sadr0b0t/metalrobot/README.md

metalrobot
==========

Металлический конструктор
