sadr0b0t/metalrobot/Robot Car/коробка/svg4export/README

Перед экспортом для производства (например, лазерной резики) разбить 
пунктирные линии на отдельные сегменты, иначе программа генерации 
задания для станка с ЧПУ будет рассматривать их как сплошные линии:
1. Разруппировать разворот
2. Выделить все пунктирные линии (или весь разворот)
3. Расширения > Изменение контура > Преобразовать в пунктир
