sadr0b0t/metalrobot/doc/robotcar-model2-инструкция-провода/инструкция-провода-Робот_Машинка-модель2-A5.pdf

Инструкция по сборке Робота Машинки подключение проводов

модель 2

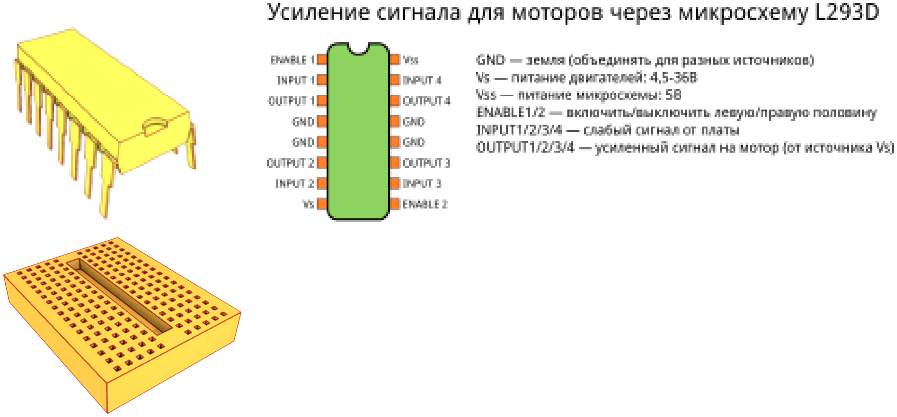
[picture p58: figure]

1

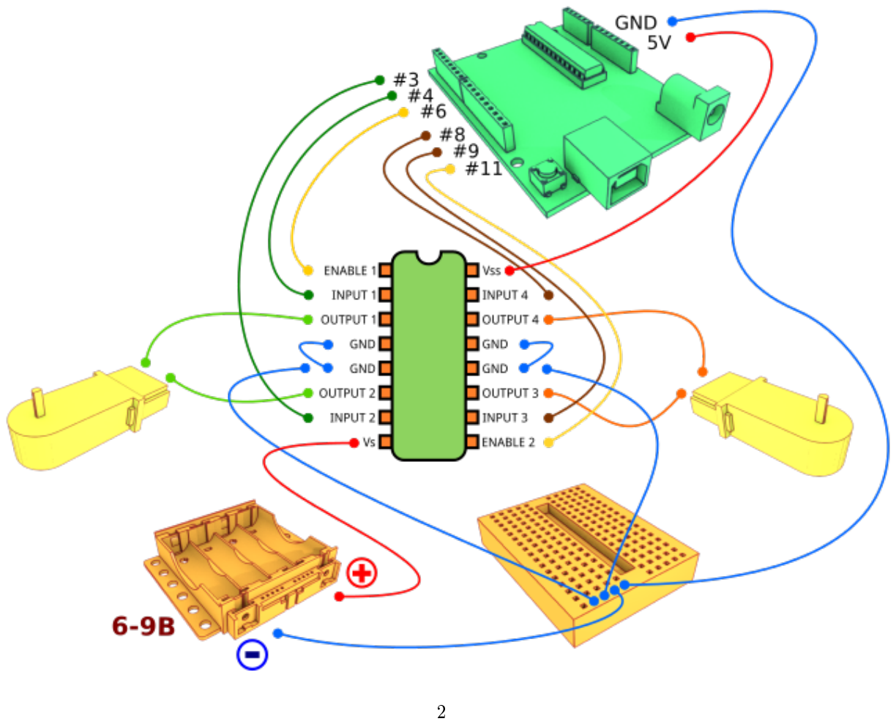
[picture p59: page 2]

2
