sadr0b0t/metalrobot/doc/robotcar-model2-инструкция-брошюра/компоненты - Робот Машинка модель2-A5.pdf

Детали набора Робот Машинка

модель 2

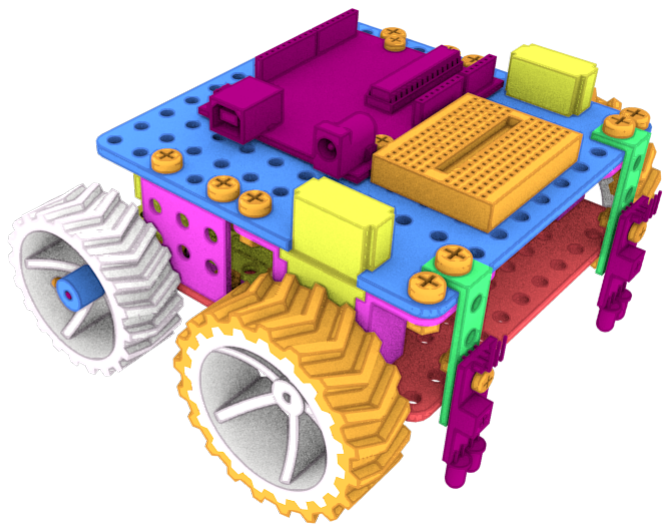
[picture p60: figure]
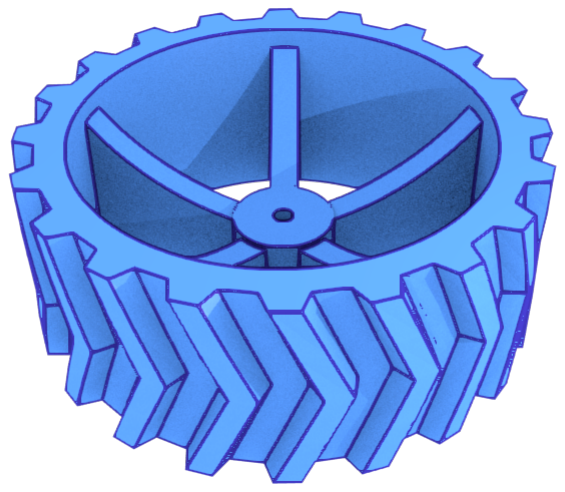
[picture p61: figure]

Колёса | 4 шт

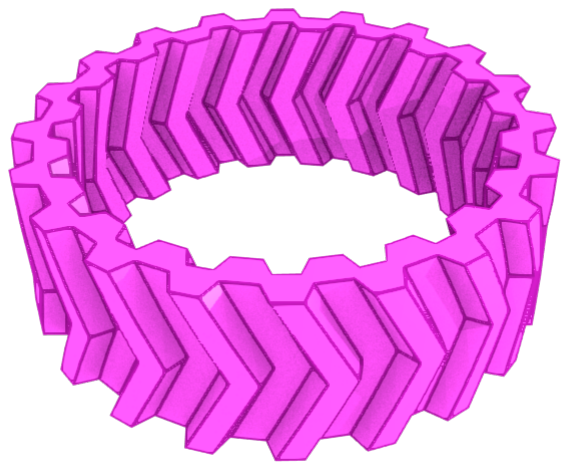
[picture p62: figure]

Покрышки | 2 шт

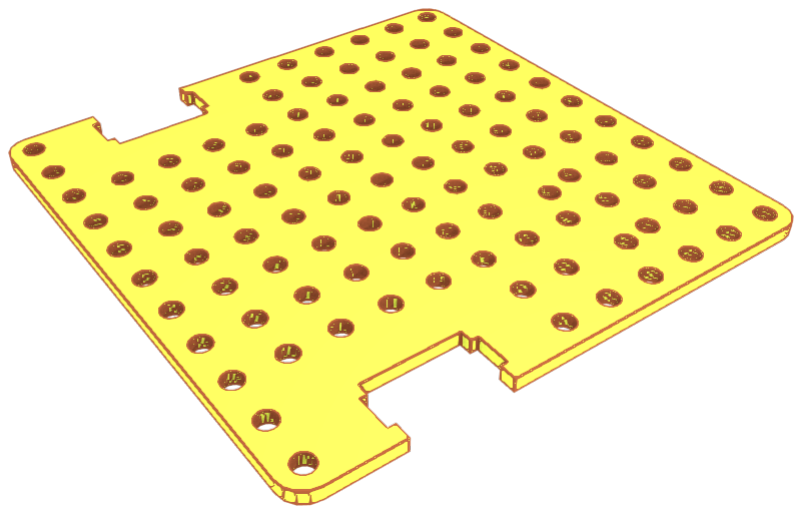
[picture p63: figure]

Верхняя часть корпуса | 1 шт

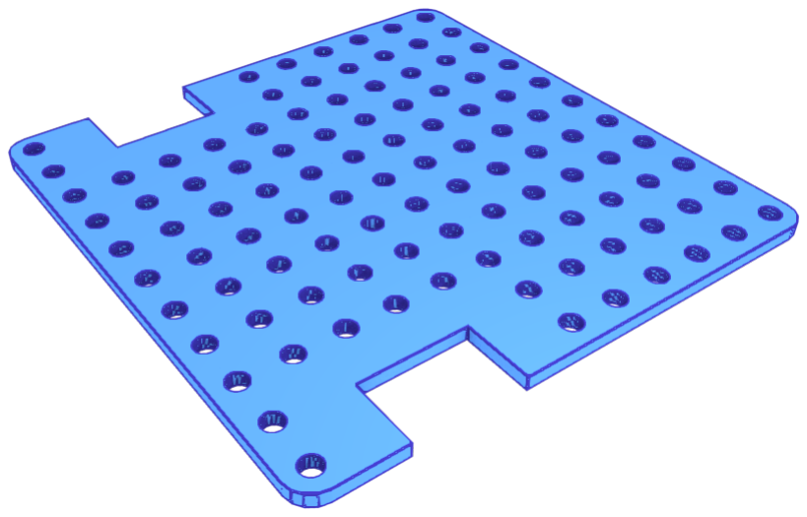
[picture p64: figure]

Нижняя часть корпуса | 1 шт

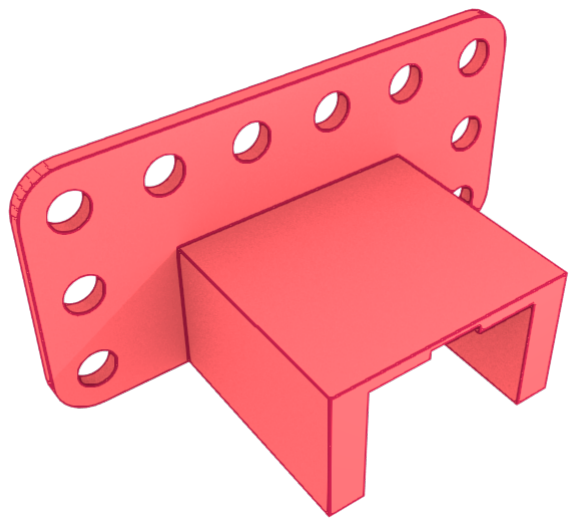
[picture p65: figure]

Крепления моторов | 2 шт

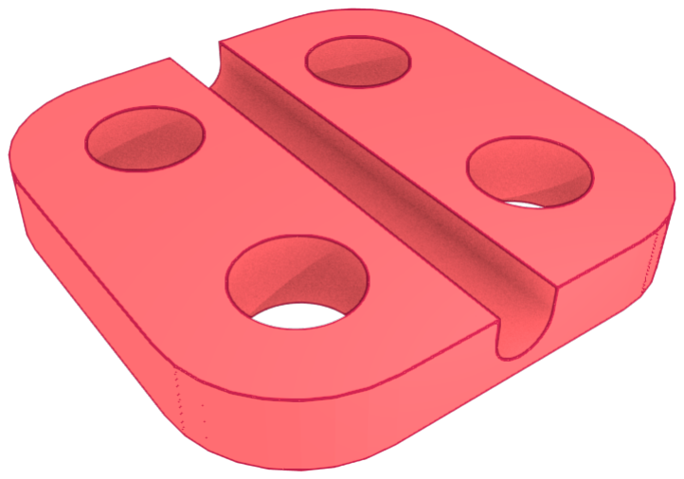
[picture p66: figure]

Направляющие для оси | 2 шт

Боковые стенки | 2 шт
Уголки | 4 шт
Ось для задних колес | 1 шт
Стопорные втулки на ось | 2 шт
Батарейный отсек 4 АА | 1 шт
Мотор-редуктор Pololu | 2 шт
Плата Arduino Uno | 1 шт

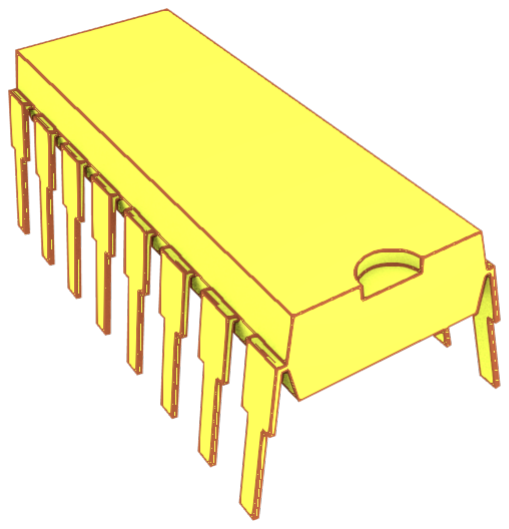
[picture p67: figure]

Микросхема L293D (или аналог) | 1 шт

Макетная плата 17х10 гнезд | 1 шт
Кабель USB A-B | 1 шт
Провод питания платы | 1 шт
Набор соединительных проводов | 1 шт
Шлейф 3 жилы розетка-штепсель | 2 шт
ИК датчик препятствий | 2 шт
Ультразвуковой дальномер | 1 шт

Винт M4x10 | 28 шт
Винт M4x12 | 8 шт
Винт M3x10 | 10 шт
Гайка M4 | 36 шт
Гайка M3 | 10 шт
Шайба пружинная M4 | 36 шт
Шайба пружинная M3 | 10 шт
