sadr0b0t/metalrobot/Robot Car/коробка/export/коробка-ровер-2мм.pdf

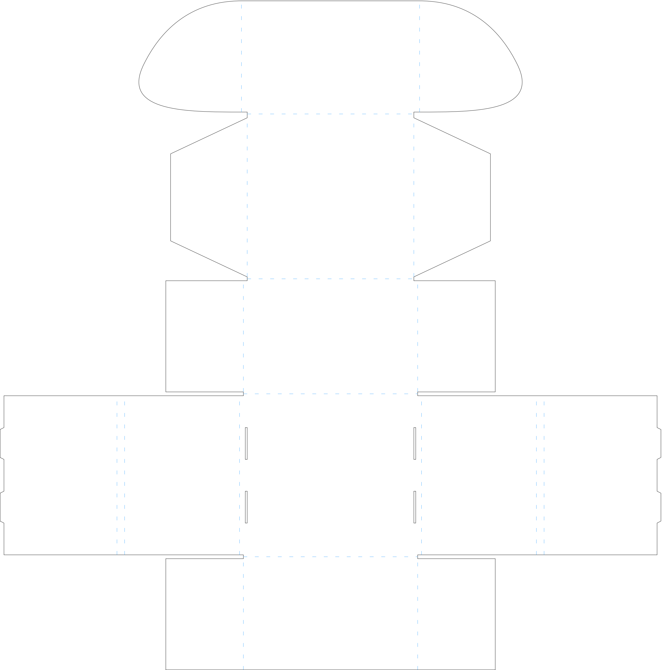
[picture p68: figure]
