sadr0b0t/metalrobot/inkscape/extensions/robotbox-devel/box-a4-w2mm.pdf

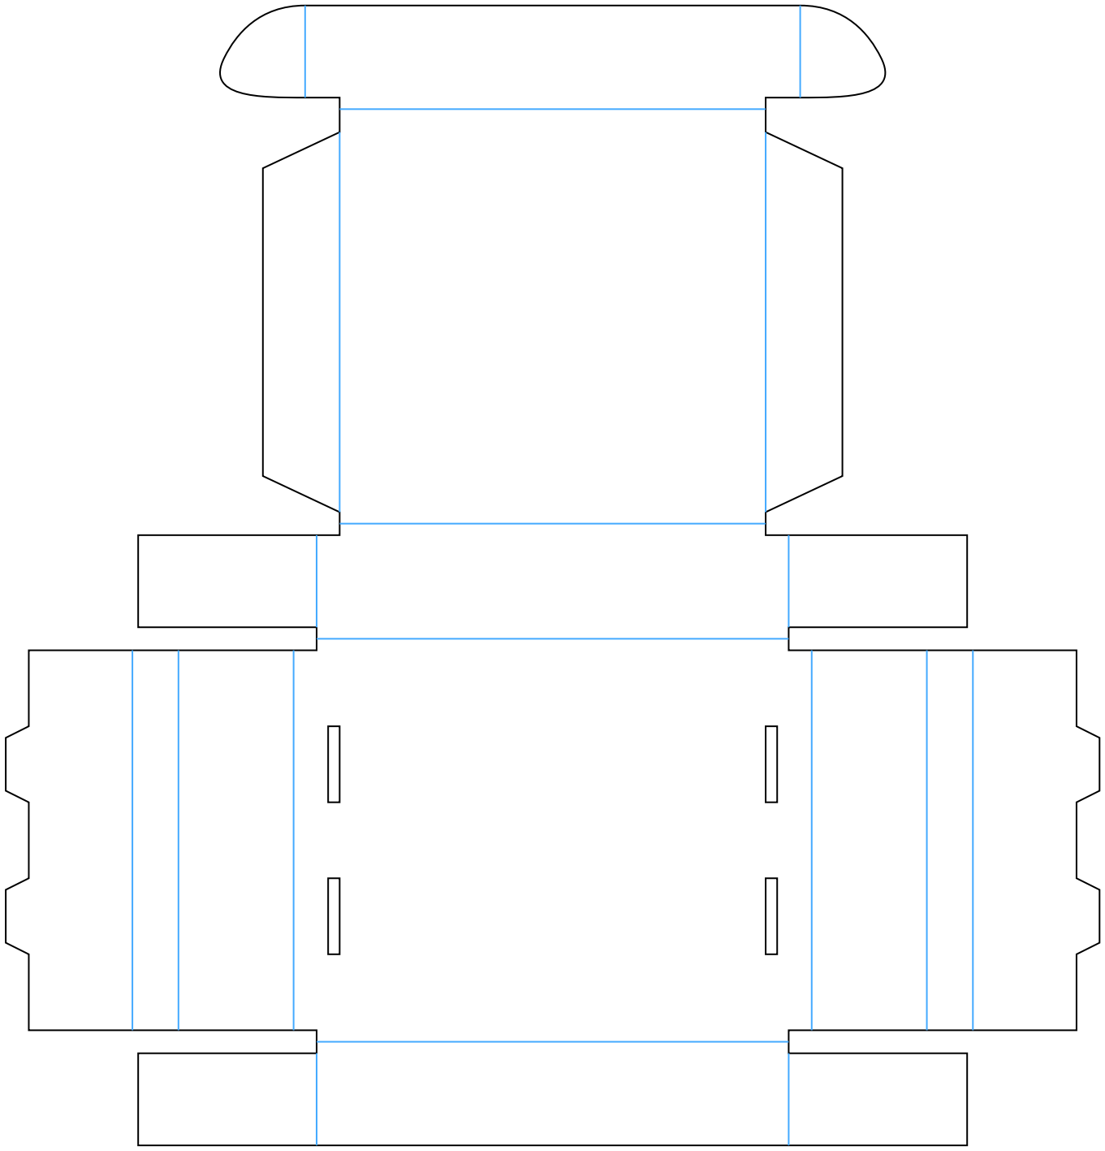
[picture p69: figure]
