sadr0b0t/metalrobot/inkscape/extensions/robotbox-devel/box-a4-w0.5mm.pdf

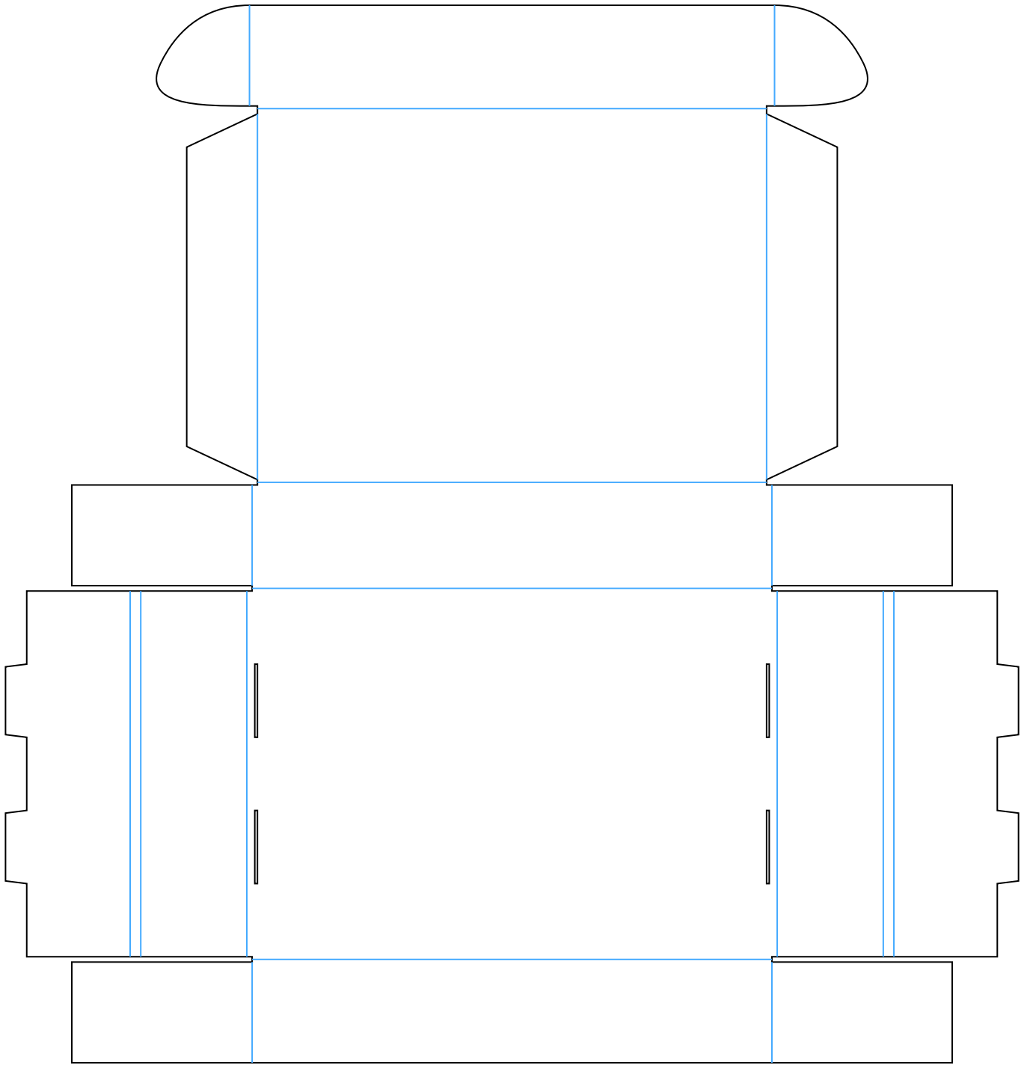
[picture p70: figure]
