sadr0b0t/metalrobot/doc/robotcar-model2-инструкция-компоненты/blender-render/render/arduino-uno-china-cherry.png

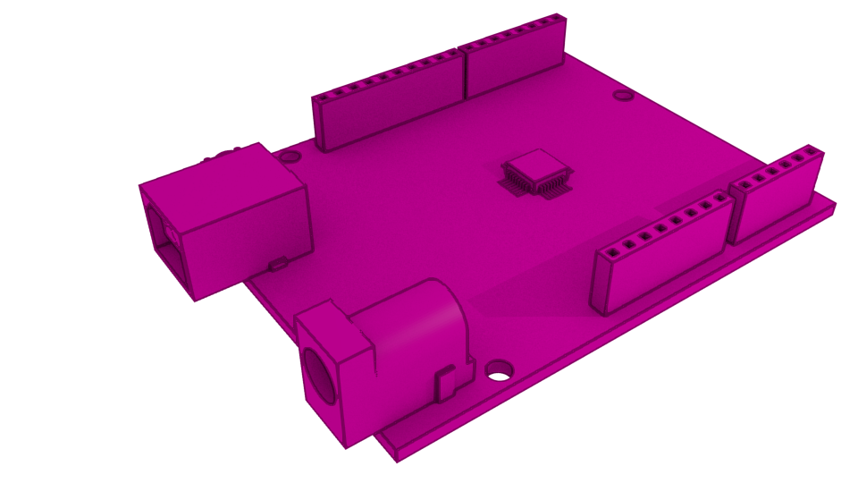
doc/robotcar-model2-инструкция-компоненты/blender-render/render/arduino-uno-china-cherry.png
