sadr0b0t/metalrobot/doc/robotcar-model2-инструкция-компоненты/blender-render/render/axis-d2mm-l150mm-view2-cherry.png

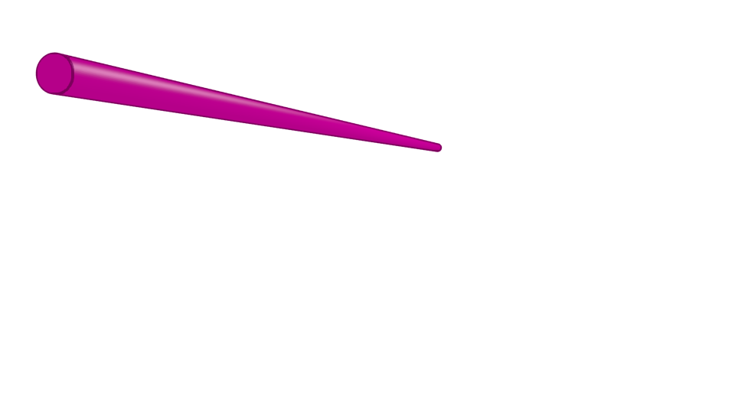
doc/robotcar-model2-инструкция-компоненты/blender-render/render/axis-d2mm-l150mm-view2-cherry.png
