sadr0b0t/metalrobot/doc/robotcar-model2-инструкция-компоненты/blender-render/render/axis-jam-with-screw-view2-blue.png

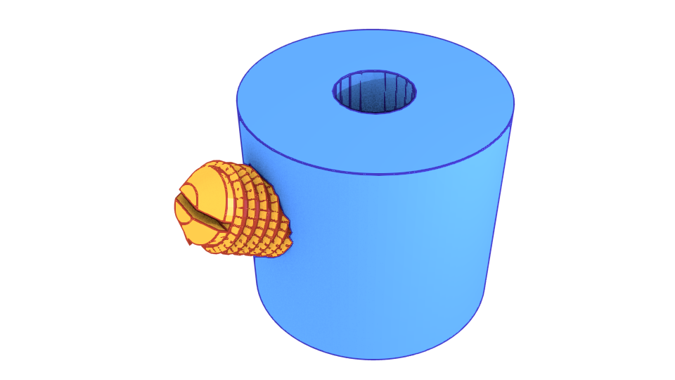
doc/robotcar-model2-инструкция-компоненты/blender-render/render/axis-jam-with-screw-view2-blue.png
