sadr0b0t/metalrobot/doc/robotcar-model2-инструкция-компоненты/blender-render/render/bus-3pin-female-male-blue.png

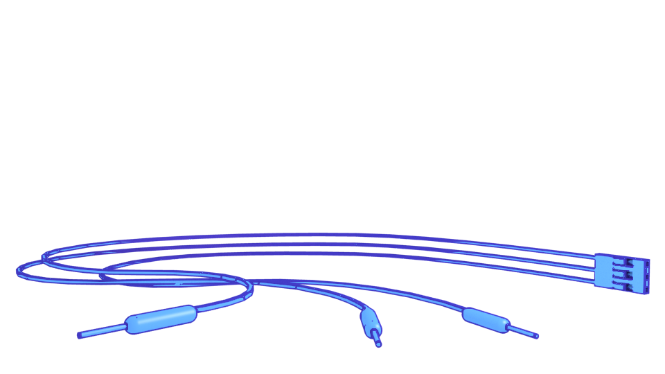
doc/robotcar-model2-инструкция-компоненты/blender-render/render/bus-3pin-female-male-blue.png
