sadr0b0t/metalrobot/doc/robotcar-model2-инструкция-компоненты/blender-render/render/chip-dip-2x8-dark.png

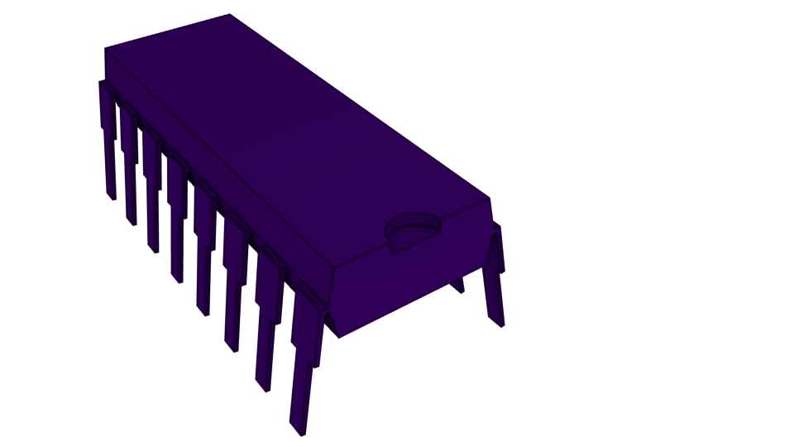
doc/robotcar-model2-инструкция-компоненты/blender-render/render/chip-dip-2x8-dark.png
