sadr0b0t/metalrobot/doc/robotcar-model2-инструкция-компоненты/blender-render/render/chipkit-uno32-view2-cherry.png

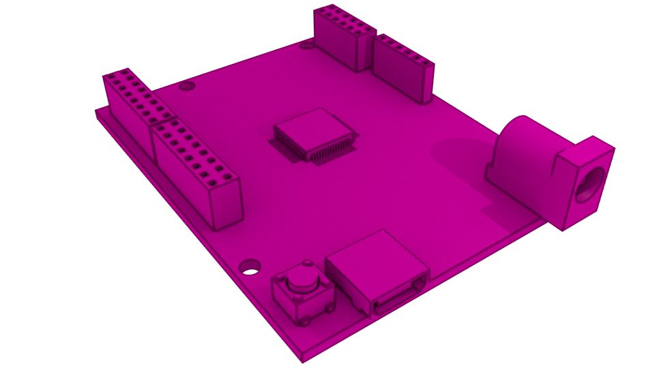
doc/robotcar-model2-инструкция-компоненты/blender-render/render/chipkit-uno32-view2-cherry.png
