sadr0b0t/metalrobot/doc/robotcar-model2-инструкция-компоненты/blender-render/render/frame-bottom-yellow.png

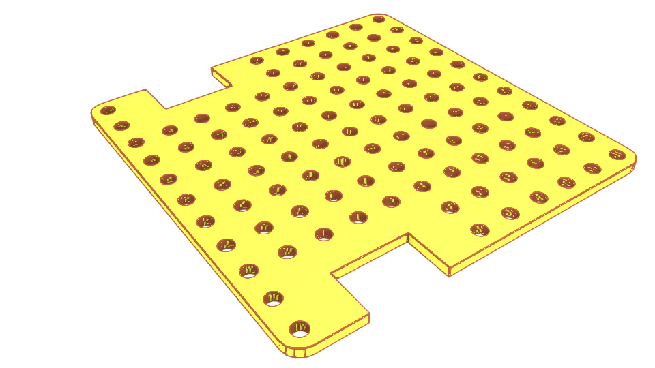
doc/robotcar-model2-инструкция-компоненты/blender-render/render/frame-bottom-yellow.png
