sadr0b0t/metalrobot/doc/robotcar-model2-инструкция-компоненты/blender-render/render/screws/crosshead-screw-m3x26-orange.png

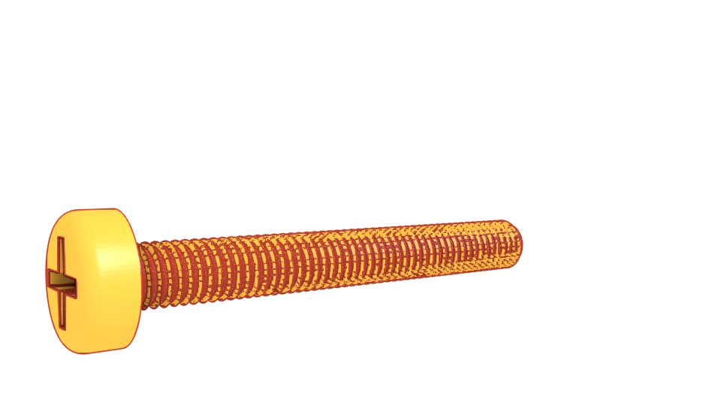
doc/robotcar-model2-инструкция-компоненты/blender-render/render/screws/crosshead-screw-m3x26-orange.png
