sadr0b0t/metalrobot/doc/robotcar-model2-инструкция-компоненты/blender-render/render/screws/ISOThread-default/crosshead-screw-m4x40-orange.png

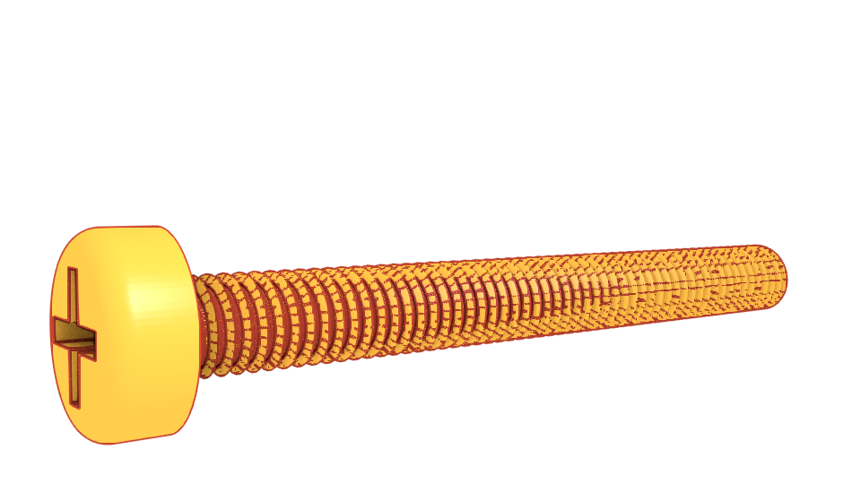
doc/robotcar-model2-инструкция-компоненты/blender-render/render/screws/ISOThread-default/crosshead-screw-m4x40-orange.png
