sadr0b0t/metalrobot/doc/robotcar-model2-инструкция-компоненты/blender-render/render/wheel1.png

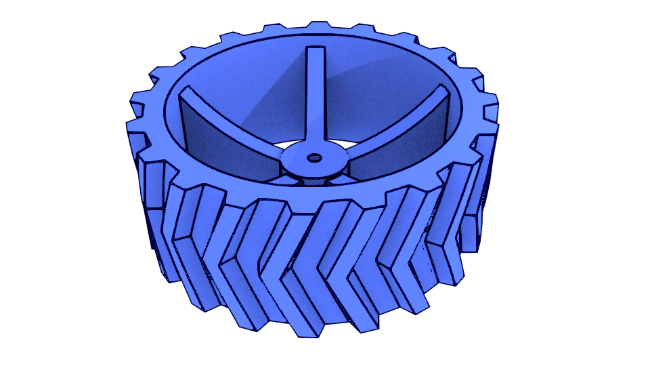
doc/robotcar-model2-инструкция-компоненты/blender-render/render/wheel1.png
