sadr0b0t/metalrobot/doc/robotcar-model2-инструкция-компоненты/export-png/компоненты-03.png

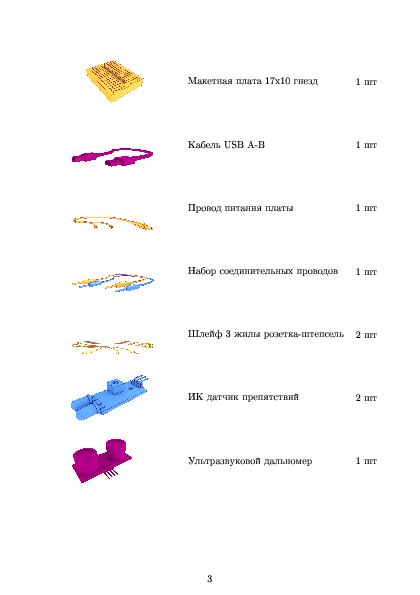
doc/robotcar-model2-инструкция-компоненты/export-png/компоненты-03.png
