sadr0b0t/metalrobot/doc/robotcar-model2-инструкция-компоненты/export-png/компоненты-04.png

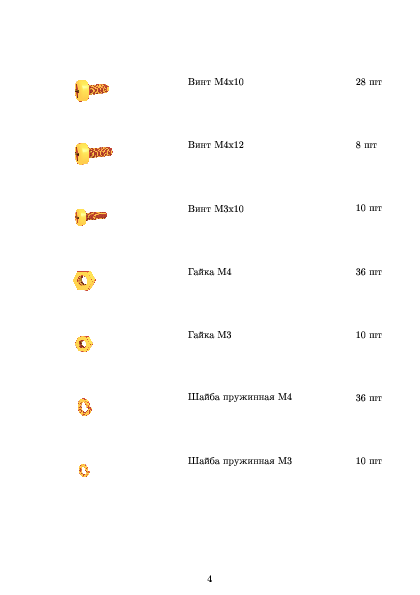
doc/robotcar-model2-инструкция-компоненты/export-png/компоненты-04.png
