sadr0b0t/metalrobot/doc/robotcar-model2-инструкция-компоненты/fig/model2-render3.png

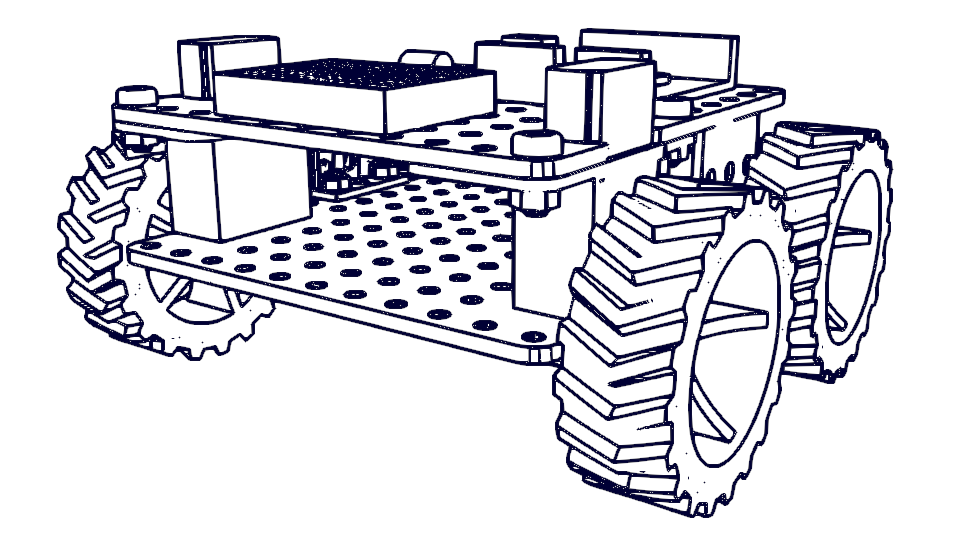
doc/robotcar-model2-инструкция-компоненты/fig/model2-render3.png
