sadr0b0t/metalrobot/doc/robotcar-model2-инструкция-компоненты/fig/robotcar-sideview.jpg

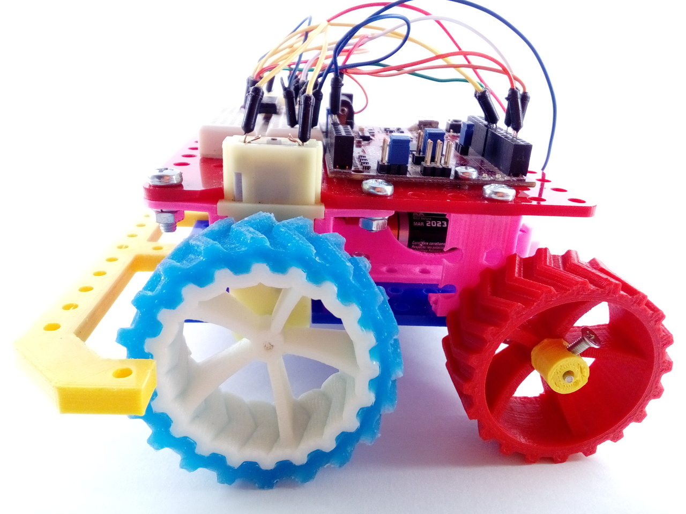
doc/robotcar-model2-инструкция-компоненты/fig/robotcar-sideview.jpg
