sadr0b0t/metalrobot/doc/robotcar-model2-инструкция-корпус/blender-render/render-instr/03-top-block1-dev-view3.png

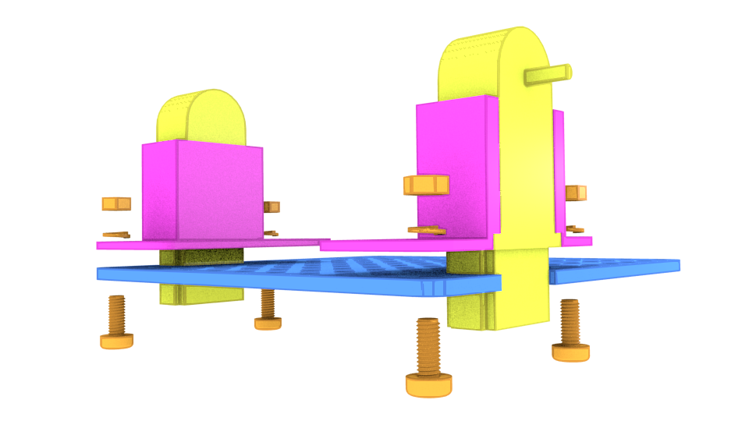
doc/robotcar-model2-инструкция-корпус/blender-render/render-instr/03-top-block1-dev-view3.png
