sadr0b0t/metalrobot/doc/robotcar-model2-инструкция-корпус/blender-render/render-instr/04-top-block1-view1.png

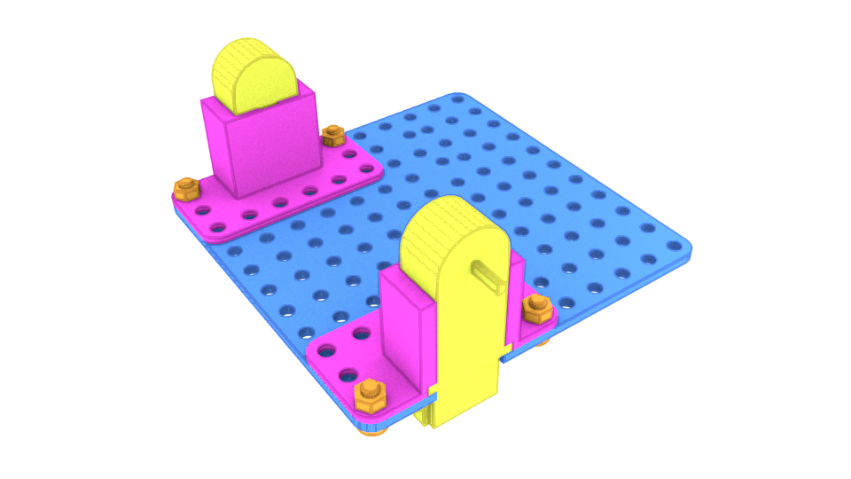
doc/robotcar-model2-инструкция-корпус/blender-render/render-instr/04-top-block1-view1.png
