sadr0b0t/metalrobot/doc/robotcar-model2-инструкция-корпус/blender-render/render-instr/15-frame-block2-dev1-view2.png

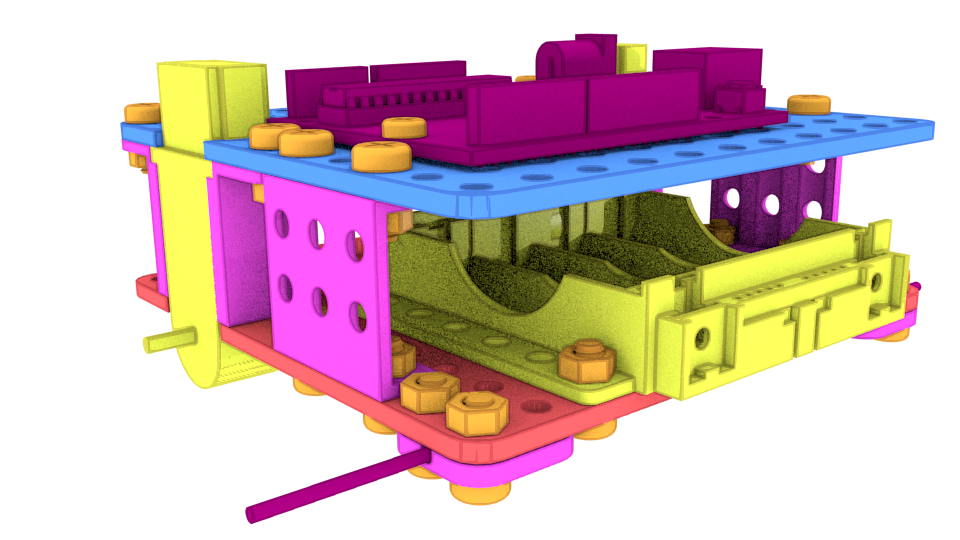
doc/robotcar-model2-инструкция-корпус/blender-render/render-instr/15-frame-block2-dev1-view2.png
