sadr0b0t/metalrobot/doc/robotcar-model2-инструкция-корпус/blender-render/render-instr/16-frame-block2-dev2-view1.png

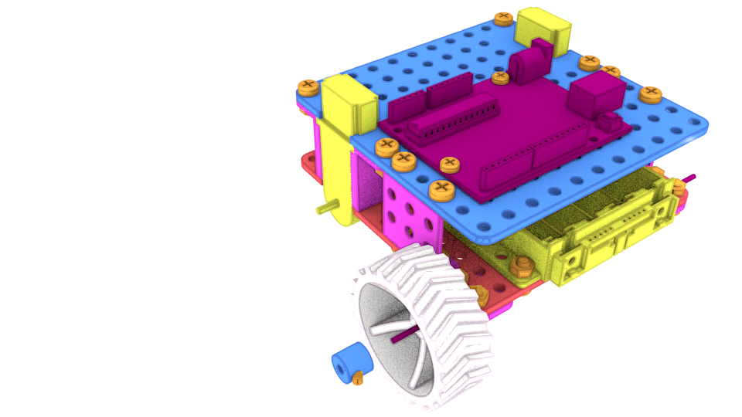
doc/robotcar-model2-инструкция-корпус/blender-render/render-instr/16-frame-block2-dev2-view1.png
