sadr0b0t/metalrobot/doc/robotcar-model2-инструкция-корпус/blender-render/render-instr/19-wheel-and-tyre-view1.png

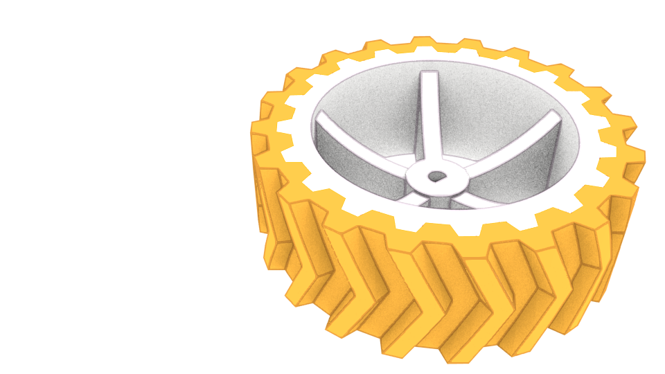
doc/robotcar-model2-инструкция-корпус/blender-render/render-instr/19-wheel-and-tyre-view1.png
