sadr0b0t/metalrobot/doc/robotcar-model2-инструкция-корпус/blender-render/render-instr/20-frame-block3-dev-view3.png

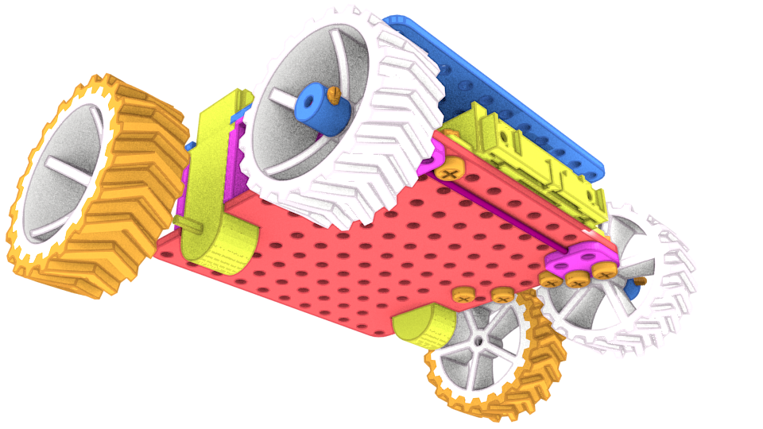
doc/robotcar-model2-инструкция-корпус/blender-render/render-instr/20-frame-block3-dev-view3.png
