sadr0b0t/metalrobot/doc/robotcar-model2-инструкция-корпус/blender-render/render-instr/21-frame-block3-view2.png

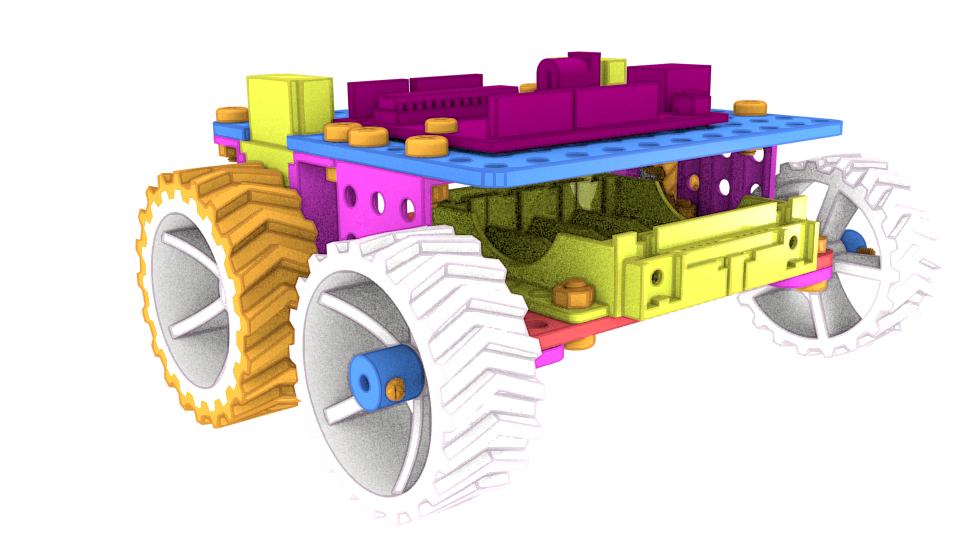
doc/robotcar-model2-инструкция-корпус/blender-render/render-instr/21-frame-block3-view2.png
