sadr0b0t/metalrobot/doc/robotcar-model2-инструкция-корпус/blender-render/render/robotcar-model2-skeleton.png

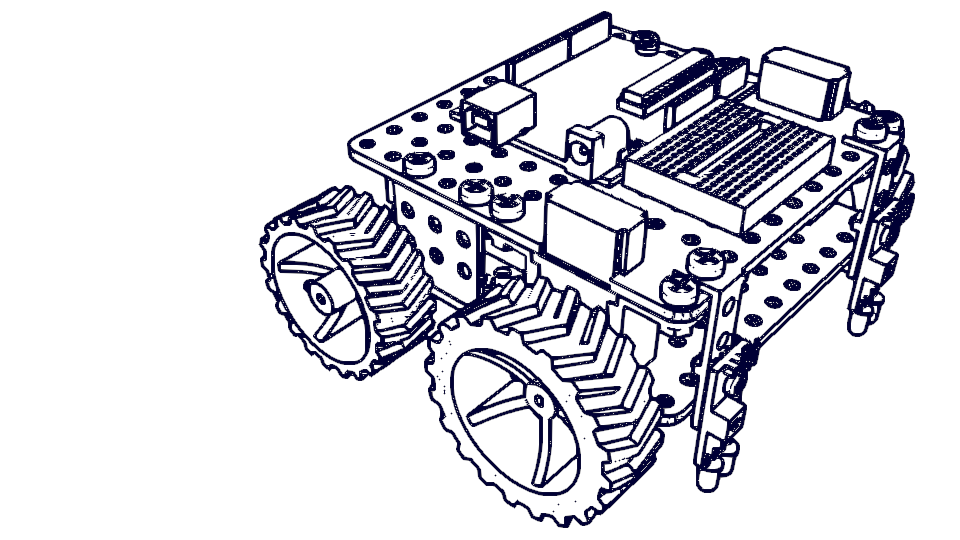
doc/robotcar-model2-инструкция-корпус/blender-render/render/robotcar-model2-skeleton.png
