sadr0b0t/metalrobot/doc/robotcar-model2-инструкция-провода/instr-pages/export-png/01-connect-motors.png

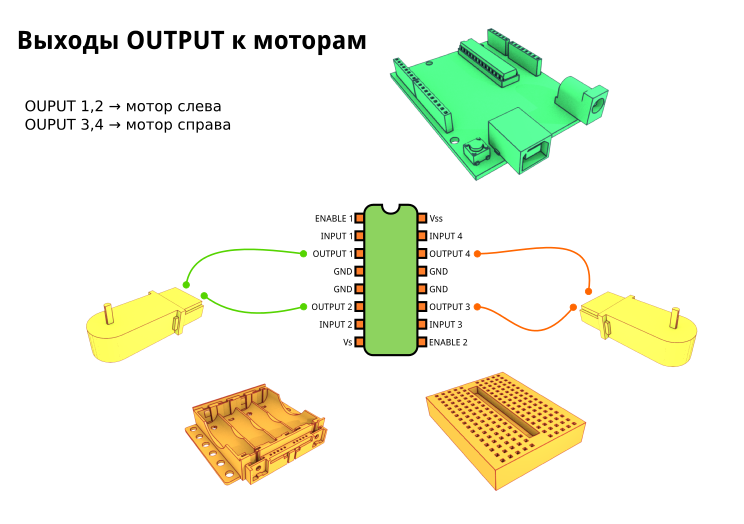
doc/robotcar-model2-инструкция-провода/instr-pages/export-png/01-connect-motors.png
