sadr0b0t/metalrobot/doc/robotcar-model2-инструкция-провода/instr-pages/export-png/02-connect-inputs.png

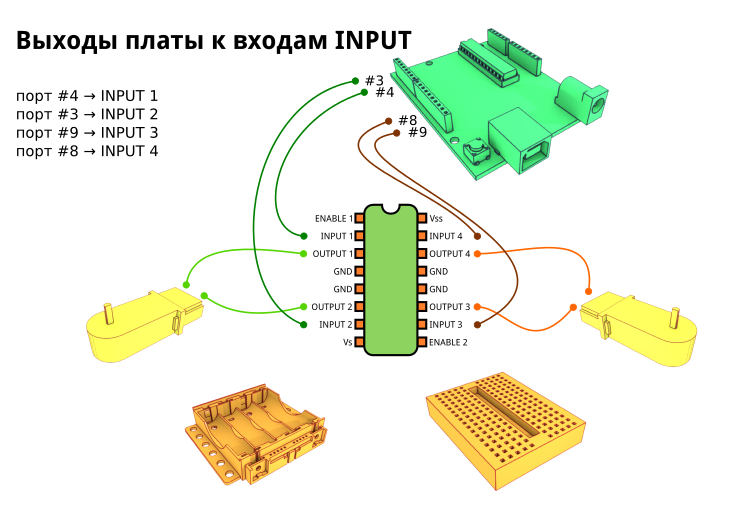
doc/robotcar-model2-инструкция-провода/instr-pages/export-png/02-connect-inputs.png
