sadr0b0t/metalrobot/doc/robotcar-model2-инструкция-провода/instr-pages/export-png/04-combine-ext-GND.png

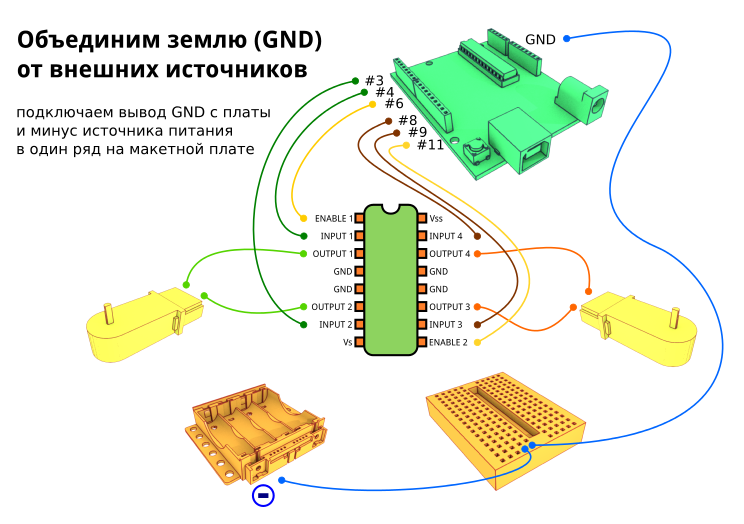
doc/robotcar-model2-инструкция-провода/instr-pages/export-png/04-combine-ext-GND.png
