sadr0b0t/metalrobot/doc/robotcar-model2-инструкция-провода/instr-pages/export-png/07-connect-VS.png

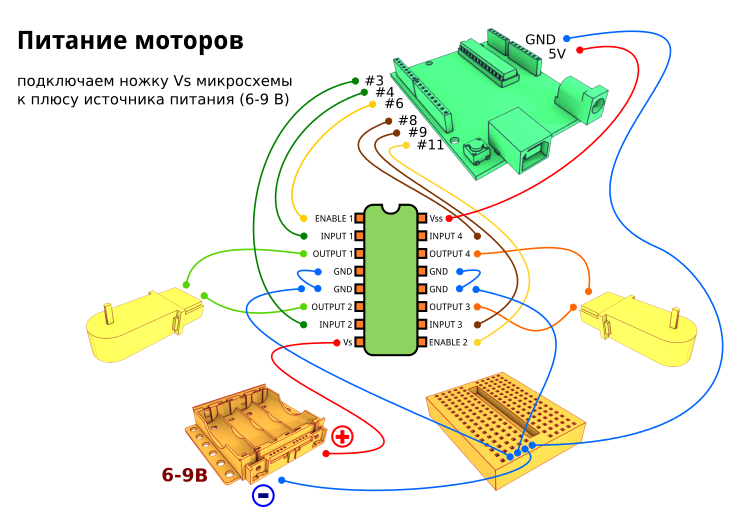
doc/robotcar-model2-инструкция-провода/instr-pages/export-png/07-connect-VS.png
