sadr0b0t/metalrobot/gearbox/gearbox-prototype5/rod-3mm.png

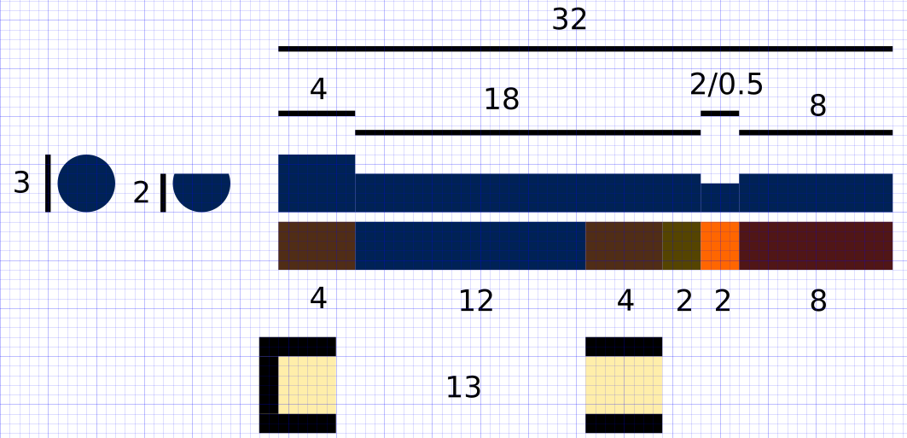
gearbox/gearbox-prototype5/rod-3mm.png
