sadr0b0t/metalrobot/Robot Car/коробка/design1/sadrobot.su-qr.gif

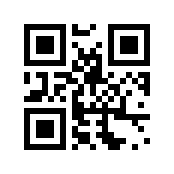
Robot Car/коробка/design1/sadrobot.su-qr.gif
