sadr0b0t/metalrobot/Robot Car/уроки/по линии/robotcar_line.png

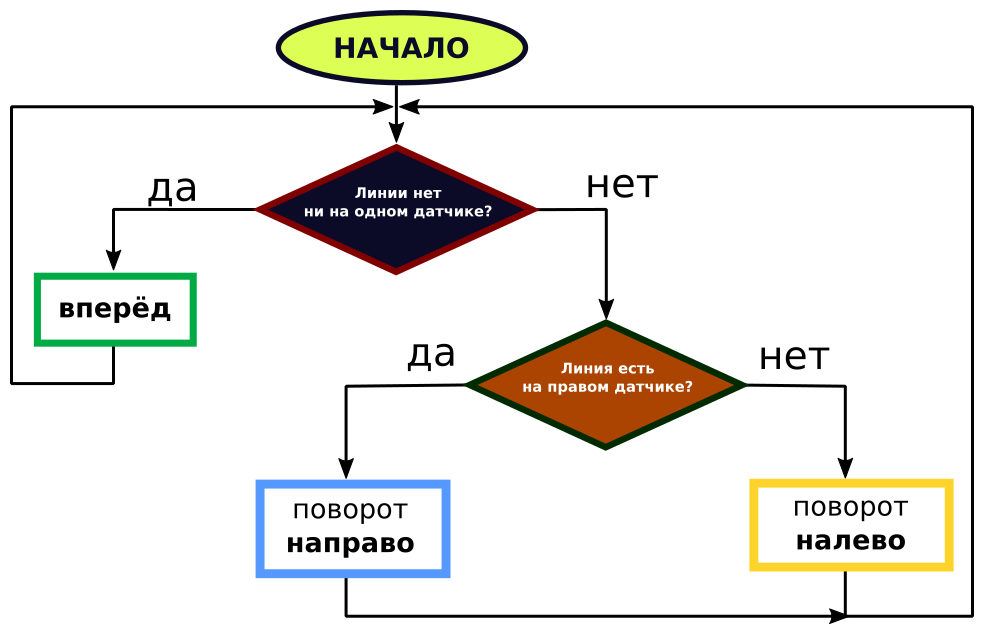
Robot Car/уроки/по линии/robotcar_line.png
