sadr0b0t/metalrobot/components-3d/screws/3pty/README.txt

Сторонние библиотеки
Third party libraries

ISOThread - генератор винтов и гаек (Creative Commons - Public Domain Dedication license.)
Trevor Moseley
http://www.thingiverse.com/thing:311031
