sadr0b0t/metalrobot/parts/export/all-details.png

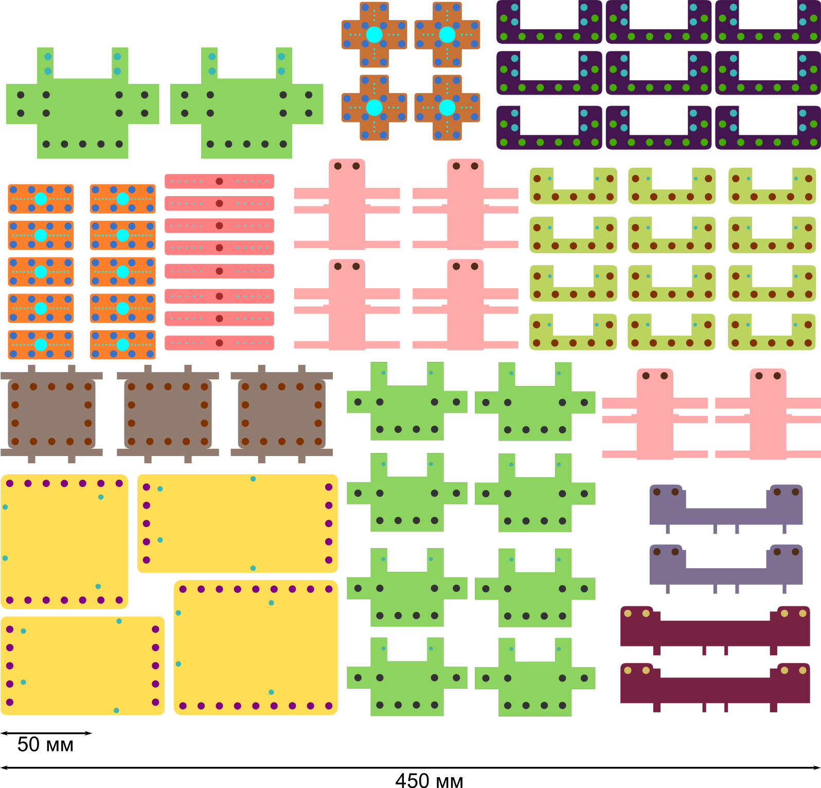
parts/export/all-details.png
