sadr0b0t/metalrobot/battery-holder/contacts-draft2/export/wire-plate2.dxf

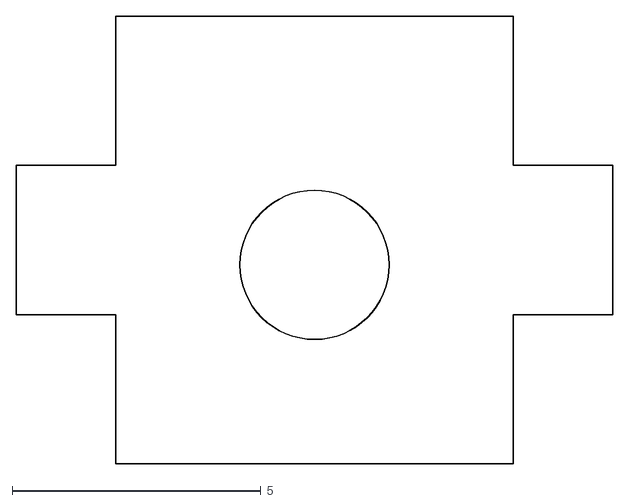
[picture p118: CAD file, 2015-09-19]
battery-holder/contacts-draft2/export/wire-plate2.dxf
12.0 x 9.00
