sadr0b0t/metalrobot/battery-holder/contacts-draft4/export/wire-plate1.dxf

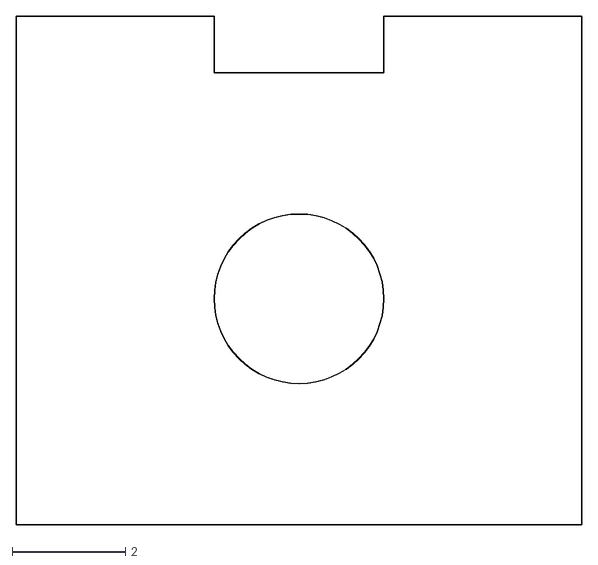
[picture p119: CAD file, 2016-01-24]
battery-holder/contacts-draft4/export/wire-plate1.dxf
10.0 x 9.00
