sadr0b0t/metalrobot/battery-holder/credits-43d.dxf

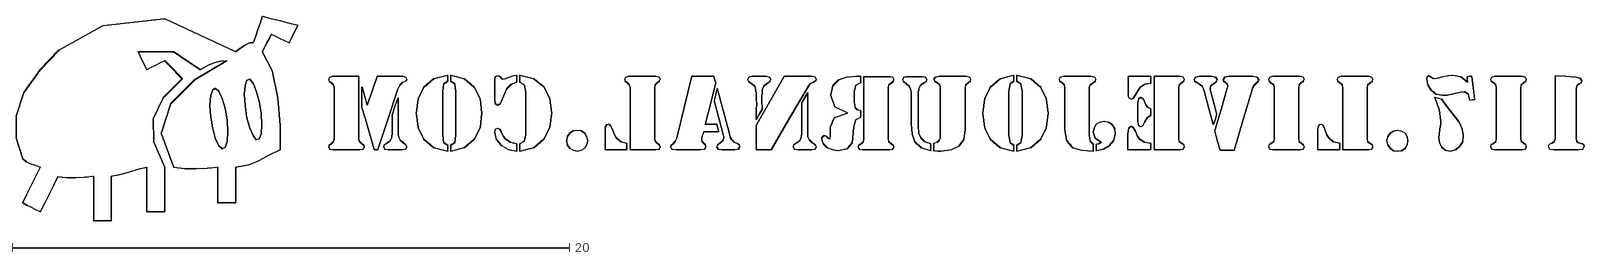
[picture p120: CAD file, 2015-12-16]
battery-holder/credits-43d.dxf
56.3 x 7.33
