sadr0b0t/metalrobot/battery-holder/export/battery-aa-holder-4-mod4.stl

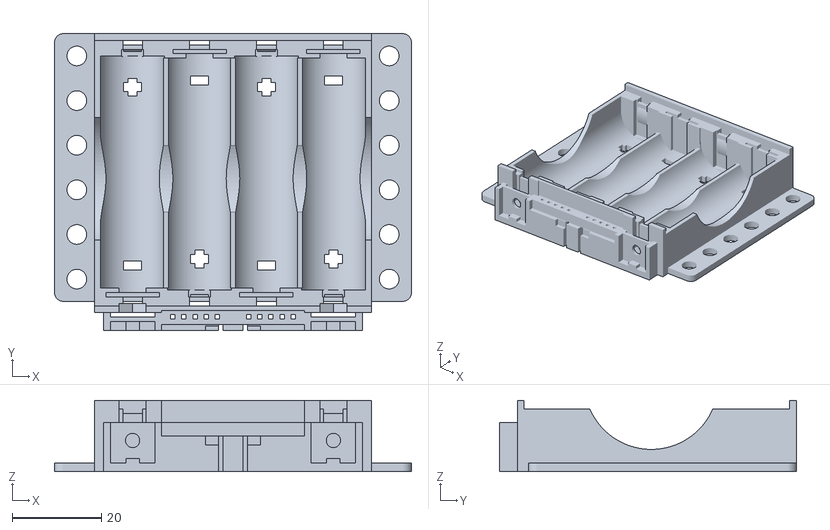
[picture p121: CAD file, 2016-04-05]
battery-holder/export/battery-aa-holder-4-mod4.stl
80.0 x 66.5 x 16.0
