sadr0b0t/metalrobot/brbrd-bender/brbrd-bender-socket-43d.dxf

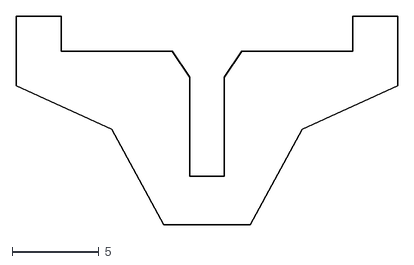
[picture p122: CAD file, 2015-12-28]
brbrd-bender/brbrd-bender-socket-43d.dxf
22.0 x 12.0
