sadr0b0t/metalrobot/brbrd-bender/export/brbrd-bender-plug-pe0.3.stl

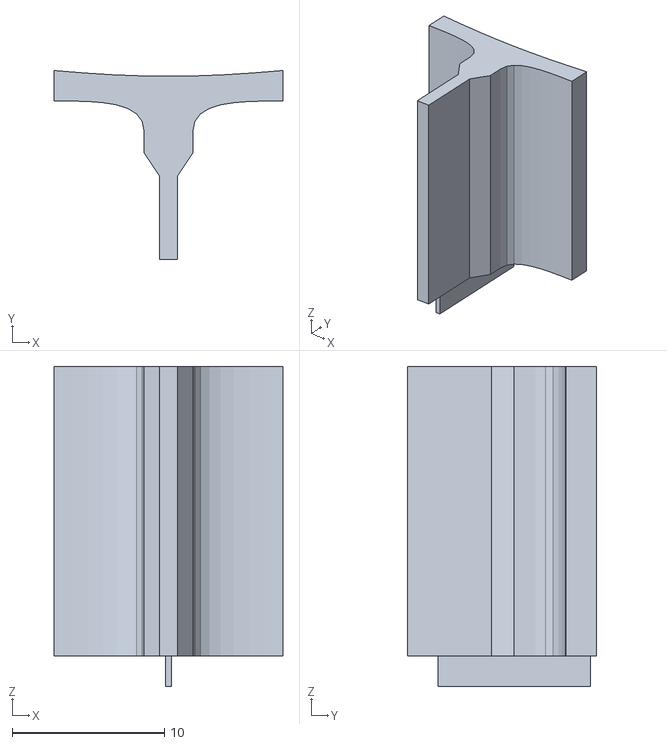
[picture p123: CAD file, 2016-02-06]
brbrd-bender/export/brbrd-bender-plug-pe0.3.stl
15.0 x 12.4 x 21.0
