sadr0b0t/metalrobot/components-3d/wires/export/u-shape_terminal.stl

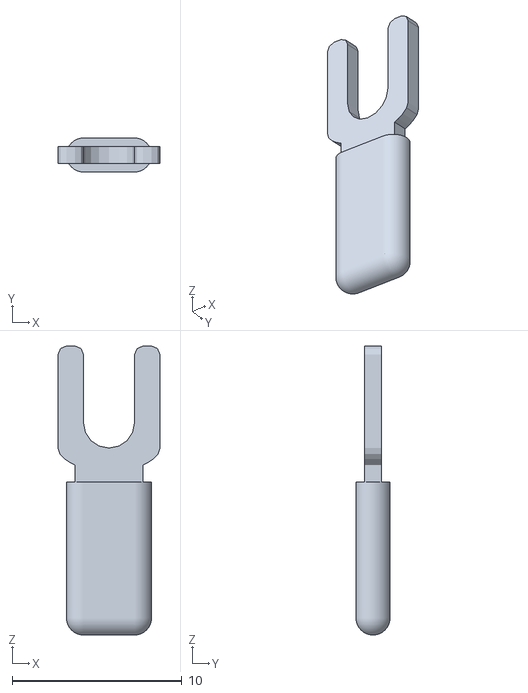
[picture p124: CAD file, 2016-05-25]
components-3d/wires/export/u-shape_terminal.stl
6.00 x 2.00 x 17.0
