sadr0b0t/metalrobot/components-3d/wires/wire2-core1-d2mm-43d.dxf

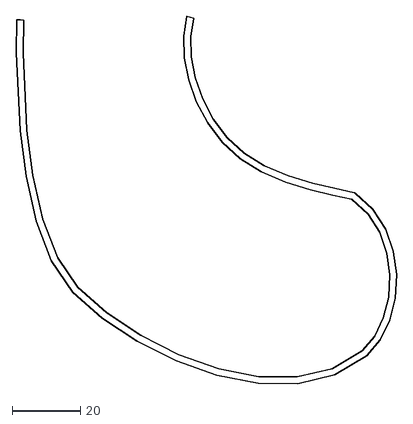
[picture p125: CAD file, 2016-05-25]
components-3d/wires/wire2-core1-d2mm-43d.dxf
111.4 x 107.6
