sadr0b0t/metalrobot/doc/robotcar-model2-инструкция-компоненты/blender-render/stl-addons/tyre_inner_surface.stl

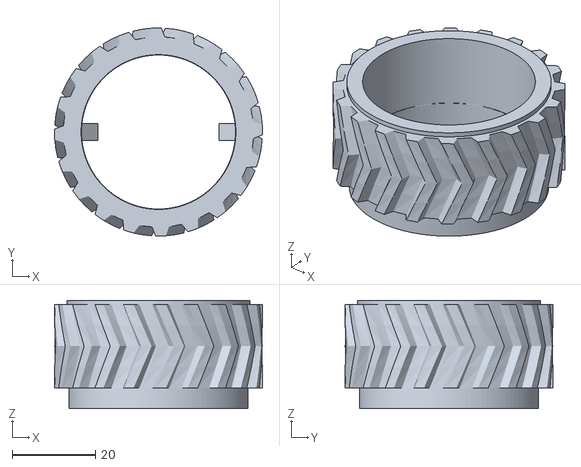
[picture p126: CAD file, 2016-05-22]
doc/robotcar-model2-инструкция-компоненты/blender-render/stl-addons/tyre_inner_surface.stl
50.0 x 50.0 x 26.0
