sadr0b0t/metalrobot/doc/robotcar-model2-инструкция-корпус/blender-render/stl-components/sonar.stl

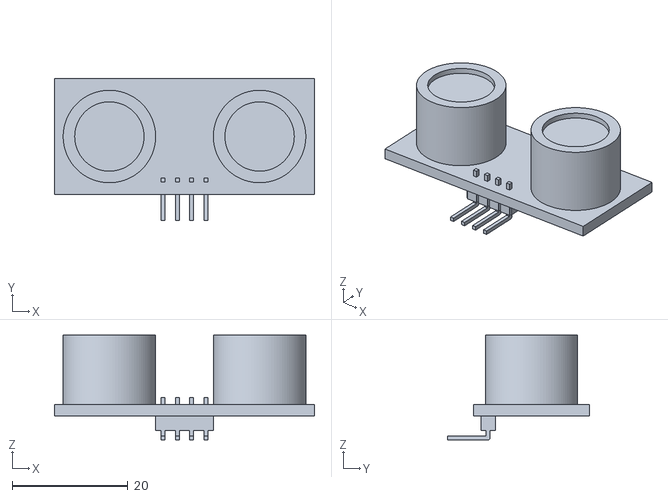
[picture p127: CAD file, 2016-06-06]
doc/robotcar-model2-инструкция-корпус/blender-render/stl-components/sonar.stl
45.0 x 24.5 x 18.1
