sadr0b0t/metalrobot/doc/robotcar-model2-инструкция-корпус/blender-render/stl-parts/frame-bottom.stl

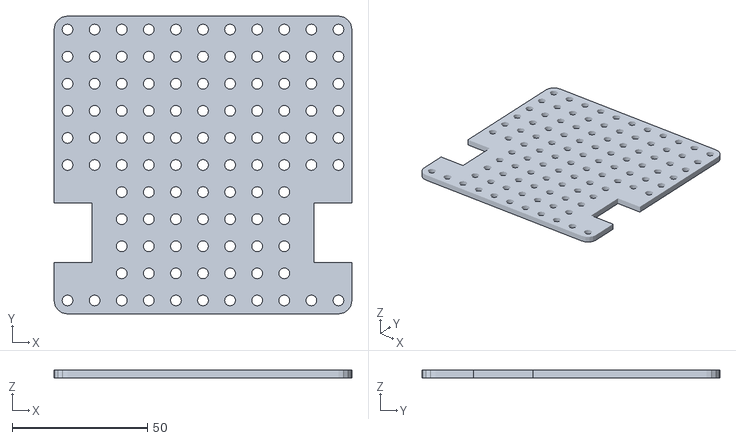
[picture p128: CAD file, 2016-05-25]
doc/robotcar-model2-инструкция-корпус/blender-render/stl-parts/frame-bottom.stl
110.0 x 110.0 x 3.00
