sadr0b0t/metalrobot/gearbox/gearbox-prototype5/export/gearbox-half-motor.stl

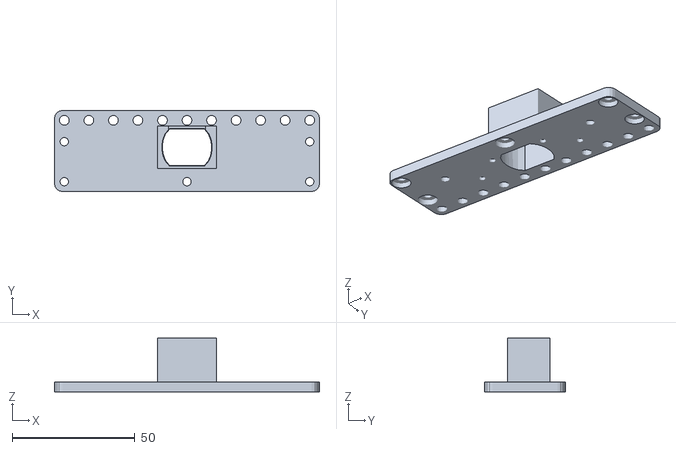
[picture p129: CAD file, 2015-09-13]
gearbox/gearbox-prototype5/export/gearbox-half-motor.stl
108.0 x 33.0 x 21.9
