sadr0b0t/metalrobot/gearbox/gearbox-prototype5/gears/gear-pa20-cp1.5-t12.dxf

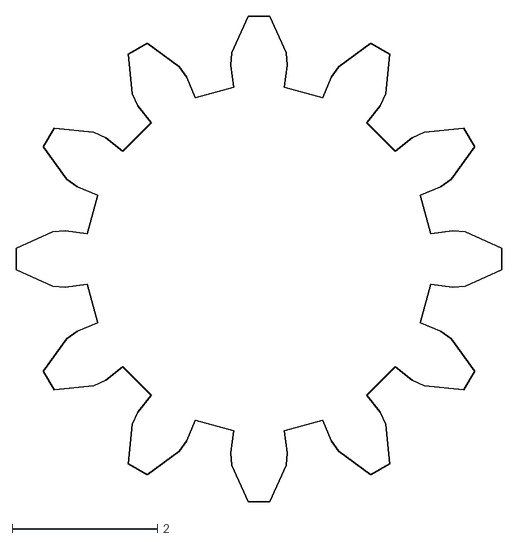
[picture p130: CAD file, 2015-08-13]
gearbox/gearbox-prototype5/gears/gear-pa20-cp1.5-t12.dxf
6.68 x 6.68
