sadr0b0t/metalrobot/gearbox/gears-3dprint-tests/export/gears-cp1.5-t9-d3.stl

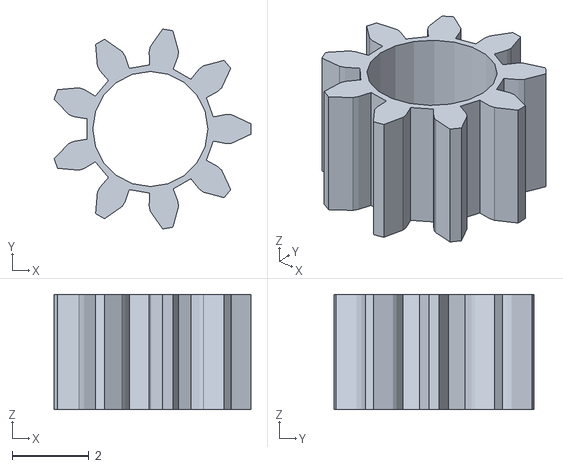
[picture p131: CAD file, 2015-07-16]
gearbox/gears-3dprint-tests/export/gears-cp1.5-t9-d3.stl
5.13 x 5.21 x 3.00
