sadr0b0t/metalrobot/gearbox/gears-3dprint-tests/gear-cp1.5-t27.dxf

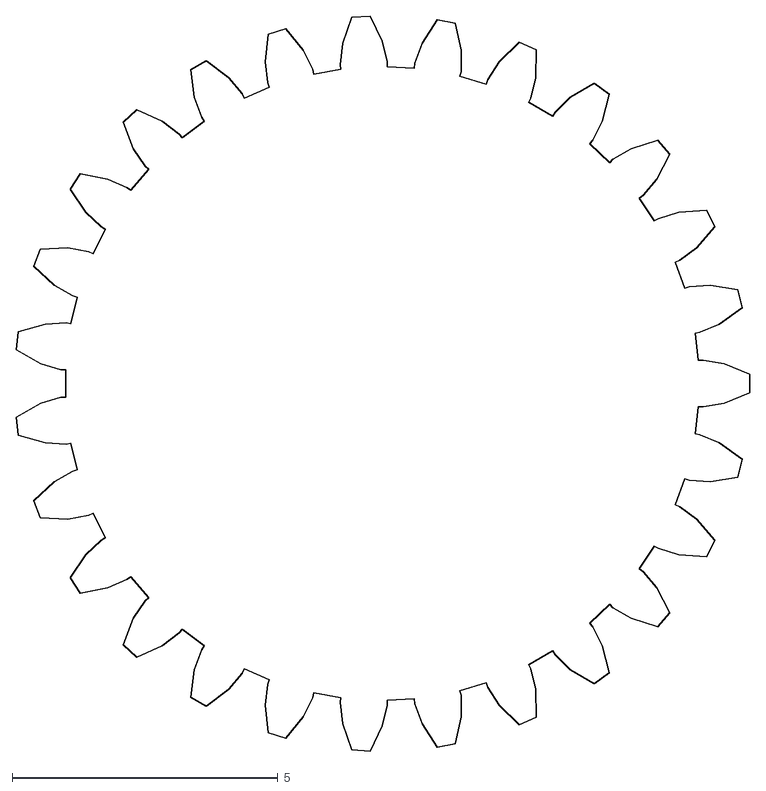
[picture p132: CAD file, 2015-07-16]
gearbox/gears-3dprint-tests/gear-cp1.5-t27.dxf
13.8 x 13.8
