sadr0b0t/metalrobot/gearbox4stepper/stepper-rack-prototype1/box/export-pe0.1/smg-gear_transmission1-pe0.1.stl

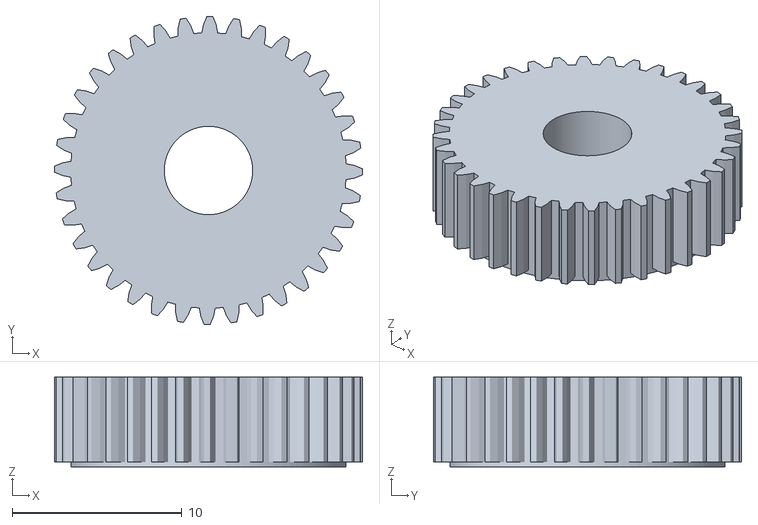
[picture p133: CAD file, 2018-05-07]
gearbox4stepper/stepper-rack-prototype1/box/export-pe0.1/smg-gear_transmission1-pe0.1.stl
18.1 x 18.1 x 5.30
