sadr0b0t/metalrobot/gearbox4stepper/stepper-rack-prototype1/box/export-pe0.2/smg-gear_motor-ds-pe0.2.stl

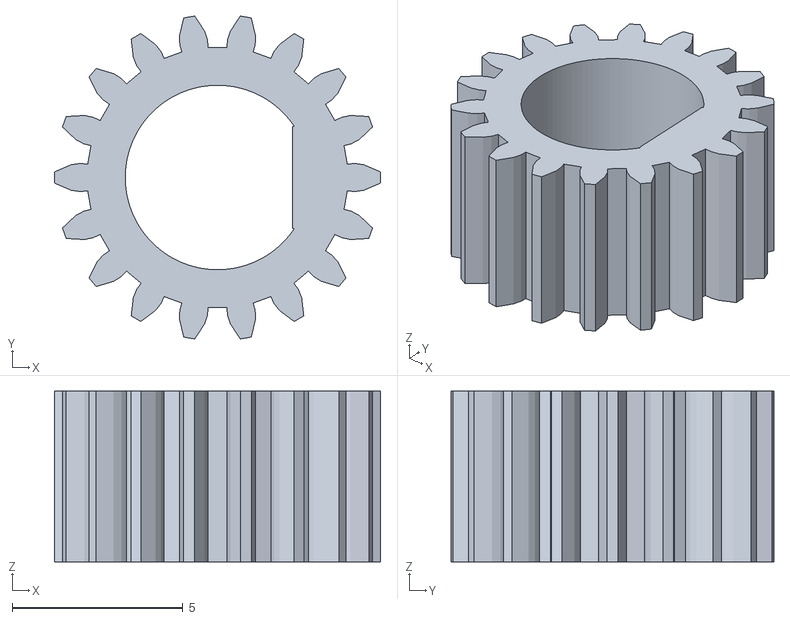
[picture p134: CAD file, 2018-05-07]
gearbox4stepper/stepper-rack-prototype1/box/export-pe0.2/smg-gear_motor-ds-pe0.2.stl
9.54 x 9.46 x 5.00
