sadr0b0t/metalrobot/gearbox4stepper/stepper-rack-prototype1/box/motor_face.dxf

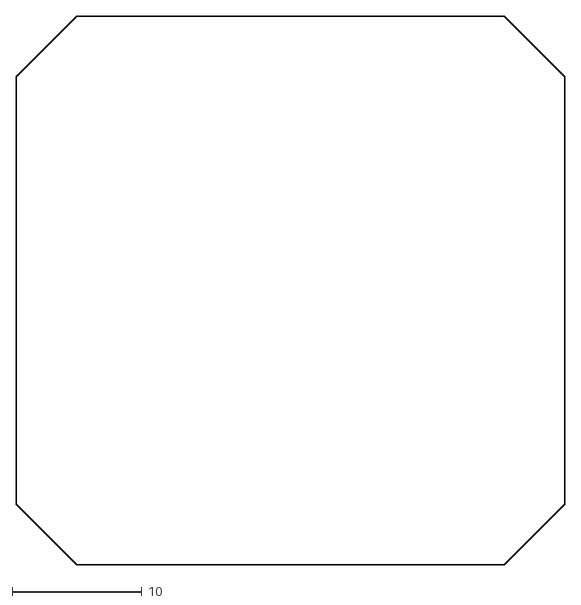
[picture p135: CAD file, 2018-05-07]
gearbox4stepper/stepper-rack-prototype1/box/motor_face.dxf
42.3 x 42.3
