sadr0b0t/metalrobot/gearbox4stepper/stepper-rack-prototype1/gears/rack-pa20-cp1.5-l160.dxf

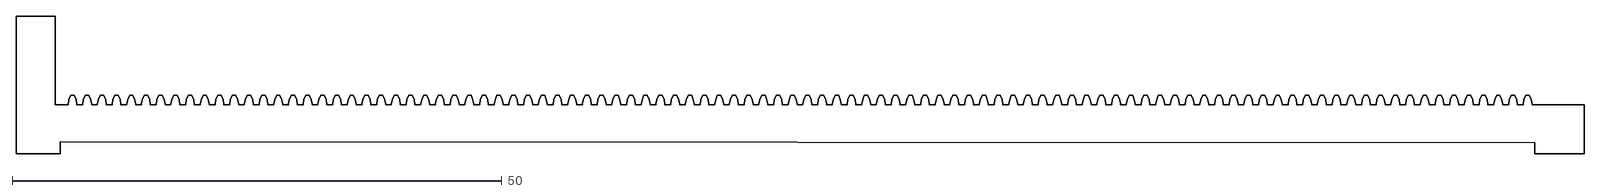
[picture p136: CAD file, 2018-05-07]
gearbox4stepper/stepper-rack-prototype1/gears/rack-pa20-cp1.5-l160.dxf
160.0 x 14.0
