sadr0b0t/metalrobot/manufacturing/партия10 - контакты 50 отсеков Аватек/contact-minus-нерж сталь-0.2мм-10шт.dxf

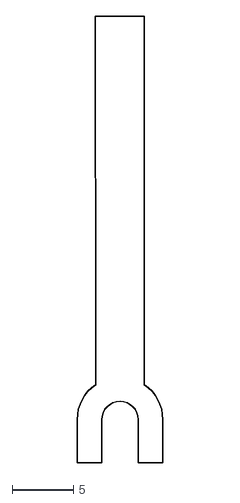
[picture p137: CAD file, 2015-11-19]
manufacturing/партия10 - контакты 50 отсеков Аватек/contact-minus-нерж сталь-0.2мм-10шт.dxf
7.00 x 36.5
