sadr0b0t/metalrobot/manufacturing/партия10.2 - отсек/battery-aa-holder-6-mod2-v4.stl

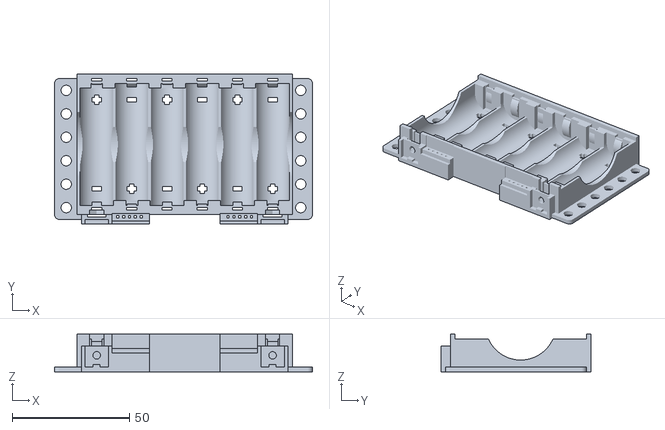
[picture p138: CAD file, 2015-11-17]
manufacturing/партия10.2 - отсек/battery-aa-holder-6-mod2-v4.stl
110.0 x 64.0 x 16.0
