sadr0b0t/metalrobot/manufacturing/партия3 - лазер пластик - 7 сентября 2014/все детали.dxf

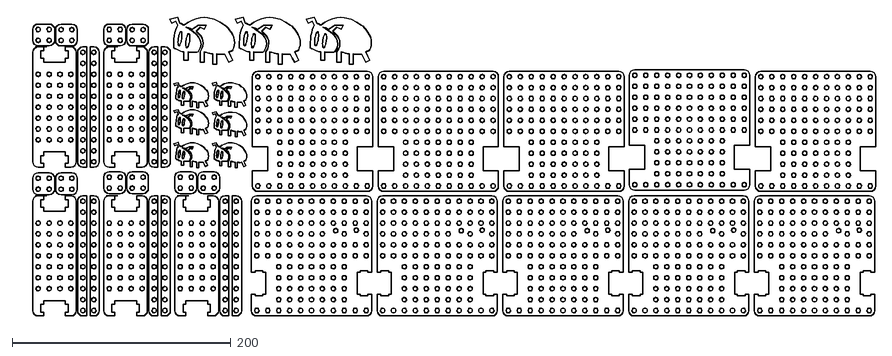
[picture p139: CAD file, 2014-10-01]
manufacturing/партия3 - лазер пластик - 7 сентября 2014/все детали.dxf
786.0 x 274.3
