sadr0b0t/metalrobot/manufacturing/партия5 - контакты для отсека/plate17-нерж сталь-0.5мм-20шт.dxf

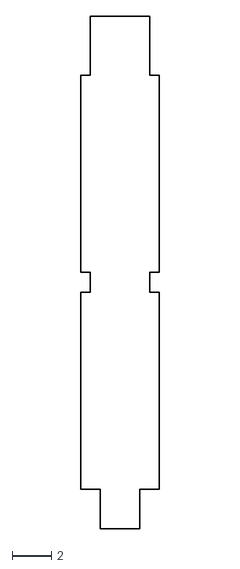
[picture p140: CAD file, 2015-05-29]
manufacturing/партия5 - контакты для отсека/plate17-нерж сталь-0.5мм-20шт.dxf
4.00 x 26.0
