sadr0b0t/metalrobot/manufacturing/партия8 - отсек и моторчик/motor2-collector_contact2-нерж сталь-0.2мм-10шт.dxf

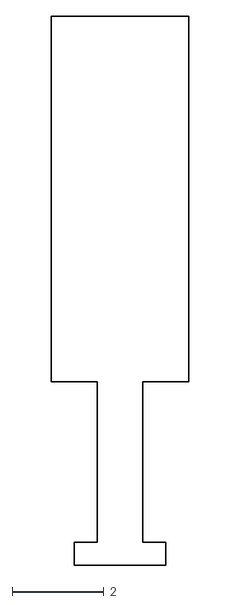
[picture p141: CAD file, 2015-08-16]
manufacturing/партия8 - отсек и моторчик/motor2-collector_contact2-нерж сталь-0.2мм-10шт.dxf
3.00 x 12.0
