sadr0b0t/metalrobot/manufacturing/партия9.1 - отсек/battery-aa-holder-6-mod2-v3.stl

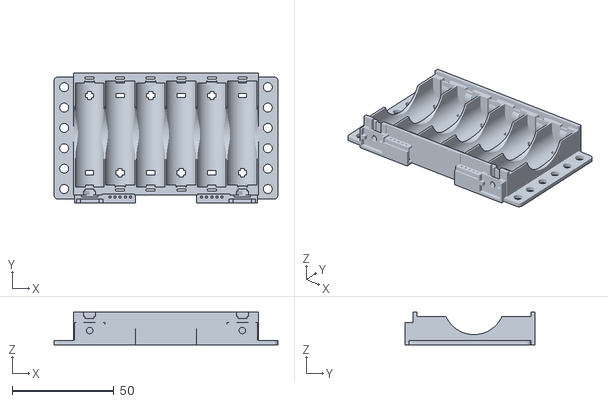
[picture p143: CAD file, 2015-11-17]
manufacturing/партия9.1 - отсек/battery-aa-holder-6-mod2-v3.stl
110.0 x 63.9 x 16.0
