sadr0b0t/metalrobot/motor/motor-draft1/export/motorbox.dxf

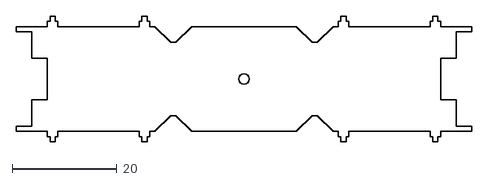
[picture p144: CAD file, 2015-07-11]
motor/motor-draft1/export/motorbox.dxf
87.0 x 24.0
