sadr0b0t/metalrobot/motor/motor-prototype1/export/motor2-collector.stl

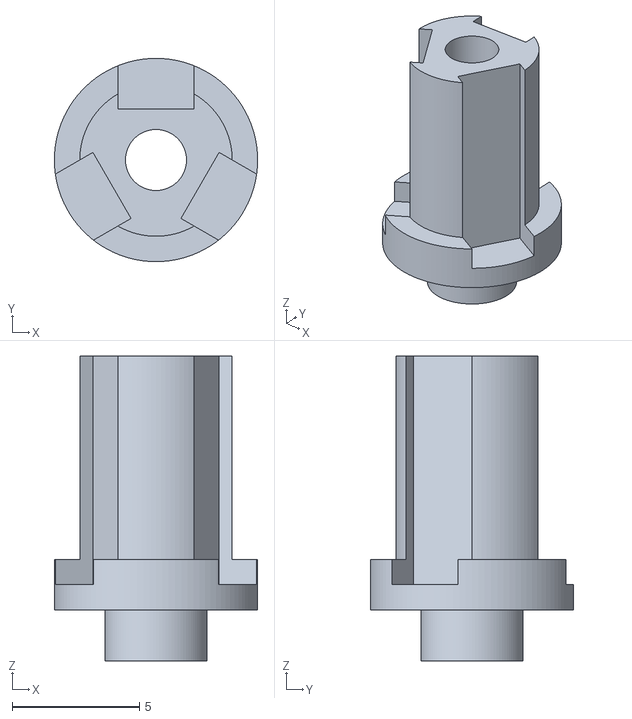
[picture p145: CAD file, 2015-08-16]
motor/motor-prototype1/export/motor2-collector.stl
8.00 x 8.00 x 12.0
