sadr0b0t/metalrobot/parts-3d/export/angle_1x2.stl

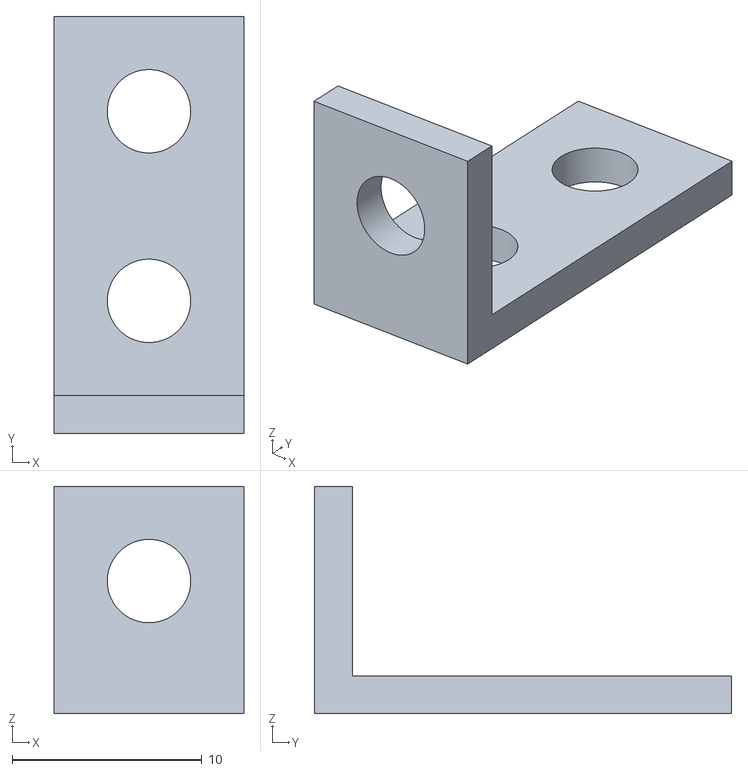
[picture p146: CAD file, 2015-08-16]
parts-3d/export/angle_1x2.stl
10.0 x 22.0 x 12.0
