sadr0b0t/metalrobot/parts/export/Araks-1/dxf-5 комплектов/servo_rib-1mm-оцинк_сталь_60шт.dxf

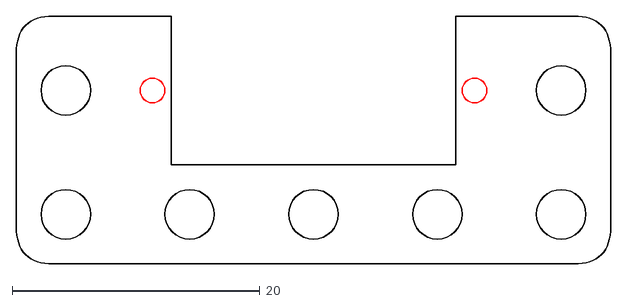
[picture p147: CAD file, 2014-03-04]
parts/export/Araks-1/dxf-5 комплектов/servo_rib-1mm-оцинк_сталь_60шт.dxf
48.0 x 20.0
