sadr0b0t/metalrobot/parts/export/Araks-1/dxf/chipKIT_Uno32_vert-1mm-оцинк_сталь_10шт.dxf

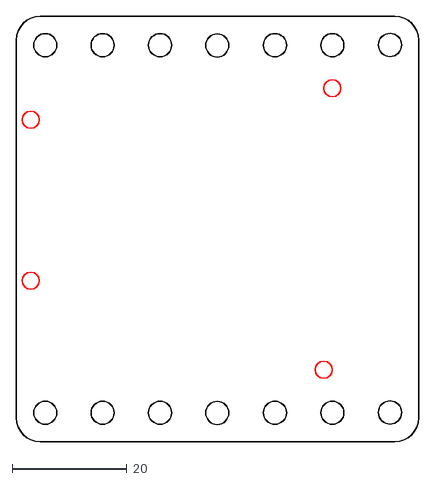
[picture p148: CAD file, 2014-02-14]
parts/export/Araks-1/dxf/chipKIT_Uno32_vert-1mm-оцинк_сталь_10шт.dxf
70.0 x 74.0
