sadr0b0t/metalrobot/parts/export/stl/wheel_motor2.stl

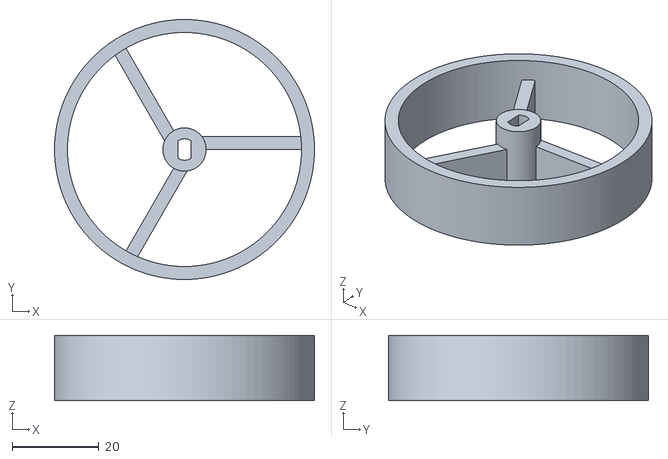
[picture p149: CAD file, 2013-12-26]
parts/export/stl/wheel_motor2.stl
60.0 x 60.0 x 15.0
