sadr0b0t/metalrobot/Robot Car/колеса/export/wheel_generic_right.stl

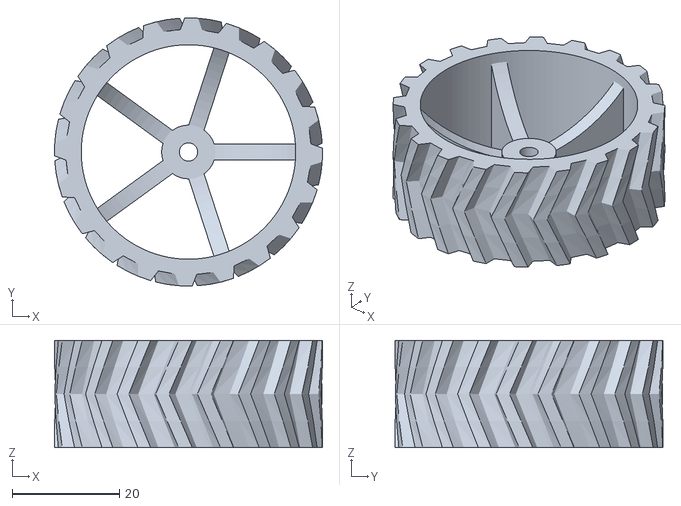
[picture p150: CAD file, 2016-01-20]
Robot Car/колеса/export/wheel_generic_right.stl
50.0 x 50.0 x 20.0
