sadr0b0t/metalrobot/Robot Car/корпус/parts-3d/корпус-43d.dxf

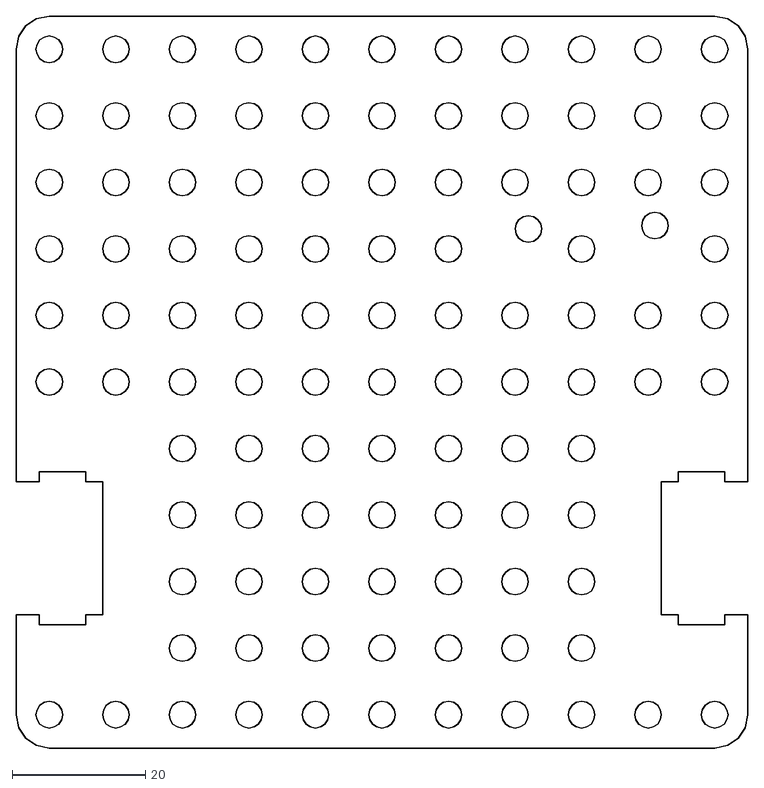
[picture p151: CAD file, 2016-05-25]
Robot Car/корпус/parts-3d/корпус-43d.dxf
110.0 x 110.0
