sadr0b0t/metalrobot/Robot Car/покрышки/покрышка-внешн.dxf

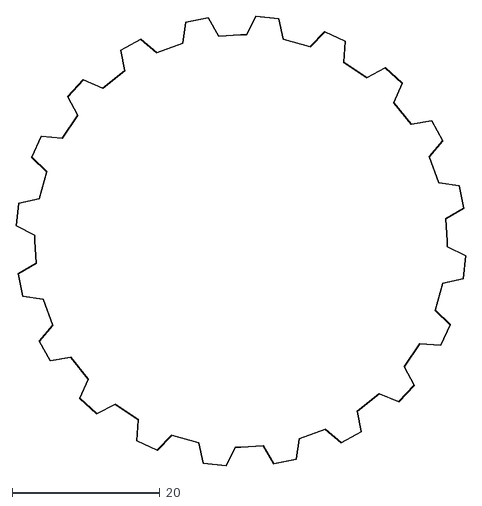
[picture p152: CAD file, 2015-03-31]
Robot Car/покрышки/покрышка-внешн.dxf
60.9 x 60.9
