sadr0b0t/metalrobot/Robot Car/сборка/крепление-оси.dxf

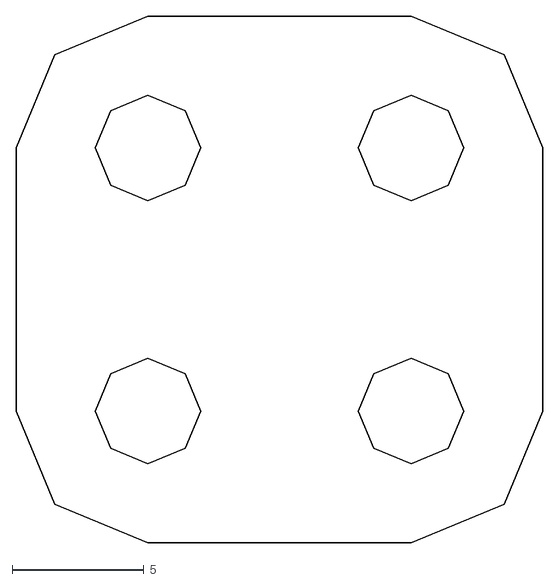
[picture p153: CAD file, 2014-08-31]
Robot Car/сборка/крепление-оси.dxf
20.0 x 20.0
