sadr0b0t/metalrobot/robotcar-model2/корпус2/крепление-ось-43d.dxf

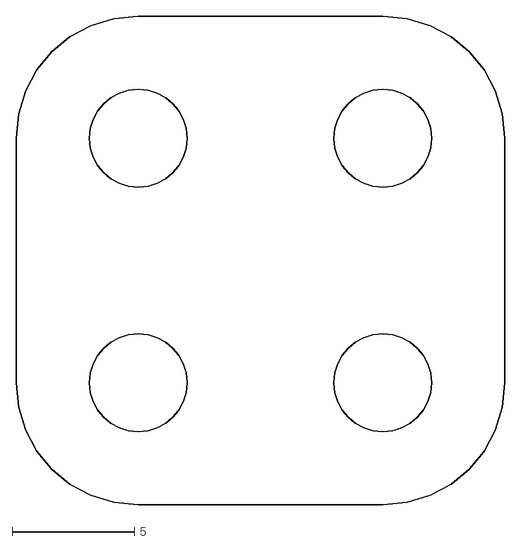
[picture p154: CAD file, 2016-02-24]
robotcar-model2/корпус2/крепление-ось-43d.dxf
20.0 x 20.0
