sadr0b0t/metalrobot/robotcar2/корпус/rover-draft1-openscad/export/rover-draft1-openscad.stl

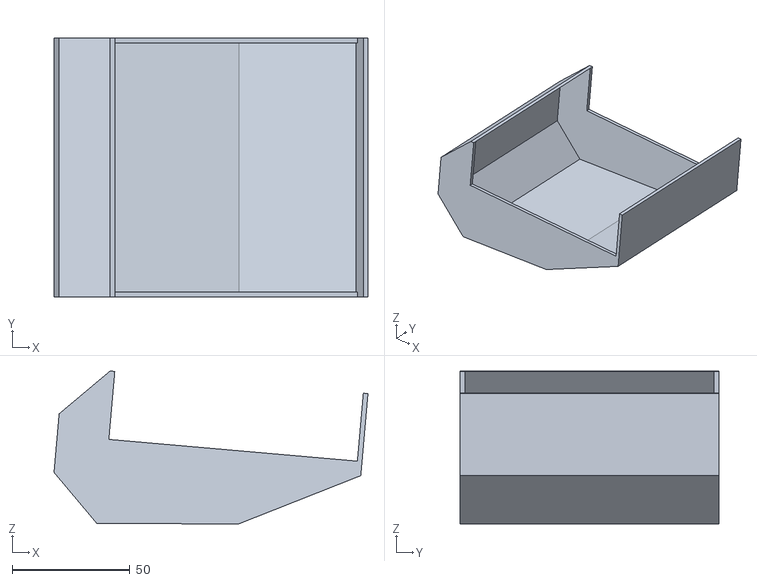
[picture p156: CAD file, 2015-09-16]
robotcar2/корпус/rover-draft1-openscad/export/rover-draft1-openscad.stl
133.4 x 110.0 x 65.0
