sadr0b0t/metalrobot/robotcar2/корпус/rover-draft2-blender/export/rover-draft2-blender.stl

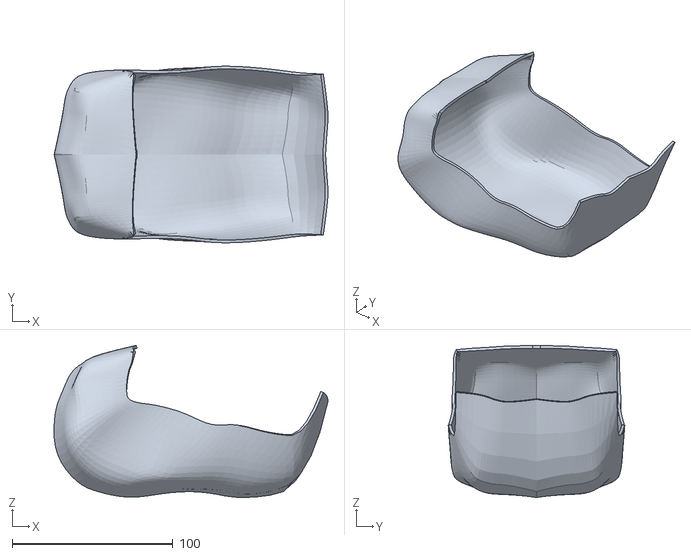
[picture p157: CAD file, 2015-09-16]
robotcar2/корпус/rover-draft2-blender/export/rover-draft2-blender.stl
170.7 x 110.0 x 94.7
