sadr0b0t/metalrobot/spider/export/2legs_for_printing.stl

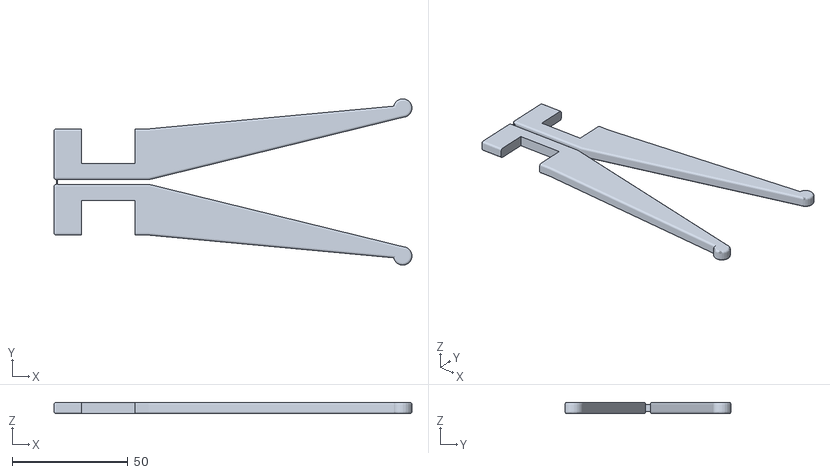
[picture p158: CAD file, 2016-01-19]
spider/export/2legs_for_printing.stl
155.0 x 72.0 x 4.98
