sadr0b0t/metalrobot/spring-bender/export/spring-bender-top.stl

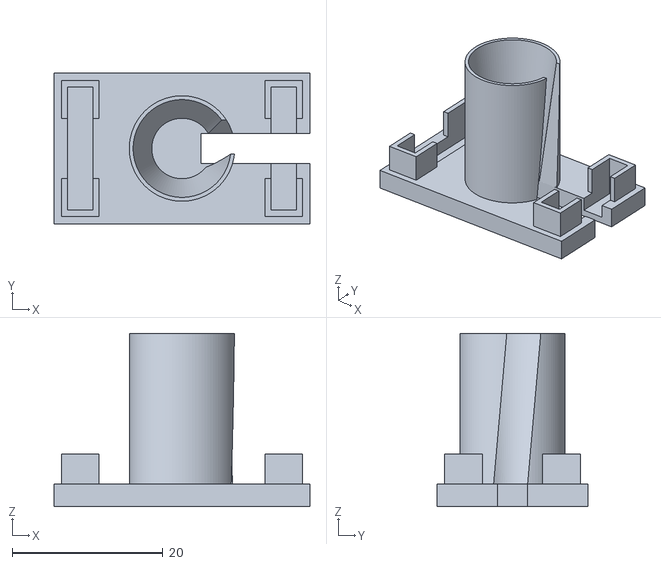
[picture p159: CAD file, 2016-01-10]
spring-bender/export/spring-bender-top.stl
34.0 x 20.0 x 23.0
