sadr0b0t/metalrobot/util/export/wrench-m3-m4.dxf

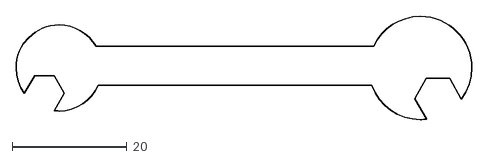
[picture p160: CAD file, 2015-06-01]
util/export/wrench-m3-m4.dxf
79.5 x 18.0
