sadr0b0t/metalrobot/battery-holder/contacts-draft4/export/contact-plus.dxf

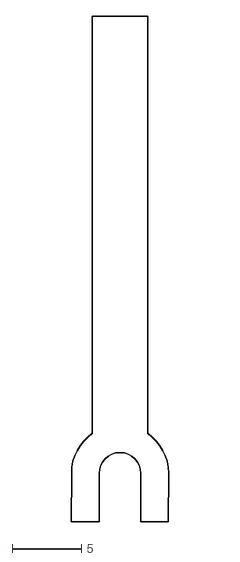
[picture p162: CAD file, 2015-11-19]
battery-holder/contacts-draft4/export/contact-plus.dxf
7.00 x 36.5
