sadr0b0t/metalrobot/battery-holder/wire-plate1-43d.dxf

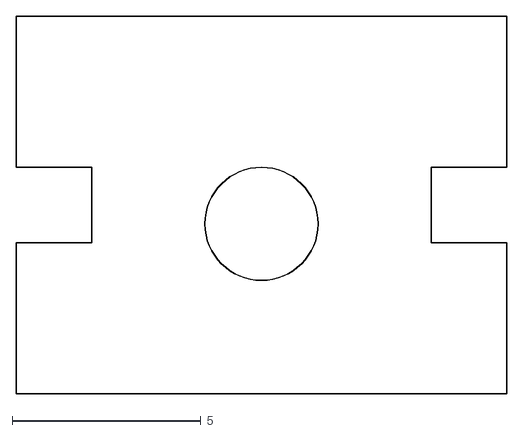
[picture p163: CAD file, 2015-07-07]
battery-holder/wire-plate1-43d.dxf
13.0 x 10.0
