sadr0b0t/metalrobot/brbrd-bender/brbrd-bender-plug-43d.dxf

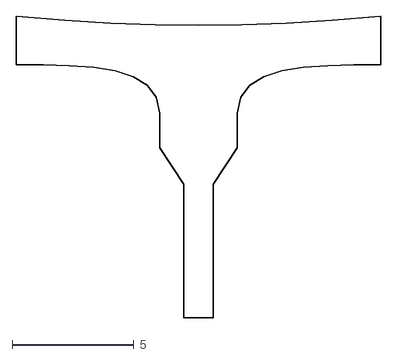
[picture p164: CAD file, 2015-12-28]
brbrd-bender/brbrd-bender-plug-43d.dxf
15.0 x 12.4
