sadr0b0t/metalrobot/brbrd-bender/export/brbrd-bender-socket-pe0.3.stl

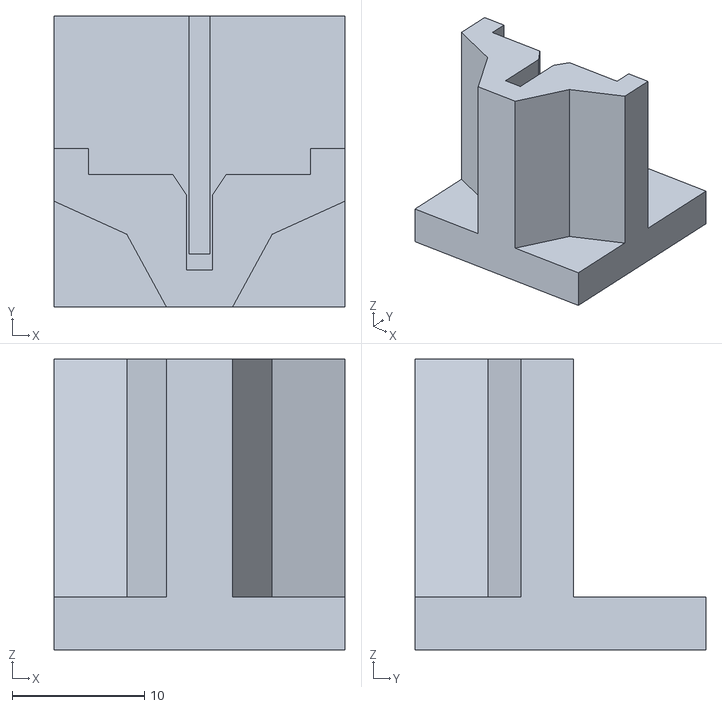
[picture p165: CAD file, 2016-02-06]
brbrd-bender/export/brbrd-bender-socket-pe0.3.stl
22.0 x 22.0 x 22.0
