sadr0b0t/metalrobot/components-3d/wires/export/plug_usb-a.stl

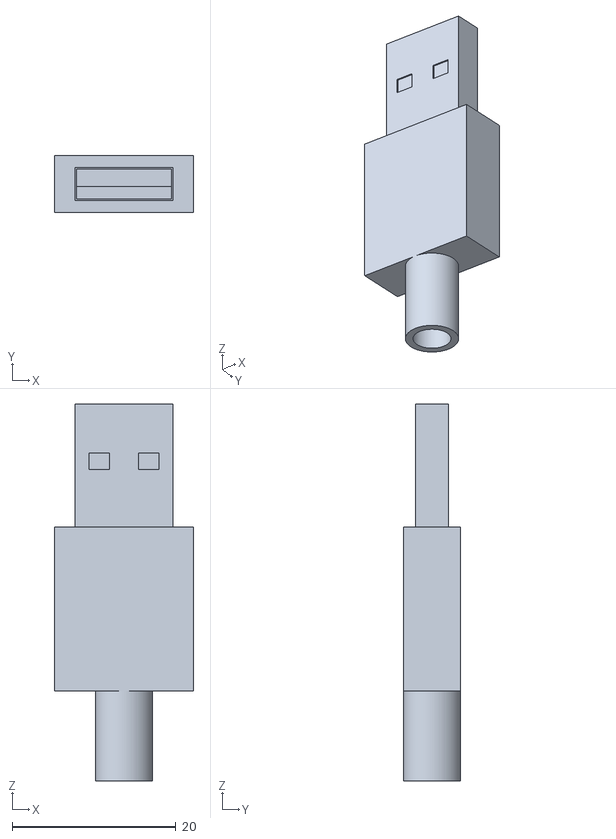
[picture p166: CAD file, 2016-05-25]
components-3d/wires/export/plug_usb-a.stl
17.0 x 7.00 x 46.0
