sadr0b0t/metalrobot/components-3d/wires/wire3-core1-d1mm-43d.dxf

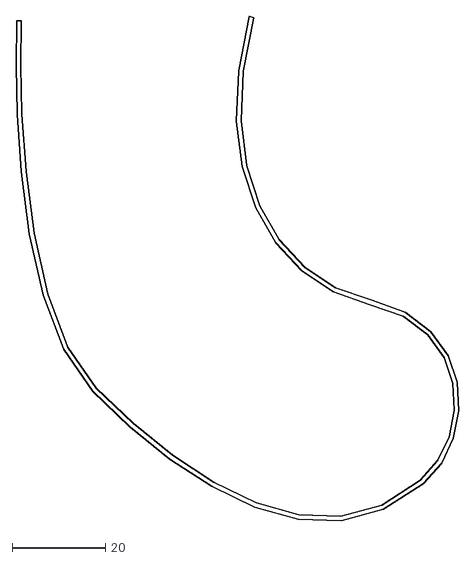
[picture p167: CAD file, 2016-05-25]
components-3d/wires/wire3-core1-d1mm-43d.dxf
94.8 x 108.0
