sadr0b0t/metalrobot/doc/robotcar-model2-инструкция-компоненты/blender-render/stl-addons/tyre_box_half1.stl

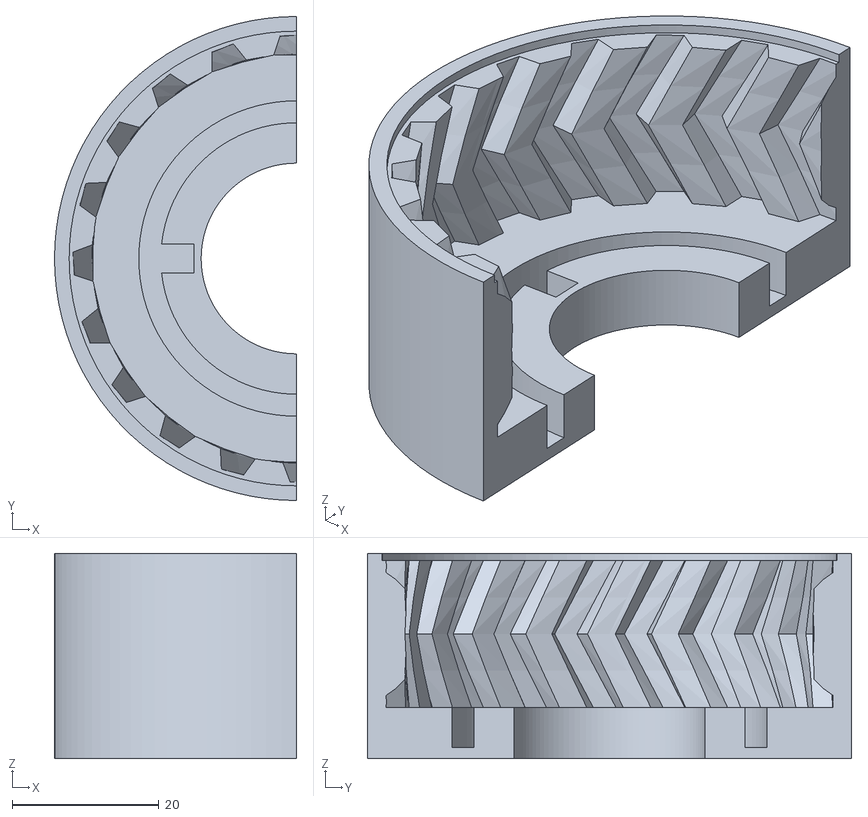
[picture p168: CAD file, 2016-05-22]
doc/robotcar-model2-инструкция-компоненты/blender-render/stl-addons/tyre_box_half1.stl
33.0 x 66.0 x 28.0
