sadr0b0t/metalrobot/doc/robotcar-model2-инструкция-корпус/blender-render/stl-components/ir_line_sensor.stl

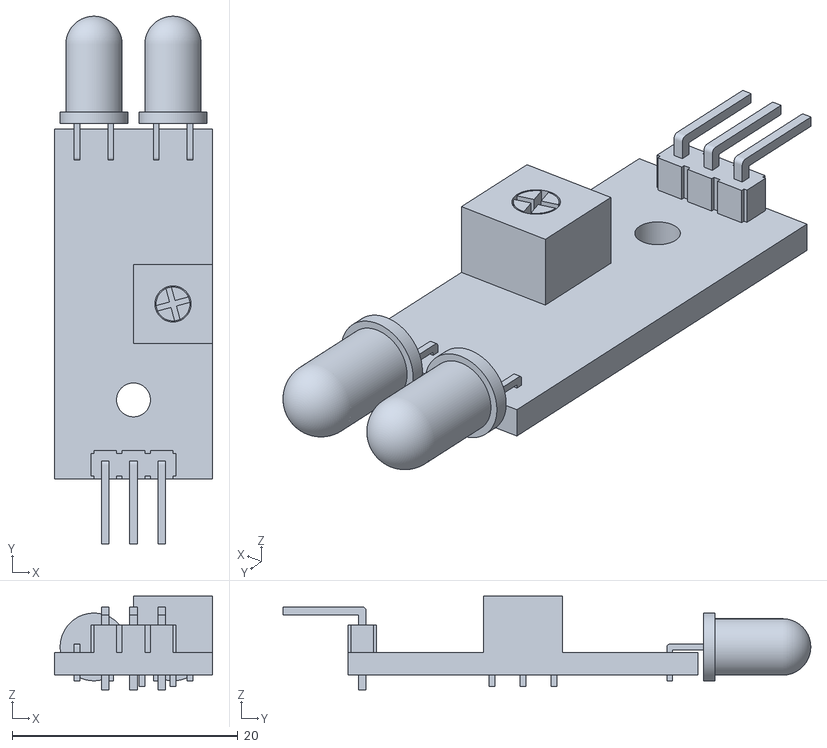
[picture p169: CAD file, 2016-06-06]
doc/robotcar-model2-инструкция-корпус/blender-render/stl-components/ir_line_sensor.stl
14.0 x 46.7 x 8.30
