sadr0b0t/metalrobot/gearbox/gearbox-prototype5/export/gearbox-half-wheels.stl

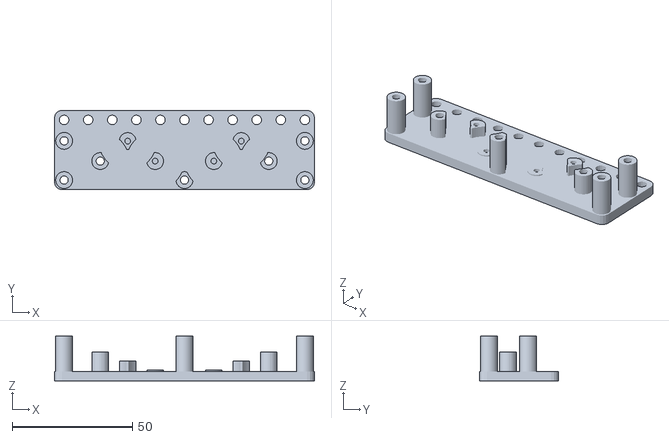
[picture p170: CAD file, 2015-09-13]
gearbox/gearbox-prototype5/export/gearbox-half-wheels.stl
108.0 x 33.0 x 18.6
