sadr0b0t/metalrobot/gearbox/gearbox-prototype5/gears/gear-pa20-cp1.5-t47.dxf

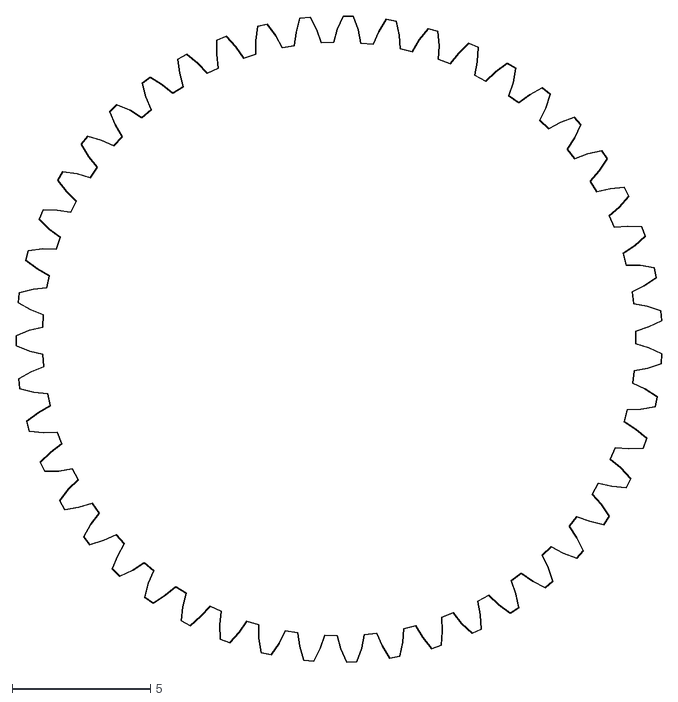
[picture p171: CAD file, 2015-08-13]
gearbox/gearbox-prototype5/gears/gear-pa20-cp1.5-t47.dxf
23.4 x 23.4
