sadr0b0t/metalrobot/gearbox/gears-3dprint-tests/export/gears-cp1.5-t43-d2.stl

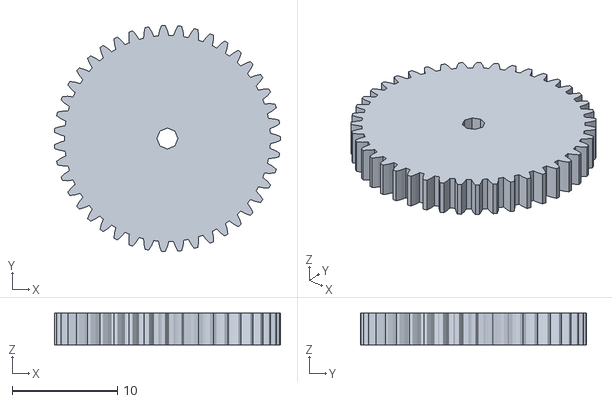
[picture p172: CAD file, 2015-07-16]
gearbox/gears-3dprint-tests/export/gears-cp1.5-t43-d2.stl
21.5 x 21.5 x 3.00
