sadr0b0t/metalrobot/gearbox/gears-3dprint-tests/gear-cp1.5-t9.dxf

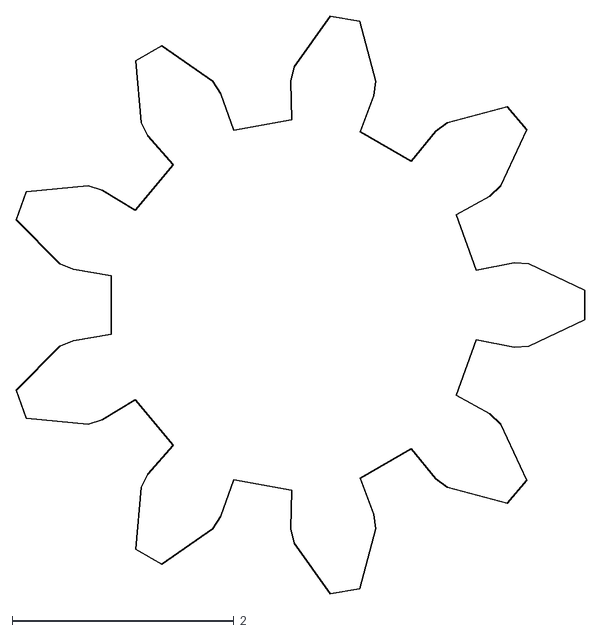
[picture p173: CAD file, 2015-07-16]
gearbox/gears-3dprint-tests/gear-cp1.5-t9.dxf
5.13 x 5.21
