sadr0b0t/metalrobot/gearbox4stepper/stepper-rack-prototype1/box/export-pe0.1/smg-rack-pe0.1.stl

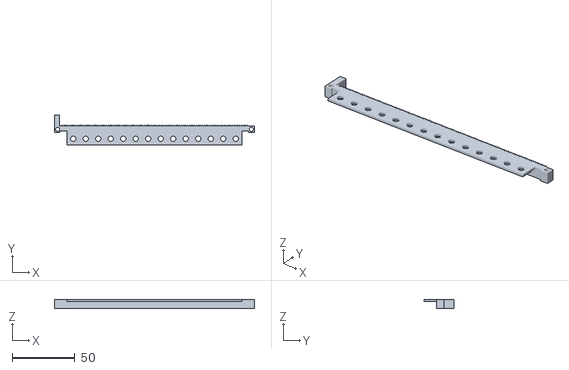
[picture p174: CAD file, 2018-05-07]
gearbox4stepper/stepper-rack-prototype1/box/export-pe0.1/smg-rack-pe0.1.stl
160.0 x 24.0 x 6.80
