sadr0b0t/metalrobot/gearbox4stepper/stepper-rack-prototype1/box/export-pe0.2/smg-rack-pe0.2.stl

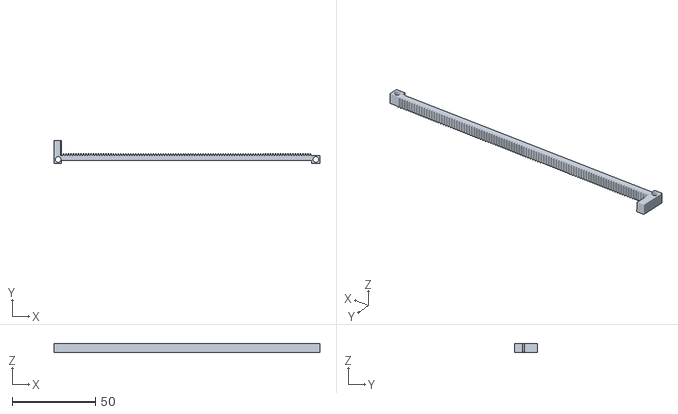
[picture p175: CAD file, 2018-05-07]
gearbox4stepper/stepper-rack-prototype1/box/export-pe0.2/smg-rack-pe0.2.stl
160.0 x 14.0 x 5.30
