sadr0b0t/metalrobot/gearbox4stepper/stepper-rack-prototype1/gears/gear-pa20-cp1.5-t36.dxf

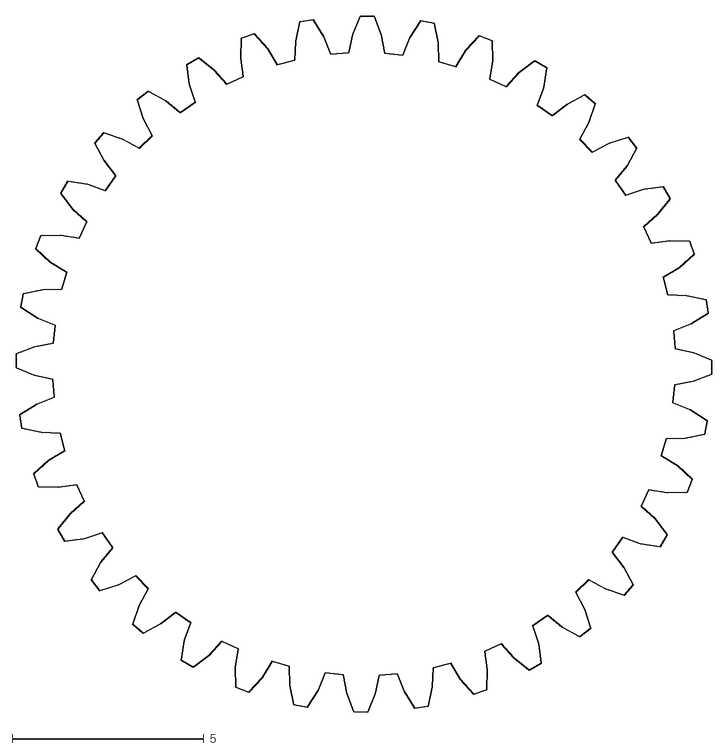
[picture p176: CAD file, 2018-05-07]
gearbox4stepper/stepper-rack-prototype1/gears/gear-pa20-cp1.5-t36.dxf
18.1 x 18.1
