sadr0b0t/metalrobot/manufacturing/партия10 - контакты 50 отсеков Аватек/brbrd-2contact-нерж сталь-0.2мм-100шт.dxf

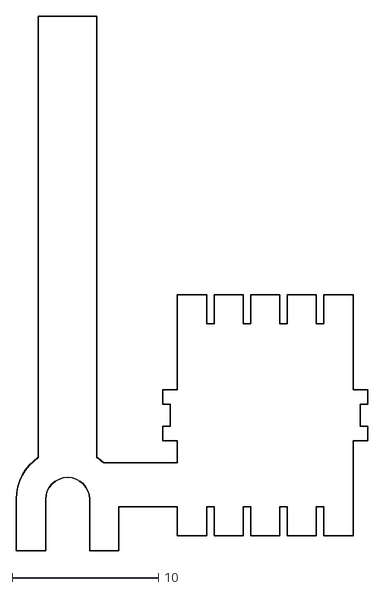
[picture p177: CAD file, 2015-11-19]
manufacturing/партия10 - контакты 50 отсеков Аватек/brbrd-2contact-нерж сталь-0.2мм-100шт.dxf
24.0 x 36.5
