sadr0b0t/metalrobot/manufacturing/партия5 - контакты для отсека/brbrd28-нерж сталь-0.5мм-5шт.dxf

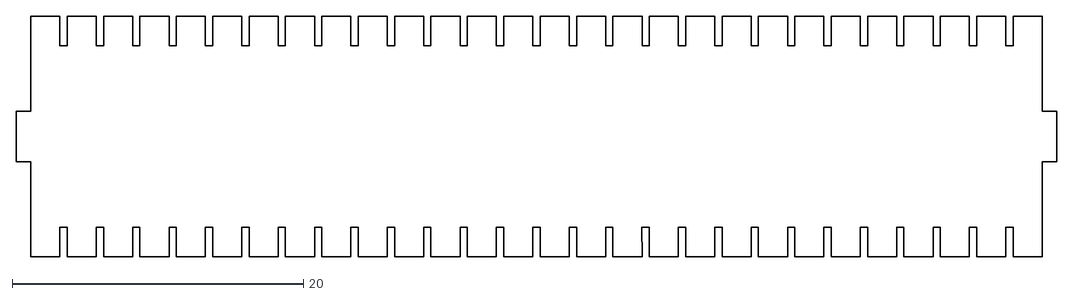
[picture p178: CAD file, 2015-05-29]
manufacturing/партия5 - контакты для отсека/brbrd28-нерж сталь-0.5мм-5шт.dxf
71.5 x 16.5
