sadr0b0t/metalrobot/manufacturing/партия9 - контакты 50 отсеков/contact-plus-нерж сталь-0.2мм-50шт.dxf

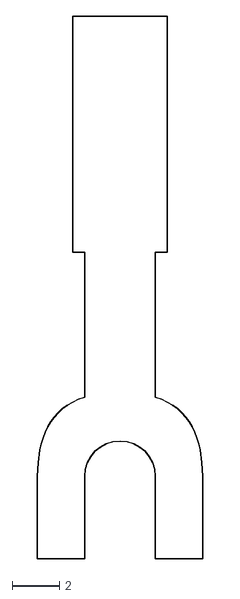
[picture p180: CAD file, 2015-09-19]
manufacturing/партия9 - контакты 50 отсеков/contact-plus-нерж сталь-0.2мм-50шт.dxf
7.00 x 23.0
