sadr0b0t/metalrobot/motor/motor-draft1/export/motorbox2.dxf

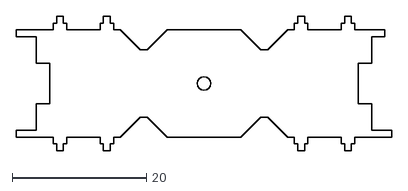
[picture p181: CAD file, 2015-07-11]
motor/motor-draft1/export/motorbox2.dxf
56.0 x 20.0
