sadr0b0t/metalrobot/motor/motor-prototype1/export/motor2-bottom_fix.stl

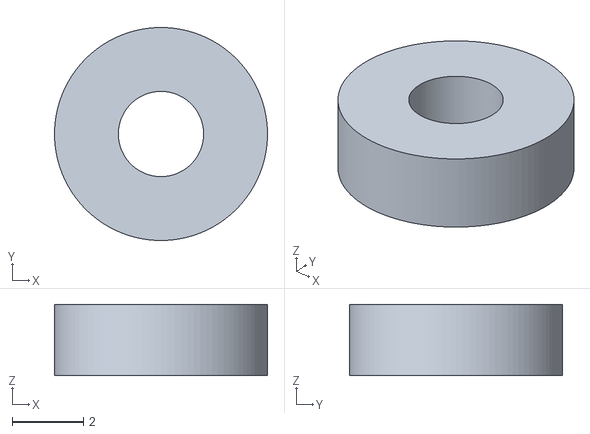
[picture p182: CAD file, 2015-08-16]
motor/motor-prototype1/export/motor2-bottom_fix.stl
6.00 x 6.00 x 2.00
