sadr0b0t/metalrobot/parts-3d/export/angle_1x3.stl

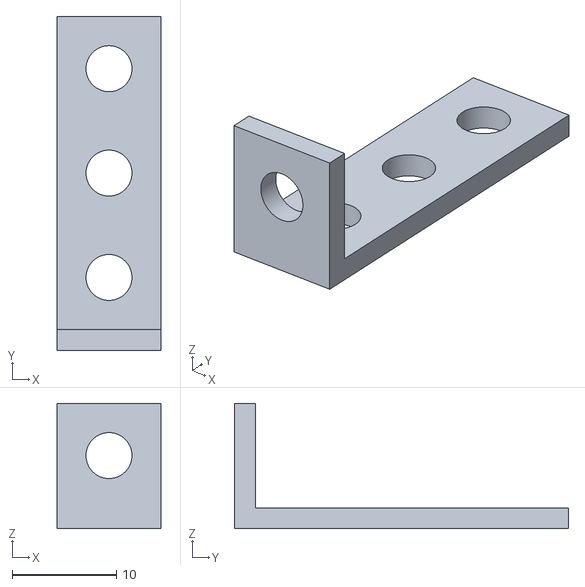
[picture p183: CAD file, 2015-08-16]
parts-3d/export/angle_1x3.stl
10.0 x 32.0 x 12.0
