sadr0b0t/metalrobot/parts/export/Araks-1/dxf-5 комплектов/servo_box-1mm-оцинк_сталь_60шт.dxf

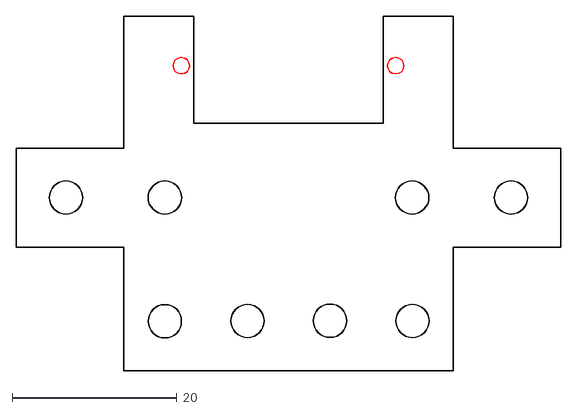
[picture p184: CAD file, 2014-03-04]
parts/export/Araks-1/dxf-5 комплектов/servo_box-1mm-оцинк_сталь_60шт.dxf
66.0 x 43.0
