sadr0b0t/metalrobot/parts/export/Araks-1/dxf/servo_ds329hv_mount-1mm-оцинк_сталь_10шт.dxf

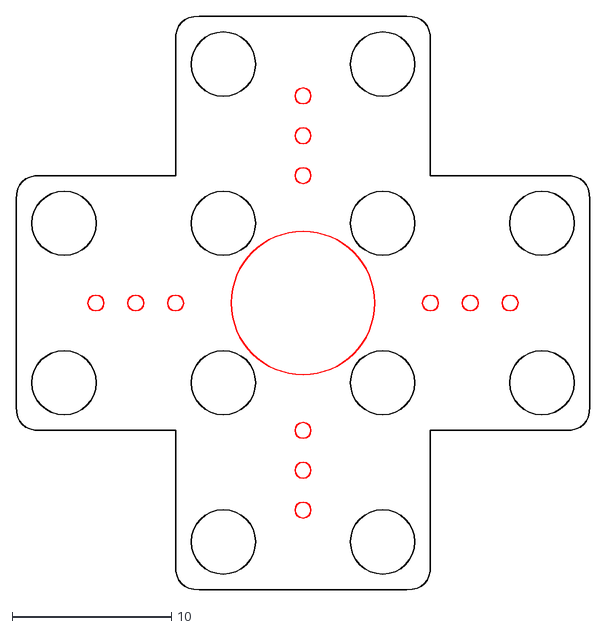
[picture p185: CAD file, 2014-02-14]
parts/export/Araks-1/dxf/servo_ds329hv_mount-1mm-оцинк_сталь_10шт.dxf
36.0 x 36.0
