sadr0b0t/metalrobot/parts/export/stl/wheel_generic.stl

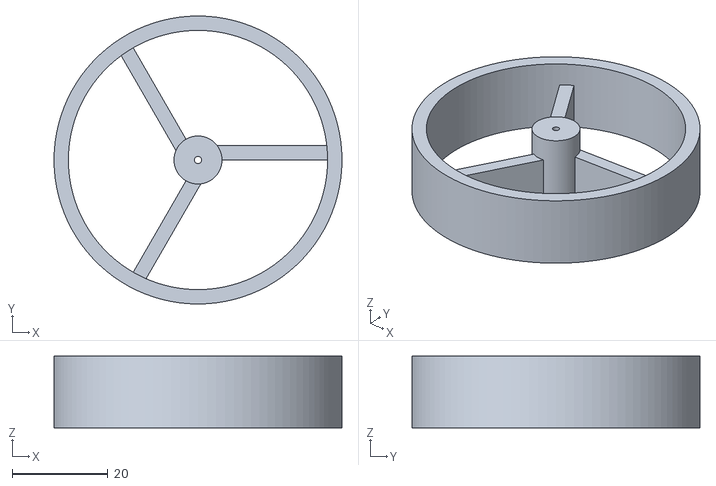
[picture p186: CAD file, 2013-12-26]
parts/export/stl/wheel_generic.stl
60.0 x 60.0 x 15.0
