sadr0b0t/metalrobot/Robot Car/корпус/export/все_детали.dxf

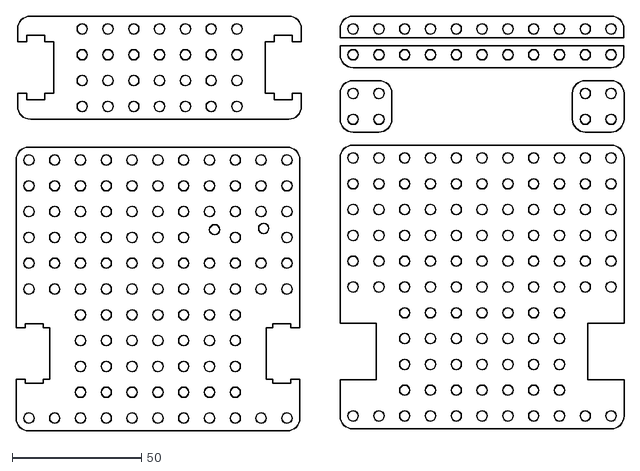
[picture p187: CAD file, 2014-09-07]
Robot Car/корпус/export/все_детали.dxf
235.6 x 160.8
