sadr0b0t/metalrobot/Robot Car/покрышки/покрышка-внутр.dxf

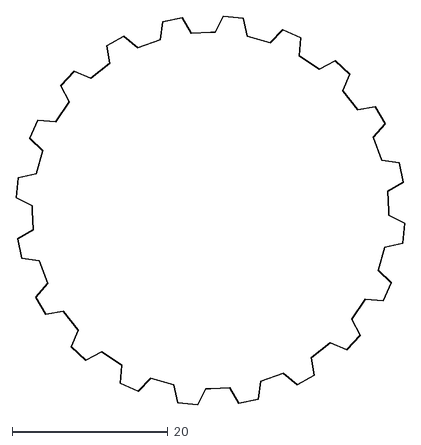
[picture p189: CAD file, 2014-11-20]
Robot Car/покрышки/покрышка-внутр.dxf
49.9 x 49.9
