sadr0b0t/metalrobot/Robot Car/сборка/корпус.dxf

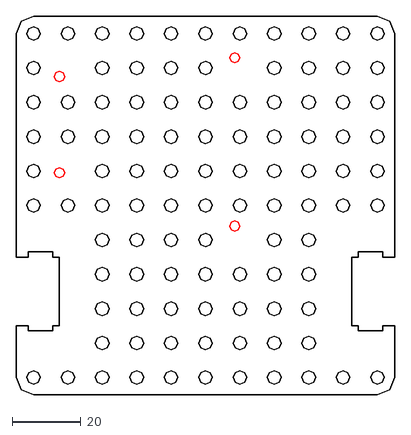
[picture p190: CAD file, 2014-08-31]
Robot Car/сборка/корпус.dxf
110.0 x 110.0
