sadr0b0t/metalrobot/robotcar-model2/корпус2/крепление-мотор-43d.dxf

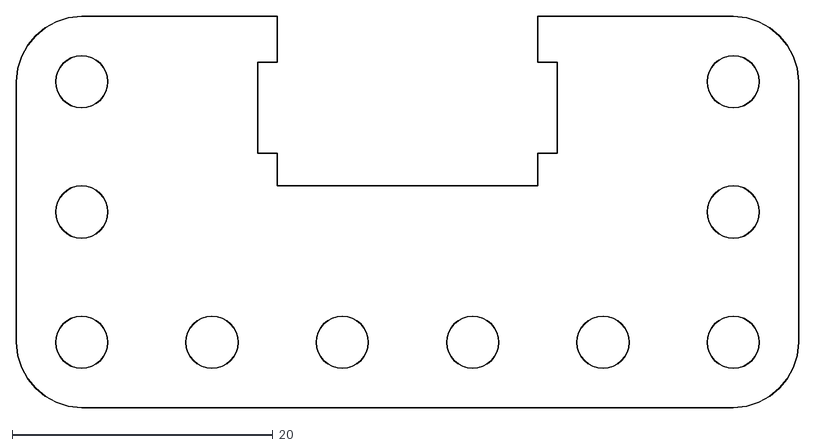
[picture p191: CAD file, 2016-02-24]
robotcar-model2/корпус2/крепление-мотор-43d.dxf
60.0 x 30.0
