sadr0b0t/metalrobot/robotcar2/корпус/chasis-43d/box-wheels-inside-43d.dxf

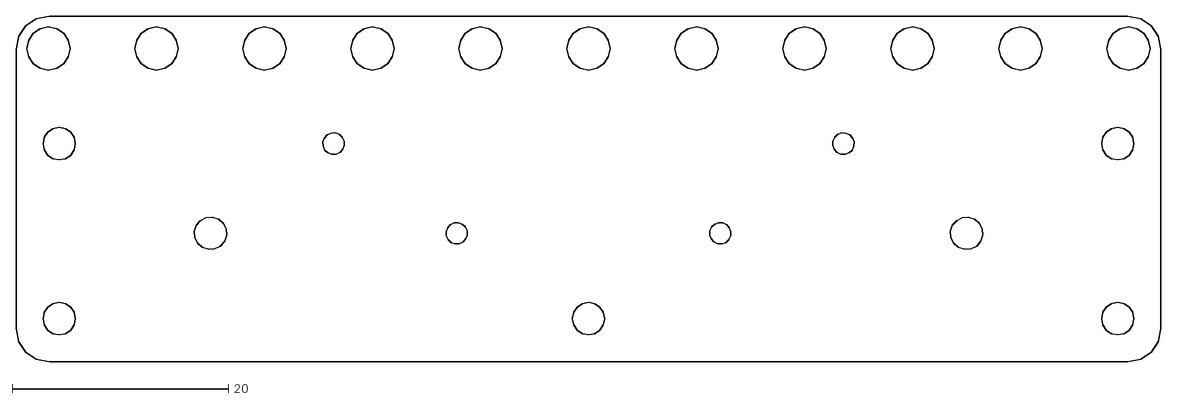
[picture p192: CAD file, 2015-08-13]
robotcar2/корпус/chasis-43d/box-wheels-inside-43d.dxf
106.0 x 32.0
