sadr0b0t/metalrobot/spider/export/4holders_for_printing.stl

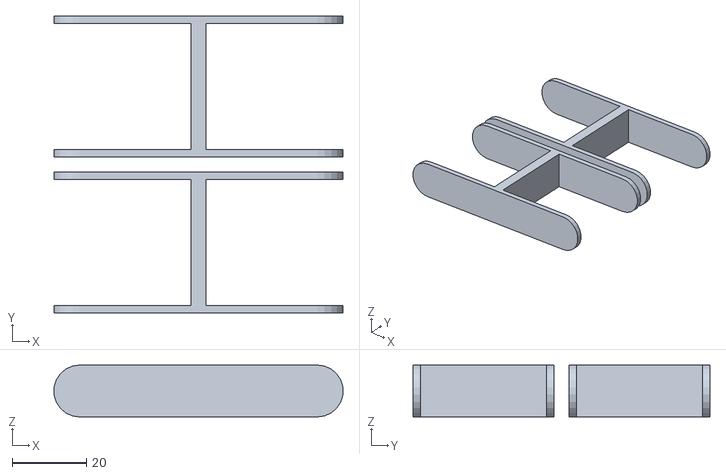
[picture p193: CAD file, 2016-01-19]
spider/export/4holders_for_printing.stl
77.9 x 80.0 x 14.0
