sadr0b0t/metalrobot/spring-bender/export/spring-bender-base.stl

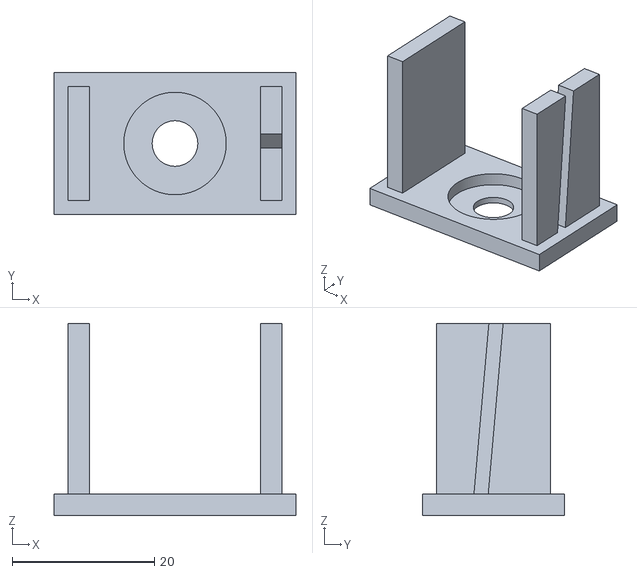
[picture p194: CAD file, 2016-01-10]
spring-bender/export/spring-bender-base.stl
34.0 x 20.0 x 27.0
