sadr0b0t/metalrobot/battery-holder/contacts-draft2/export/contact-plus-minus.dxf

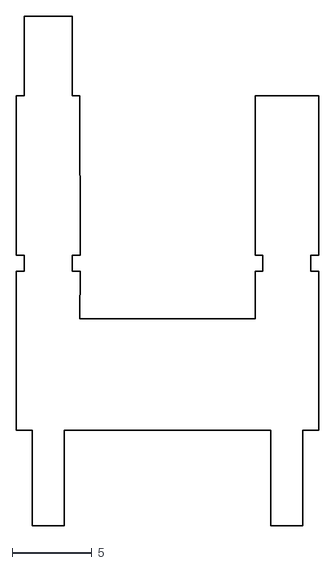
[picture p195: CAD file, 2015-07-11]
battery-holder/contacts-draft2/export/contact-plus-minus.dxf
19.0 x 32.0
