sadr0b0t/metalrobot/battery-holder/export/battery-aa-holder-4-mod2.stl

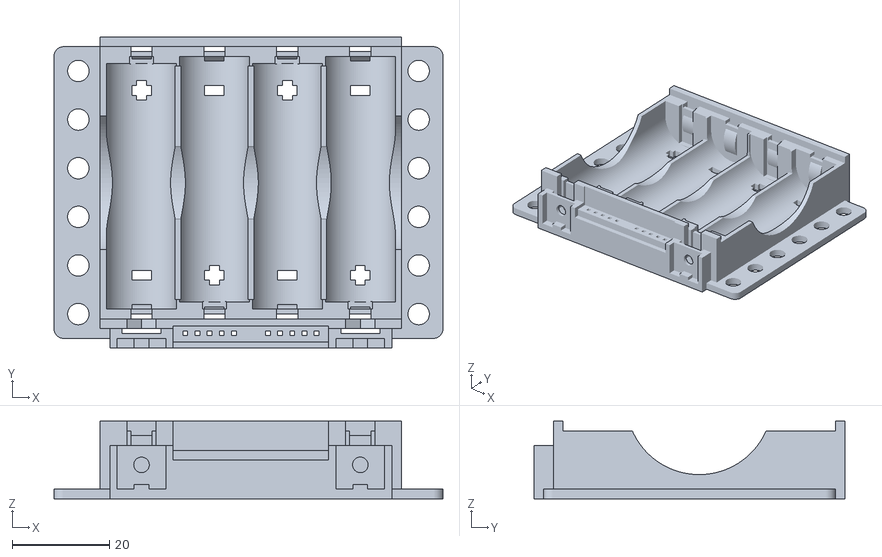
[picture p196: CAD file, 2015-12-16]
battery-holder/export/battery-aa-holder-4-mod2.stl
80.0 x 64.0 x 16.0
