sadr0b0t/metalrobot/components-3d/wires/export/head_pin.stl

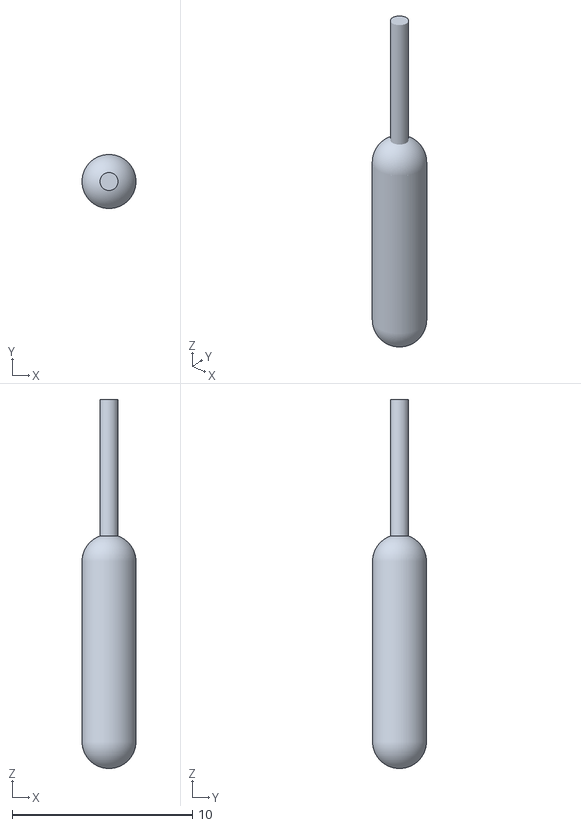
[picture p197: CAD file, 2016-05-25]
components-3d/wires/export/head_pin.stl
3.00 x 3.00 x 20.5
