sadr0b0t/metalrobot/components-3d/wires/wire1-1core-d1mm-43d.dxf

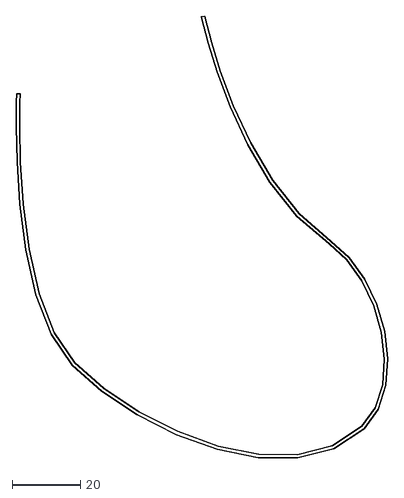
[picture p198: CAD file, 2016-05-25]
components-3d/wires/wire1-1core-d1mm-43d.dxf
108.7 x 129.2
