sadr0b0t/metalrobot/doc/robotcar-model2-инструкция-корпус/blender-render/stl-components/arduino_uno.stl

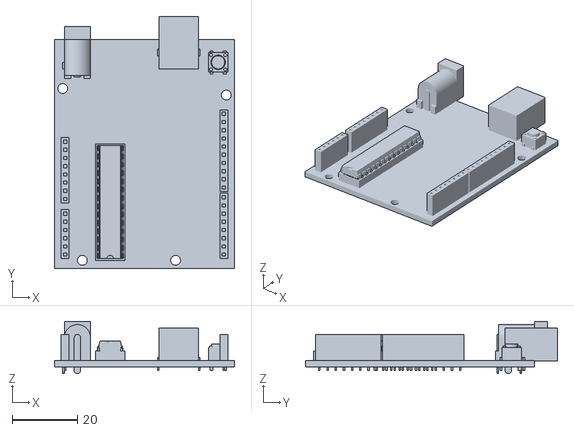
[picture p199: CAD file, 2016-06-02]
doc/robotcar-model2-инструкция-корпус/blender-render/stl-components/arduino_uno.stl
55.0 x 77.0 x 16.0
