sadr0b0t/metalrobot/doc/robotcar-model2-инструкция-корпус/blender-render/stl-parts/battery-aa-holder-4.stl

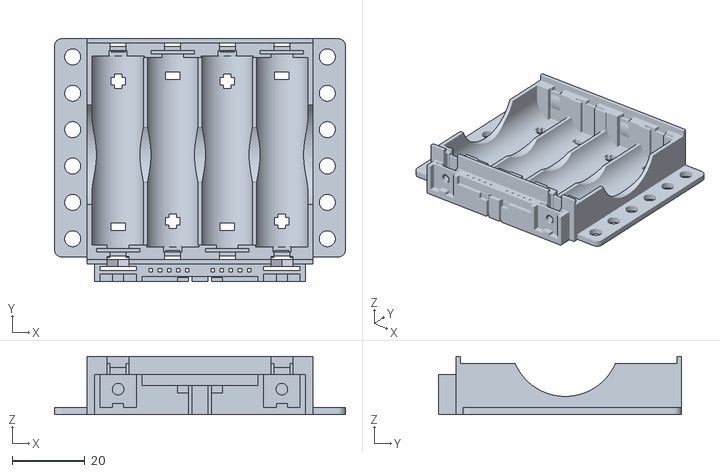
[picture p200: CAD file, 2016-05-22]
doc/robotcar-model2-инструкция-корпус/blender-render/stl-parts/battery-aa-holder-4.stl
80.0 x 66.7 x 16.0
