sadr0b0t/metalrobot/gearbox/gearbox-prototype5/export/wheel_shim-motor2.stl

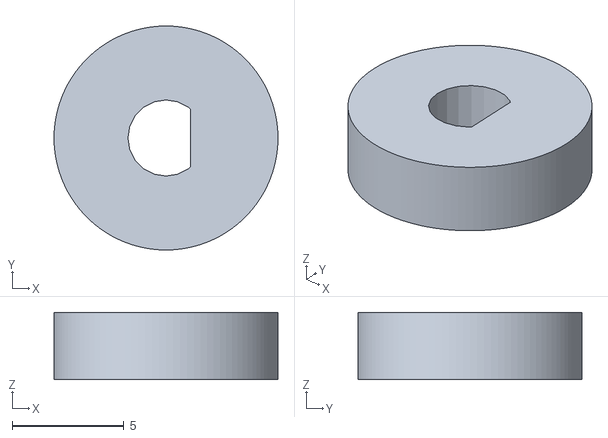
[picture p201: CAD file, 2015-08-15]
gearbox/gearbox-prototype5/export/wheel_shim-motor2.stl
10.0 x 10.0 x 3.00
