sadr0b0t/metalrobot/gearbox/gearbox-prototype5/gears/gear-pa20-cp1.5-t9.dxf

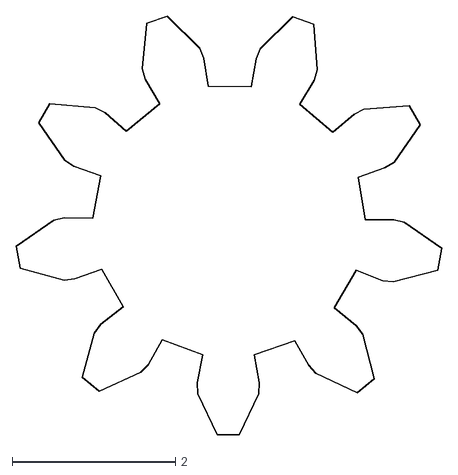
[picture p202: CAD file, 2015-07-16]
gearbox/gearbox-prototype5/gears/gear-pa20-cp1.5-t9.dxf
5.21 x 5.14
