sadr0b0t/metalrobot/gearbox/gears-3dprint-tests/export/gears-cp1.5-t27-motor2-e0.4.stl

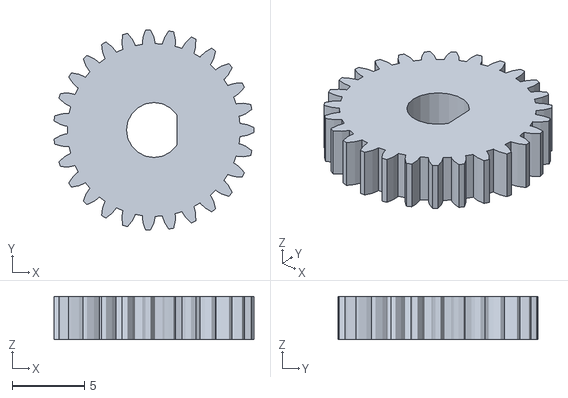
[picture p203: CAD file, 2015-07-16]
gearbox/gears-3dprint-tests/export/gears-cp1.5-t27-motor2-e0.4.stl
13.8 x 13.8 x 3.00
