sadr0b0t/metalrobot/gearbox/gears-3dprint-tests/gear-cp1.5-t63-support.dxf

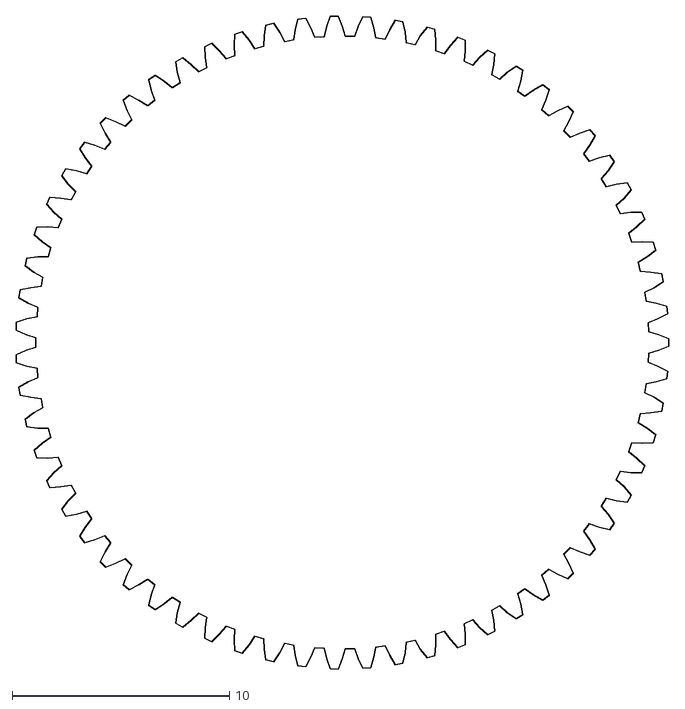
[picture p204: CAD file, 2015-07-16]
gearbox/gears-3dprint-tests/gear-cp1.5-t63-support.dxf
30.0 x 30.0
