sadr0b0t/metalrobot/gearbox4stepper/stepper-rack-prototype1/box/export-pe0.1/smg-motor_face-pe0.1.stl

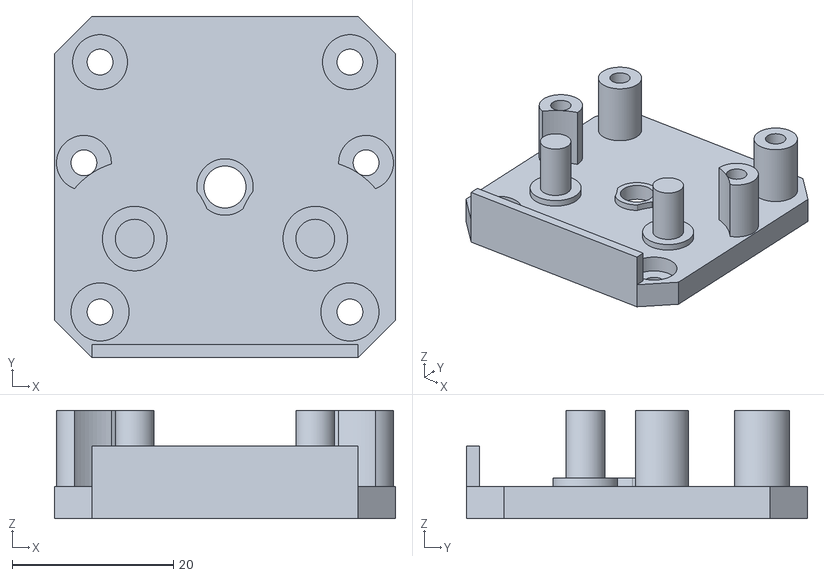
[picture p205: CAD file, 2018-05-07]
gearbox4stepper/stepper-rack-prototype1/box/export-pe0.1/smg-motor_face-pe0.1.stl
42.3 x 42.3 x 13.4
