sadr0b0t/metalrobot/gearbox4stepper/stepper-rack-prototype1/gears/gear-pa20-cp1.5-t18.dxf

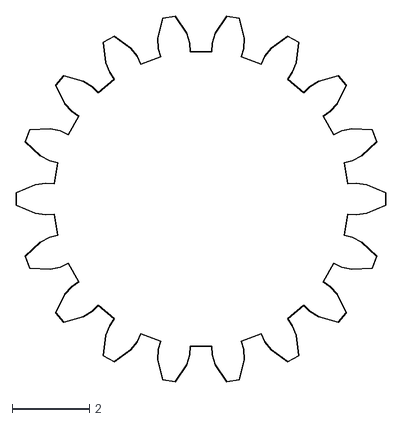
[picture p206: CAD file, 2018-05-07]
gearbox4stepper/stepper-rack-prototype1/gears/gear-pa20-cp1.5-t18.dxf
9.54 x 9.46
