sadr0b0t/metalrobot/manufacturing/партия10 - контакты 50 отсеков Аватек/contact-plus-minus-нерж сталь-0.2мм-250шт.dxf

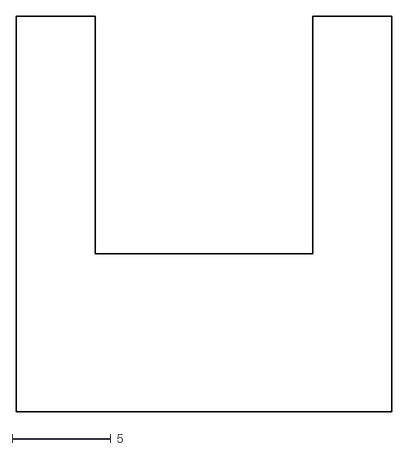
[picture p207: CAD file, 2015-11-19]
manufacturing/партия10 - контакты 50 отсеков Аватек/contact-plus-minus-нерж сталь-0.2мм-250шт.dxf
19.0 x 20.0
