sadr0b0t/metalrobot/manufacturing/партия5 - контакты для отсека/plate16-нерж сталь-0.5мм-5шт.dxf

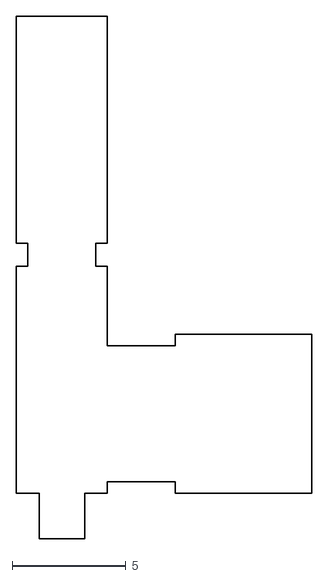
[picture p208: CAD file, 2015-05-29]
manufacturing/партия5 - контакты для отсека/plate16-нерж сталь-0.5мм-5шт.dxf
13.0 x 23.0
