sadr0b0t/metalrobot/motor/motor-draft1/export/motor1.dxf

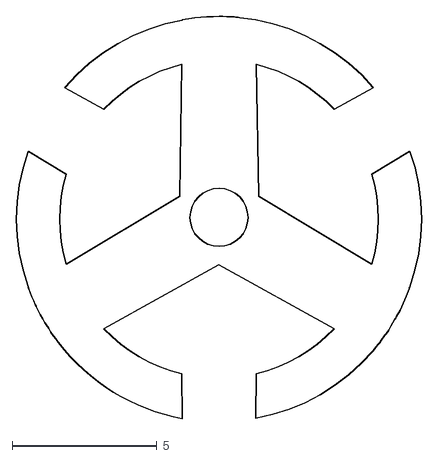
[picture p210: CAD file, 2015-05-29]
motor/motor-draft1/export/motor1.dxf
14.0 x 13.9
