sadr0b0t/metalrobot/motor/motor-prototype1/export/motor2-collector_fix.stl

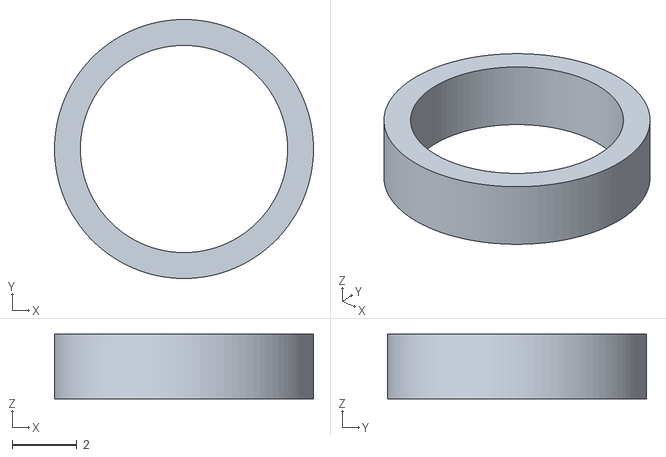
[picture p211: CAD file, 2015-08-16]
motor/motor-prototype1/export/motor2-collector_fix.stl
8.00 x 8.00 x 2.00
