sadr0b0t/metalrobot/parts-3d/export/angle_1x1.stl

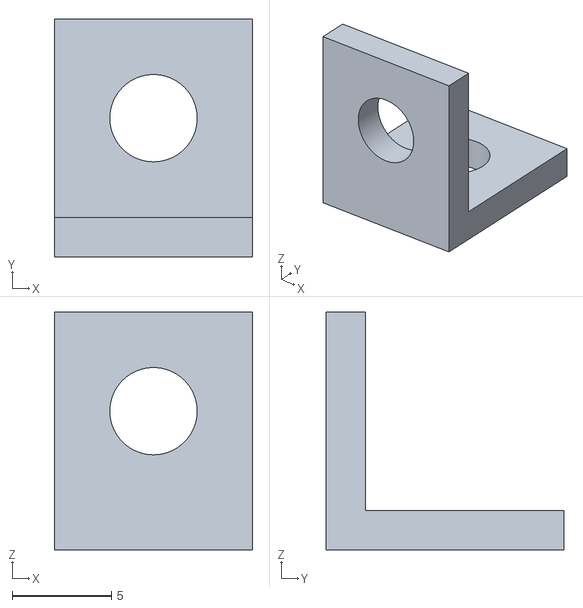
[picture p212: CAD file, 2015-08-16]
parts-3d/export/angle_1x1.stl
10.0 x 12.0 x 12.0
