sadr0b0t/metalrobot/Robot Car/покрышки/покрышка.dxf

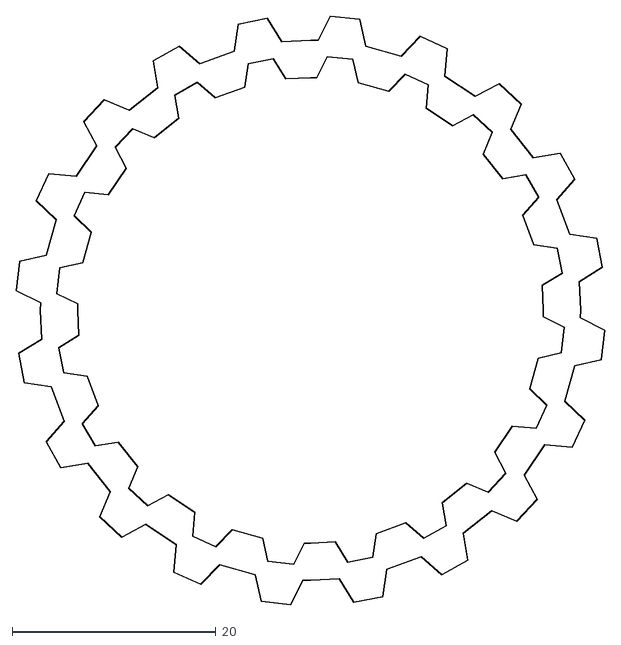
[picture p214: CAD file, 2014-08-31]
Robot Car/покрышки/покрышка.dxf
57.9 x 57.9
