sadr0b0t/metalrobot/Robot Car/сборка/рама-моторы.dxf

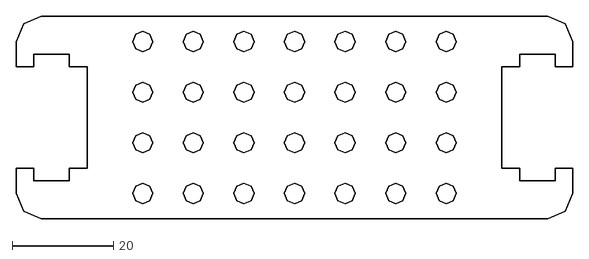
[picture p215: CAD file, 2014-08-31]
Robot Car/сборка/рама-моторы.dxf
110.0 x 40.0
