sadr0b0t/metalrobot/robotcar-model2/корпус2/корпус-43d.dxf

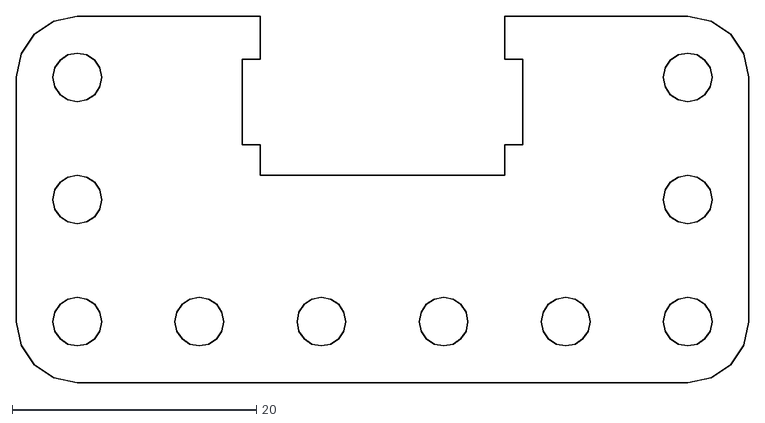
[picture p216: CAD file, 2016-02-22]
robotcar-model2/корпус2/корпус-43d.dxf
60.0 x 30.0
