sadr0b0t/metalrobot/spider/export/4holders_1_for_printing.stl

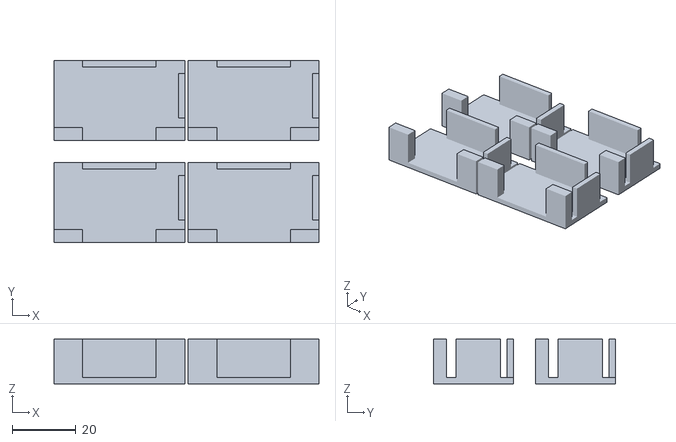
[picture p218: CAD file, 2016-01-19]
spider/export/4holders_1_for_printing.stl
83.0 x 57.0 x 14.0
