sadr0b0t/metalrobot/spring-bender/export/spring-helix_key.stl

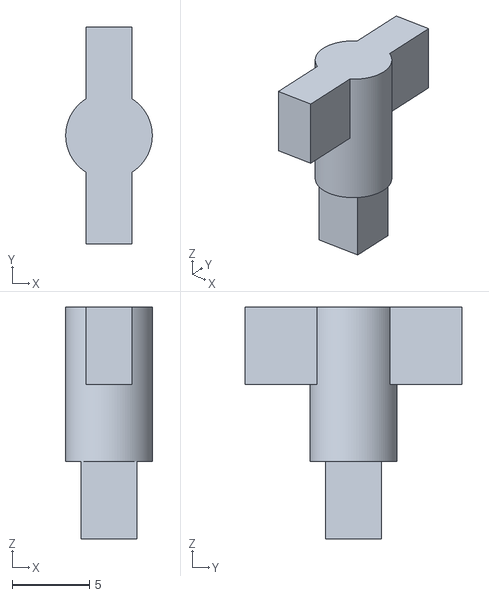
[picture p219: CAD file, 2016-01-10]
spring-bender/export/spring-helix_key.stl
5.60 x 14.0 x 15.0
