sadr0b0t/metalrobot/battery-holder/contacts-draft2/export/2brbrd4.dxf

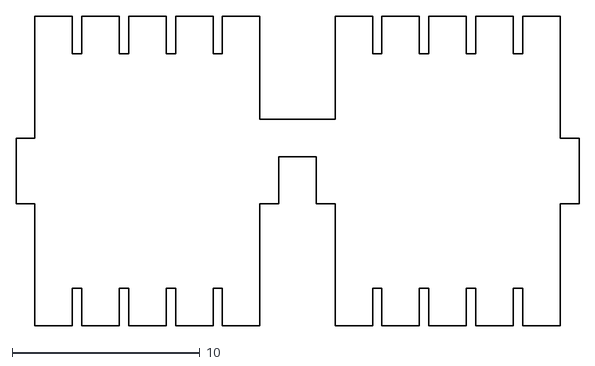
[picture p220: CAD file, 2015-07-11]
battery-holder/contacts-draft2/export/2brbrd4.dxf
30.0 x 16.5
