sadr0b0t/metalrobot/battery-holder/export/holder-aa-2.stl

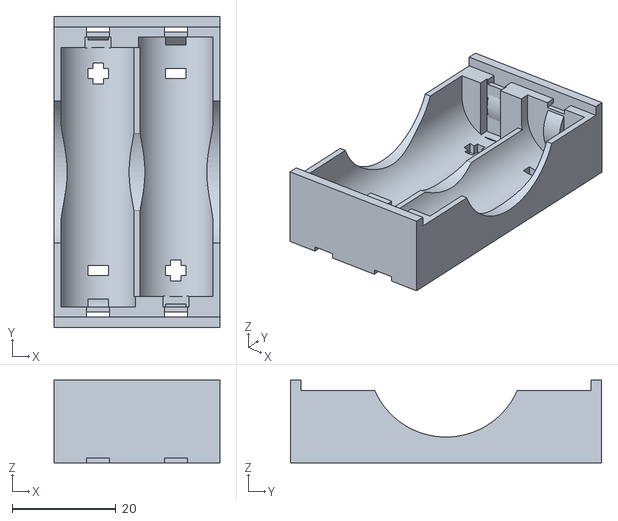
[picture p221: CAD file, 2015-12-16]
battery-holder/export/holder-aa-2.stl
32.0 x 60.0 x 16.0
