sadr0b0t/metalrobot/components-3d/wires/export/power_plug_jack.stl

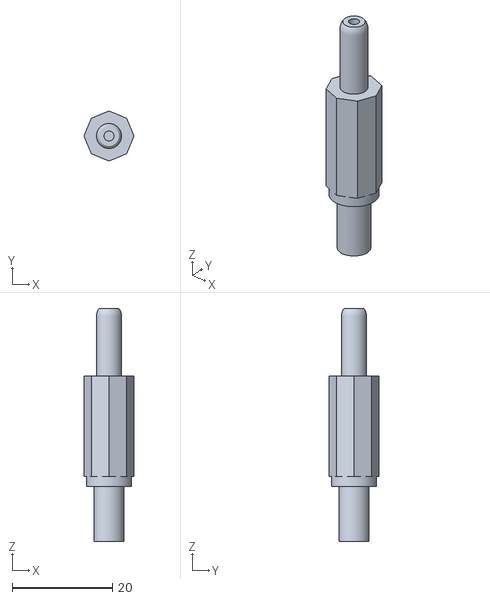
[picture p222: CAD file, 2016-05-25]
components-3d/wires/export/power_plug_jack.stl
10.0 x 10.0 x 46.5
