sadr0b0t/metalrobot/components-3d/wires/wire2-core2-d2mm-43d.dxf

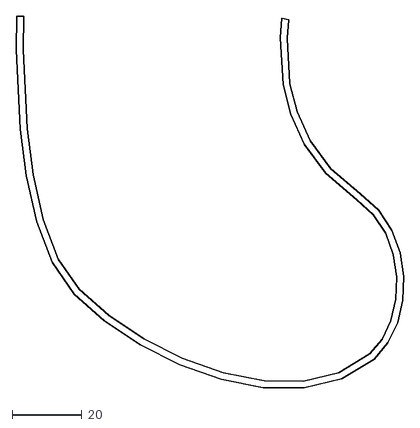
[picture p223: CAD file, 2016-05-25]
components-3d/wires/wire2-core2-d2mm-43d.dxf
111.0 x 106.6
