sadr0b0t/metalrobot/doc/robotcar-model2-инструкция-корпус/blender-render/stl-components/chipkit_uno32.stl

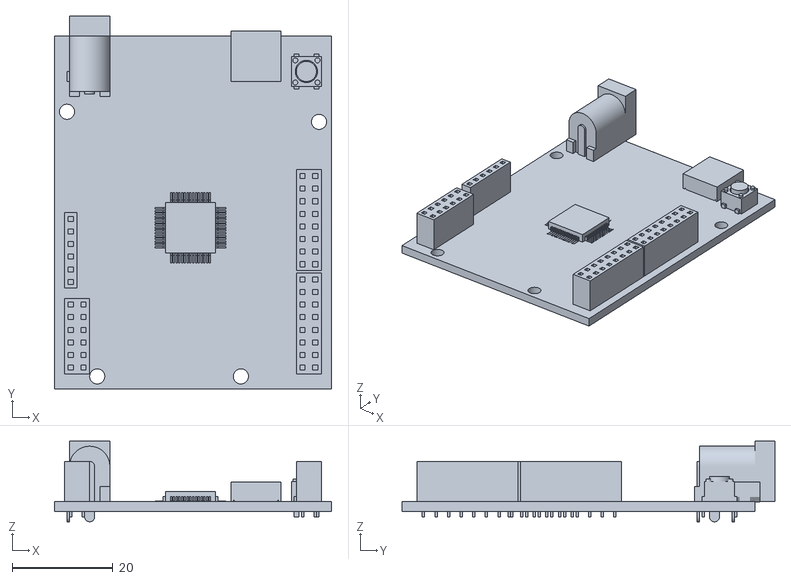
[picture p224: CAD file, 2016-06-02]
doc/robotcar-model2-инструкция-корпус/blender-render/stl-components/chipkit_uno32.stl
55.0 x 74.0 x 16.0
