sadr0b0t/metalrobot/gearbox/gearbox-prototype5/export/axis_jam-motor2.stl

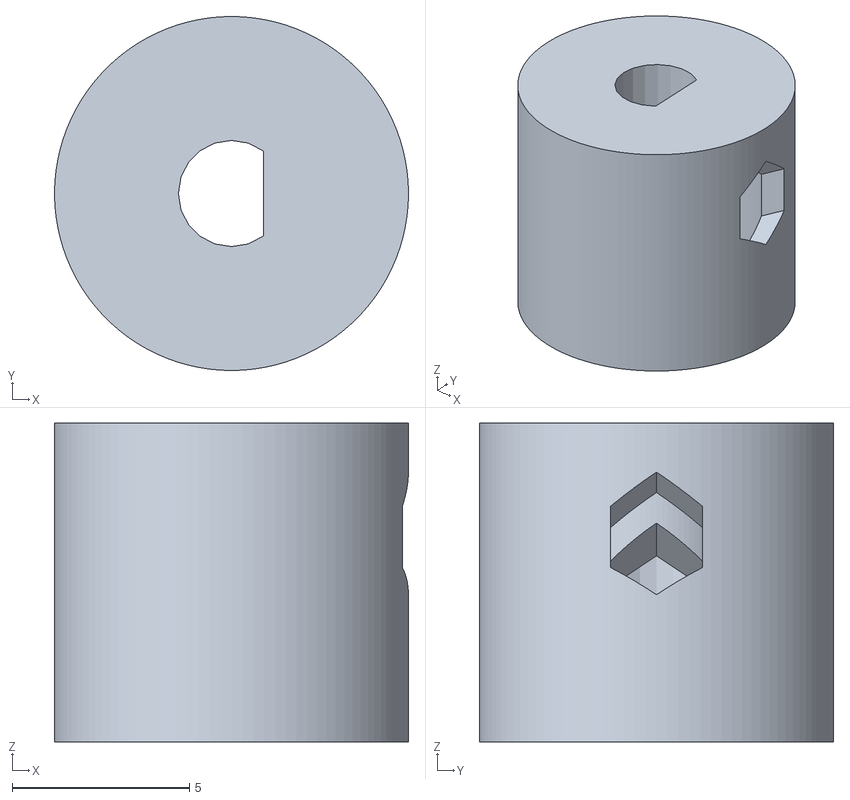
[picture p225: CAD file, 2015-08-15]
gearbox/gearbox-prototype5/export/axis_jam-motor2.stl
10.0 x 10.0 x 9.00
