sadr0b0t/metalrobot/gearbox/gears-3dprint-tests/export/gears-cp1.5-t63-cp1.5-t27-d2.8.stl

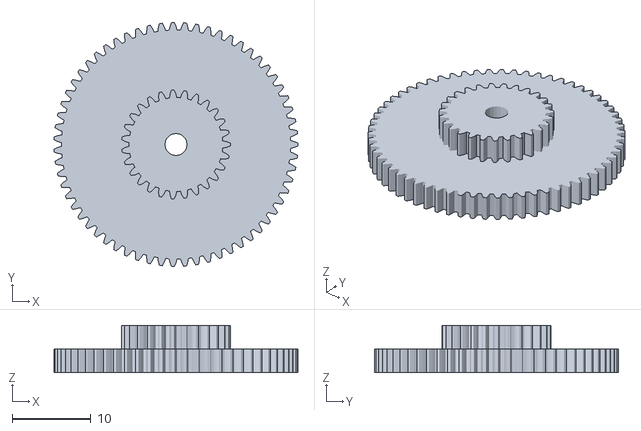
[picture p226: CAD file, 2015-07-16]
gearbox/gears-3dprint-tests/export/gears-cp1.5-t63-cp1.5-t27-d2.8.stl
31.0 x 31.0 x 6.00
