sadr0b0t/metalrobot/gearbox/gears-3dprint-tests/gear-cp1.5-t43.dxf

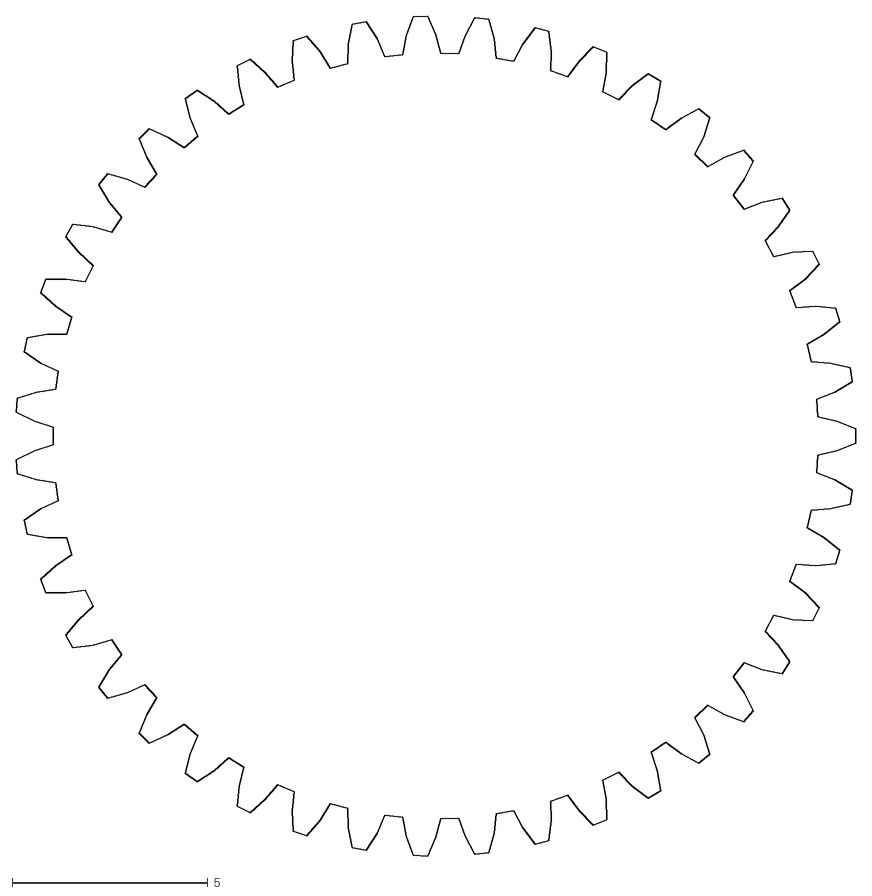
[picture p227: CAD file, 2015-07-16]
gearbox/gears-3dprint-tests/gear-cp1.5-t43.dxf
21.5 x 21.5
