sadr0b0t/metalrobot/gearbox4stepper/stepper-rack-prototype1/box/export-pe0.2/smg-motor_face-pe0.2.stl

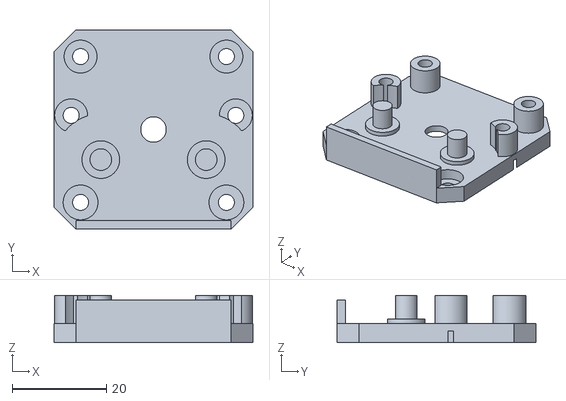
[picture p229: CAD file, 2018-05-07]
gearbox4stepper/stepper-rack-prototype1/box/export-pe0.2/smg-motor_face-pe0.2.stl
42.3 x 42.3 x 10.0
