sadr0b0t/metalrobot/manufacturing/партия10 - контакты 50 отсеков Аватек/wire-plate1-нерж сталь-0.2мм-100шт.dxf

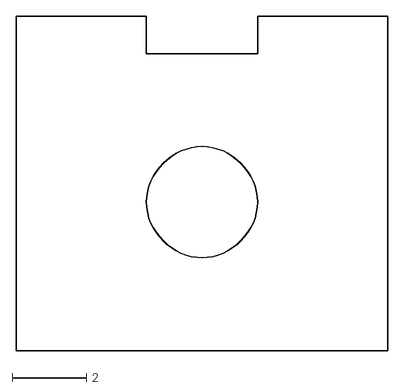
[picture p230: CAD file, 2015-11-17]
manufacturing/партия10 - контакты 50 отсеков Аватек/wire-plate1-нерж сталь-0.2мм-100шт.dxf
10.0 x 9.00
