sadr0b0t/metalrobot/manufacturing/партия5 - контакты для отсека/plate10-нерж сталь-0.5мм-50шт.dxf

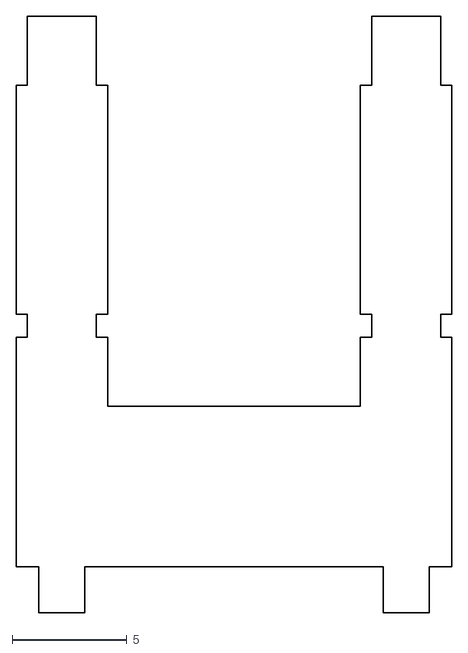
[picture p231: CAD file, 2015-05-29]
manufacturing/партия5 - контакты для отсека/plate10-нерж сталь-0.5мм-50шт.dxf
19.0 x 26.0
