sadr0b0t/metalrobot/manufacturing/партия8 - отсек и моторчик/motor2-brush4-нерж сталь-0.2мм-10шт.dxf

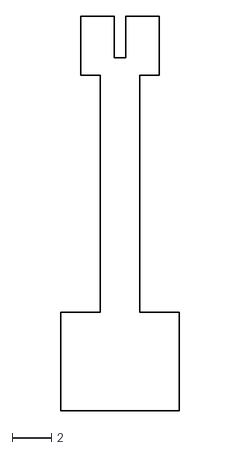
[picture p232: CAD file, 2015-08-16]
manufacturing/партия8 - отсек и моторчик/motor2-brush4-нерж сталь-0.2мм-10шт.dxf
6.00 x 20.0
