sadr0b0t/metalrobot/motor/motor-draft1/export/motor2.dxf

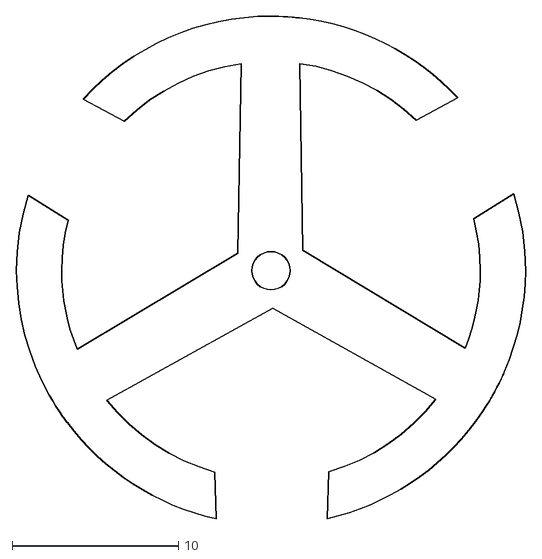
[picture p233: CAD file, 2015-05-29]
motor/motor-draft1/export/motor2.dxf
30.6 x 30.3
