sadr0b0t/metalrobot/motor/motor-prototype1/export/motor2-collector_lid.stl

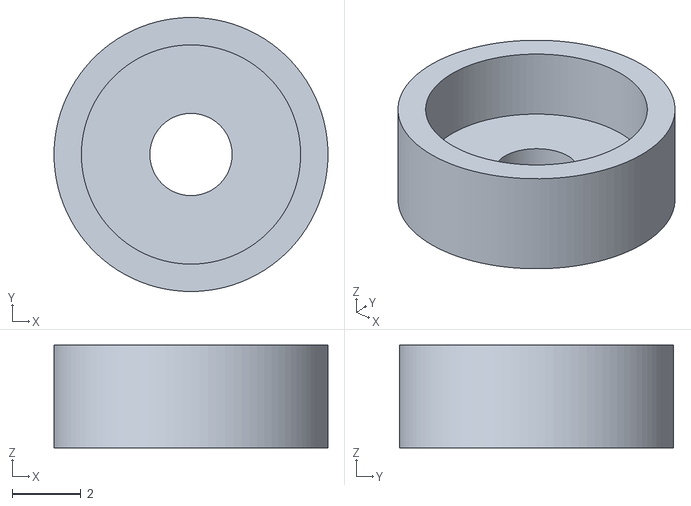
[picture p234: CAD file, 2015-08-16]
motor/motor-prototype1/export/motor2-collector_lid.stl
8.00 x 8.00 x 3.00
