sadr0b0t/metalrobot/parts/export/Araks-1/dxf-5 комплектов/chipKIT_Uno32_hor-1mm-оцинк_сталь_15шт.dxf

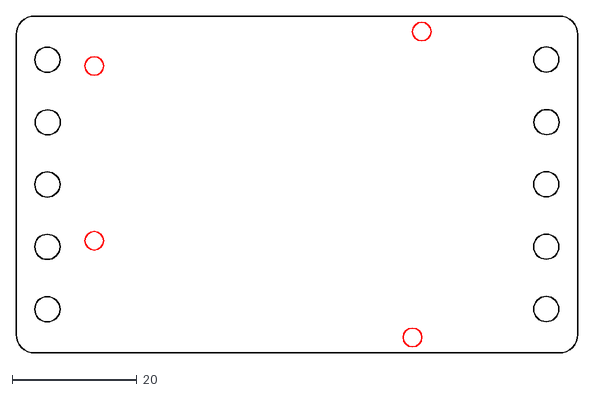
[picture p235: CAD file, 2014-02-14]
parts/export/Araks-1/dxf-5 комплектов/chipKIT_Uno32_hor-1mm-оцинк_сталь_15шт.dxf
90.0 x 54.0
