sadr0b0t/metalrobot/parts/export/Araks-1/dxf/motor1_mount-1mm-оцинк_сталь_10шт.dxf

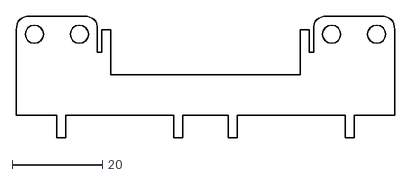
[picture p236: CAD file, 2014-02-14]
parts/export/Araks-1/dxf/motor1_mount-1mm-оцинк_сталь_10шт.dxf
84.0 x 27.0
