sadr0b0t/metalrobot/Robot Car/сборка/днище.dxf

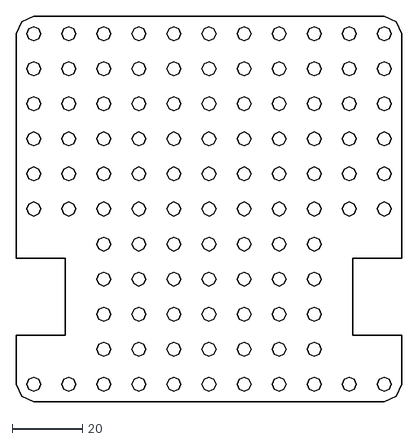
[picture p237: CAD file, 2014-08-31]
Robot Car/сборка/днище.dxf
110.0 x 110.0
