sadr0b0t/metalrobot/spider/export/body.stl

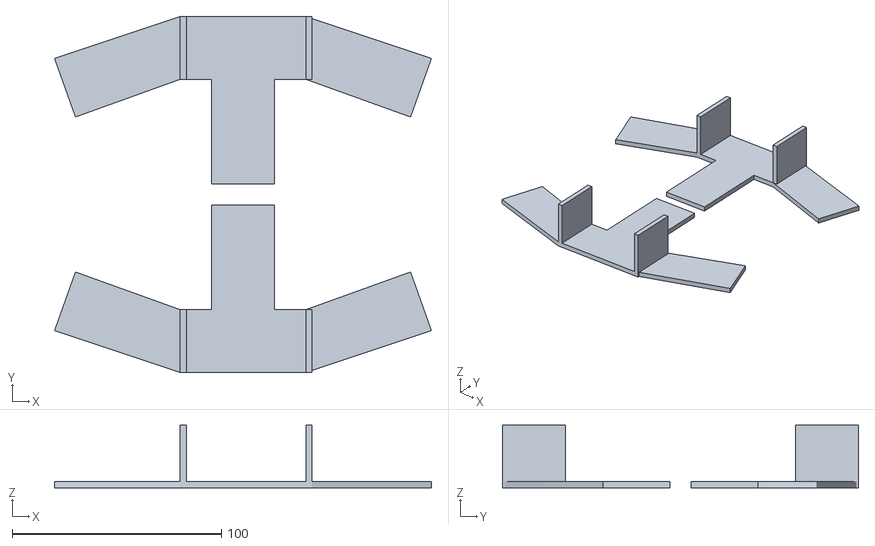
[picture p239: CAD file, 2016-01-19]
spider/export/body.stl
180.0 x 170.0 x 30.0
