sadr0b0t/metalrobot/battery-holder/contacts-draft2/export/contact-plus-2brbrd2.dxf

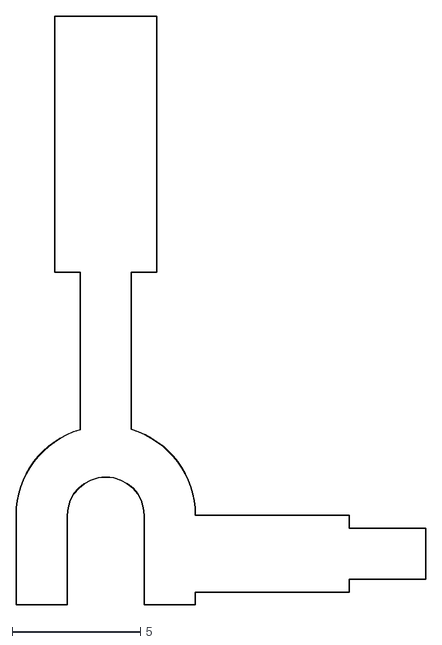
[picture p240: CAD file, 2015-07-11]
battery-holder/contacts-draft2/export/contact-plus-2brbrd2.dxf
16.0 x 23.0
