sadr0b0t/metalrobot/components-3d/wires/export/bls-03.stl

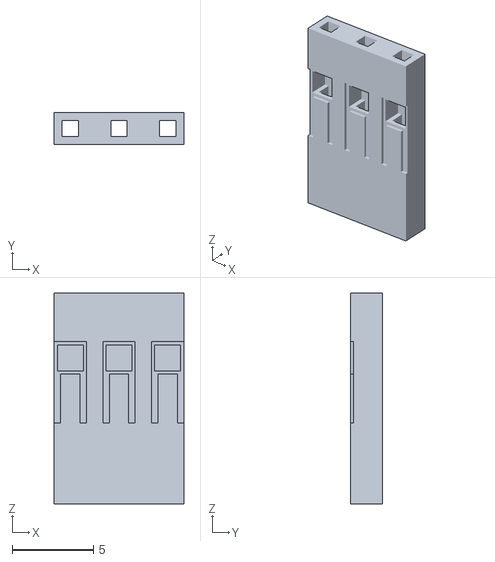
[picture p241: CAD file, 2016-05-25]
components-3d/wires/export/bls-03.stl
8.00 x 2.00 x 13.0
