sadr0b0t/metalrobot/components-3d/wires/u-shaped-terminal-43d.dxf

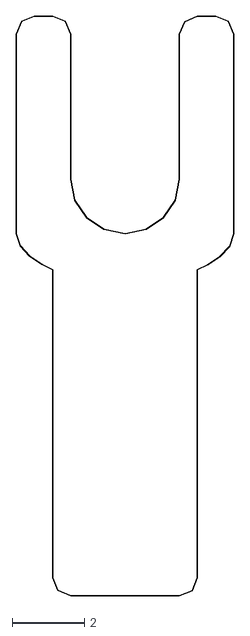
[picture p242: CAD file, 2016-05-25]
components-3d/wires/u-shaped-terminal-43d.dxf
6.00 x 16.0
