sadr0b0t/metalrobot/Robot Car/покрышки/покрышка-форма.scad

print_error = 0.1;

// увеличим ширину фиксирующего обода для внешней формы по сравнению
// с пазом под обод на внутренней форме, чтобы учесть
// погрешность при печати на FDM-принтере
//outer_box_half1(hoop_width=3, print_error=print_error);
outer_box_half2(hoop_width=3, print_error=print_error);

//inner_surface(hoop_width=3, print_error=print_error);

/**
 * Внутренняя поверхность покрышки, должна совпадать 
 * с рельефом колеса.
 * @param hoop_width - ширина обода, выступающего вниз для
 * для фиксации на площадке внешней части формы.
 */
module inner_surface(hoop_width=2, print_error=0) {
  fixator_width=4;
    
  difference() {
    union() {
      // рельеф колеса
      translate([0, 0, 10]) {
        linear_extrude(height=10, twist=10) 
            import(file = "покрышка-внутр.dxf");
        mirror([0, 0, -1]) 
          linear_extrude(height=10, twist=10) 
            import(file = "покрышка-внутр.dxf");
      }
      // выступаящая вверх стенка, чтобы не разливался силикон
      cylinder(h=21, r=22, $fn=100);
    }


    // вычтем изнутри цилиндр для экономии пластика
    translate([0, 0, -1])
      cylinder(h=25, r=18.6, $fn=100);
  }

  // выступающий вниз обод для фиксации на площадке
  difference() {
    translate([0, 0, -5])
      cylinder(h=10, r=20+hoop_width/2-print_error, $fn=100);

    translate([0, 0, -6])
      cylinder(h=12, r=20-hoop_width/2+print_error, $fn=100);
  }

  // фиксторы вращения
  translate([14.5, -fixator_width/2+print_error, -5]) difference() {
    cube([6, fixator_width-print_error*2, 8]);
    // небольшой скос сверху
    translate([0, -0.1, 3]) rotate([0, -45, 0]) cube([8, fixator_width+0.2, 4]);
  }
  mirror([1, 0, 0]) translate([14.5, -fixator_width/2+print_error, -5]) difference() {
    cube([6, fixator_width-print_error*2, 8]);
    // небольшой скос сверху
    translate([0, -0.1, 3]) rotate([0, -45, 0]) cube([8, fixator_width+0.2, 4]);
  }
}

/**
 * Первая половина внешней коробки.
 * @param hoop_width - ширина обода, выступающего вниз для
 * для фиксации на площадке внешней части формы.
 */
module outer_box_half1(hoop_width=2, print_error=0) {
  difference() {
    outer_box(hoop_width=hoop_width, print_error=print_error);

    translate([0, -34, -8])
        cube([34, 68, 32]);
  }
}

/**
 * Вторая половина внешней коробки.
 * @param hoop_width - ширина обода, выступающего вниз для
 * для фиксации на площадке внешней части формы.
 */
module outer_box_half2(hoop_width=2, print_error=0) {
  difference() {
    outer_box(hoop_width=hoop_width, print_error=print_error);

    translate([-34, -34, -8])
        cube([34, 68, 32]);
  }
}

/**
 * Внешняя коробка с рельефом протектора.
 * @param hoop_width - ширина обода, выступающего вниз для
 * для фиксации на площадке внешней части формы.
 */
module outer_box(hoop_width=2, print_error=0) {
  fixator_width=4;
    
  difference() {
    // матрица для рисунка протектора
    translate([0, 0, -7])
      cylinder(h=28, r=33, $fn=100);
    
    // рельефный протектор
    tyre_pattern();

    // стенка наверху, чтобы не разливался силикон
    translate([0, 0, 20])
      cylinder(h=5, r=31, $fn=100);

    // паз для выступающего вниз обода
    difference() {
      translate([0, 0, -5.5])
        cylinder(h=10, r=20+hoop_width/2+print_error, $fn=100);

      translate([0, 0, -6])
        cylinder(h=12, r=20-hoop_width/2-print_error, $fn=100);
    }
      
    // пазы для фиксаторов
    translate([14, -fixator_width/2-print_error, -5.5]) 
      cube([6, fixator_width+print_error*2, 6]);
    translate([-20, -fixator_width/2-print_error, -5.5]) 
      cube([6, fixator_width+print_error*2, 6]);

    // внутренняя дырка для экономии пластика
    translate([0, 0, -10])
      cylinder(h=20, r=13, $fn=100);
  }
}

/** Рисунок проектора */
module tyre_pattern() {
  // рельефный протектор
  translate([0, 0, 10]) {
    linear_extrude(height=10, twist=10) 
        import(file = "покрышка-внешн.dxf");
    mirror([0, 0, -1]) 
      linear_extrude(height=10, twist=10) 
        import(file = "покрышка-внешн.dxf");
  }
}
