sadr0b0t/metalrobot/(list of files, cad)

Other CAD files:
gearbox4stepper/stepper-rack-prototype1/box/export/smg-gear_motor-ds-pe0.stl
parts/export/Araks-1/dwg-ac-5 комплектов/servo_ds329hv_box-1mm-оцинк_сталь_10шт.dwg
parts/export/Araks-1/dwg-ds-5 комплектов/motor1_mount-1mm-оцинк_сталь_20шт.dwg
battery-holder/export/battery-aa-holder-4-mod3.stl
doc/robotcar-model2-инструкция-корпус/blender-render/stl-parts/frame-top.stl
gearbox4stepper/stepper-rack-prototype1/box/export/smg-gear_motor-pe0.stl
parts/export/Araks-1/dwg-ac-5 комплектов/servo_mount-1mm-оцинк_сталь_30шт.dwg
parts/export/Araks-1/dwg-ds-5 комплектов/servo_ds329hv_rib-1mm-оцинк_сталь_20шт.dwg
Robot Car/колеса/export/wheel_generic_left.stl
brbrd-bender/export/brbrd-bender-plug-pe0.1.stl
doc/robotcar-model2-инструкция-компоненты/blender-render/stl-addons/tyre_box_half2.stl
gearbox4stepper/stepper-rack-prototype1/box/export-pe0.2/smg-gear_transmission1-pe0.2.stl
parts/export/Araks-1/dwg-ac-5 комплектов/chipKIT_Uno32_vert-1mm-оцинк_сталь_10шт.dwg
parts/export/Araks-1/dwg-ds-5 комплектов/chipKIT_WF32_vert-1mm-оцинк_сталь_15шт.dwg
Robot Car/колеса/export/wheel_motor1_right.stl
brbrd-bender/export/brbrd-bender-plug-pe0.2.stl
doc/robotcar-model2-инструкция-корпус/blender-render/stl-parts/wheel-d3mm-ds-right.stl
parts/export/Araks-1/dwg-ac-5 комплектов/motor1_mount-1mm-оцинк_сталь_10шт.dwg
parts/export/Araks-1/dwg-ds-5 комплектов/servo_ds329hv_mount-1mm-оцинк_сталь_20шт.dwg
Robot Car/колеса/export/wheel_motor2_left.stl
battery-holder/export/battery-aa-holder-6-mod2-v4.stl
brbrd-bender/export/brbrd-bender-socket-pe0.2.stl
Robot Car/сборка/машинка.scad
robotcar2/корпус/chasis-43d/wheel.scad
Robot Car/колеса/export/wheel_motor1_left.stl
Robot Car/колеса/export/wheel_motor2_right.stl
Robot Car/корпус/export/днище.dxf
Robot Car/корпус/export/корпус.dxf
Robot Car/корпус/export/крепление-оси.dxf
Robot Car/корпус/export/рама-моторы.dxf
Robot Car/корпус/export/рама-ось.dxf
Robot Car/покрышки/export/tyre_box_half1.stl
Robot Car/покрышки/export/tyre_box_half2.stl
Robot Car/покрышки/export/tyre_inner_surface.stl
Robot Car/сборка/колесо.dxf
Robot Car/сборка/рама-ось.dxf
battery-holder/contacts-draft2/export/2brbrd1.dxf
battery-holder/contacts-draft2/export/2brbrd3.dxf
battery-holder/contacts-draft2/export/contact-minus-2brbrd.dxf
battery-holder/contacts-draft2/export/contact-minus-2brbrd2.dxf
battery-holder/contacts-draft2/export/contact-minus-2brbrd3.dxf
battery-holder/contacts-draft2/export/contact-minus-minus.dxf
battery-holder/contacts-draft2/export/contact-minus.dxf
battery-holder/contacts-draft2/export/contact-plus-2brbrd.dxf
battery-holder/contacts-draft2/export/contact-plus-2brbrd3.dxf
battery-holder/contacts-draft2/export/contact-plus-plus.dxf
battery-holder/contacts-draft2/export/contact-plus.dxf
battery-holder/export/battery-aa-holder-2.stl
battery-holder/export/battery-aa-holder-4.stl
battery-holder/export/battery-aa-holder-6-mod1.stl
battery-holder/export/battery-aa-holder-6-mod2-v2.stl
battery-holder/export/battery-aa-holder-6-mod2.stl
battery-holder/export/battery-aa-holder.stl
battery-holder/screw-nut-m3.dxf
brbrd-bender/export/brbrd-bender-plug.stl
brbrd-bender/export/brbrd-bender-socket-pe0.1.stl
brbrd-bender/export/brbrd-bender-socket.stl
components-3d/screws/3pty/ISOThread.scad
components-3d/screws/export/crosshead_screw-M3x16.stl
components-3d/screws/export/crosshead_screw-M3x18.stl
components-3d/screws/export/crosshead_screw-M3x20.stl
components-3d/screws/export/crosshead_screw-M3x22.stl
components-3d/screws/export/crosshead_screw-M3x24.stl
components-3d/screws/export/crosshead_screw-M3x28.stl
components-3d/screws/export/crosshead_screw-M3x30.stl
components-3d/screws/export/crosshead_screw-M3x4.stl
components-3d/screws/export/crosshead_screw-M3x8.stl
components-3d/screws/export/crosshead_screw-M4x16.stl
components-3d/screws/export/crosshead_screw-M4x18.stl
components-3d/screws/export/crosshead_screw-M4x20.stl
components-3d/screws/export/crosshead_screw-M4x22.stl
components-3d/screws/export/crosshead_screw-M4x24.stl
components-3d/screws/export/crosshead_screw-M4x26.stl
components-3d/screws/export/crosshead_screw-M4x28.stl
components-3d/screws/export/crosshead_screw-M4x30.stl
components-3d/screws/export/crosshead_screw-M4x32.stl
components-3d/screws/export/crosshead_screw-M4x34.stl
components-3d/screws/export/crosshead_screw-M4x36.stl
components-3d/screws/export/crosshead_screw-M4x38.stl
components-3d/screws/export/crosshead_screw-M4x4.stl
components-3d/screws/export/crosshead_screw-M4x6.stl
components-3d/screws/export/crosshead_screw-M4x8.stl
components-3d/screws/export/mounting_screw-M3x10.stl
components-3d/screws/export/mounting_screw-M3x4.stl
components-3d/screws/export/mounting_screw-M3x6.stl
components-3d/wires/wire3-core2-d1mm-43d.dxf
components-3d/wires/wire3-core3-d1mm-43d.dxf
components-3d/wires/wire4-1core-d5mm-43d.dxf
doc/robotcar-model2-инструкция-компоненты/blender-render/parts-cartoon-render-compositing.blend
doc/robotcar-model2-инструкция-компоненты/blender-render/stl-components/screws/crosshead_screw-M3x26.stl
doc/robotcar-model2-инструкция-компоненты/blender-render/stl-components/screws/crosshead_screw-M4x40.stl
doc/robotcar-model2-инструкция-компоненты/blender-render/stl-components/screws/test/crosshead_screw-M4x14-thr10-cq100.stl
doc/robotcar-model2-инструкция-компоненты/blender-render/stl-components/screws/test/crosshead_screw-M4x14-thr30-cq30.stl
doc/robotcar-model2-инструкция-корпус/blender-render/stl-components/Pololu-dshaft.stl
doc/robotcar-model2-инструкция-корпус/blender-render/stl-components/arduino_uno-china.stl
doc/robotcar-model2-инструкция-корпус/blender-render/stl-components/axis-d2mm-l150mm.stl
doc/robotcar-model2-инструкция-корпус/blender-render/stl-components/breadboard-17x10.stl
doc/robotcar-model2-инструкция-корпус/blender-render/stl-components/cable_usb-a-b.stl
doc/robotcar-model2-инструкция-корпус/blender-render/stl-components/chip-dip-2x8.stl
doc/robotcar-model2-инструкция-корпус/blender-render/stl-components/screws/crosshead_screw-M3x10.stl
doc/robotcar-model2-инструкция-корпус/blender-render/stl-components/screws/crosshead_screw-M3x12.stl
doc/robotcar-model2-инструкция-корпус/blender-render/stl-components/screws/crosshead_screw-M3x14.stl
doc/robotcar-model2-инструкция-корпус/blender-render/stl-components/screws/crosshead_screw-M3x6.stl
doc/robotcar-model2-инструкция-корпус/blender-render/stl-components/screws/crosshead_screw-M4x10.stl
doc/robotcar-model2-инструкция-корпус/blender-render/stl-components/screws/crosshead_screw-M4x12.stl
doc/robotcar-model2-инструкция-корпус/blender-render/stl-components/screws/crosshead_screw-M4x14.stl
doc/robotcar-model2-инструкция-корпус/blender-render/stl-components/screws/mounting_screw-M3x8.stl
doc/robotcar-model2-инструкция-корпус/blender-render/stl-components/screws/nut-M3.stl
doc/robotcar-model2-инструкция-корпус/blender-render/stl-components/screws/nut-M4.stl
doc/robotcar-model2-инструкция-корпус/blender-render/stl-components/screws/spring_washer-M3.stl
doc/robotcar-model2-инструкция-корпус/blender-render/stl-components/screws/spring_washer-M4.stl
doc/robotcar-model2-инструкция-корпус/blender-render/stl-components/wire1-1core-pin-pin.stl
doc/robotcar-model2-инструкция-корпус/blender-render/stl-parts/angle_1x4.stl
doc/robotcar-model2-инструкция-корпус/blender-render/stl-parts/axis_fix-pe0.2.stl
doc/robotcar-model2-инструкция-корпус/blender-render/stl-parts/axis_jam.stl
doc/robotcar-model2-инструкция-корпус/blender-render/stl-parts/frame_fix-pe0.2.stl
doc/robotcar-model2-инструкция-корпус/blender-render/stl-parts/motor_fix-pe0.2.stl
doc/robotcar-model2-инструкция-корпус/blender-render/stl-parts/tyre.stl
doc/robotcar-model2-инструкция-корпус/blender-render/stl-parts/wheel-d2mm-left.stl
doc/robotcar-model2-инструкция-корпус/blender-render/stl-parts/wheel-d2mm-right.stl
doc/robotcar-model2-инструкция-корпус/blender-render/stl-parts/wheel-d3mm-ds-left.stl
gearbox/gearbox-prototype1/export/gearbox-column.stl
gearbox/gearbox-prototype1/export/gearbox-shim.stl
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
