sadr0b0t/metalrobot/manufacturing/партия11 - коробка 10 наборов/коробка-ровер-микрогофро-1000x700mm.pdf

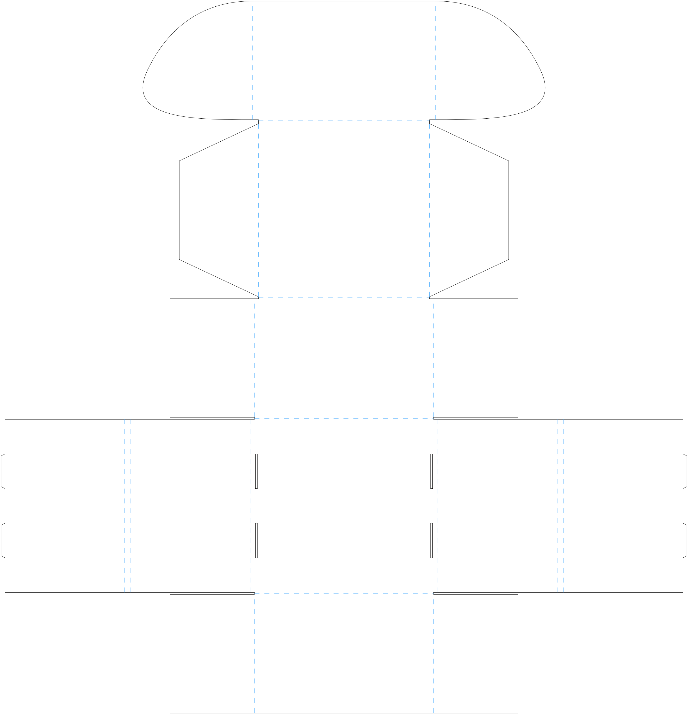
[picture p243: figure]
