sadr0b0t/metalrobot/manufacturing/партия11 - коробка 10 наборов/коробка-набор-микрогофро-1000x1500mm.pdf

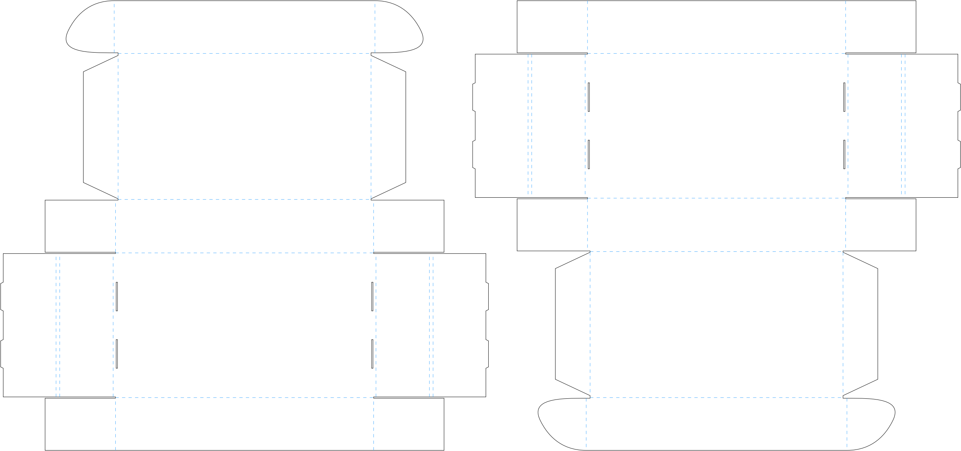
[picture p244: figure]
