sadr0b0t/metalrobot/manufacturing/партия11 - коробка 10 наборов/коробка-набор-микрогофро-1000x700mm.pdf

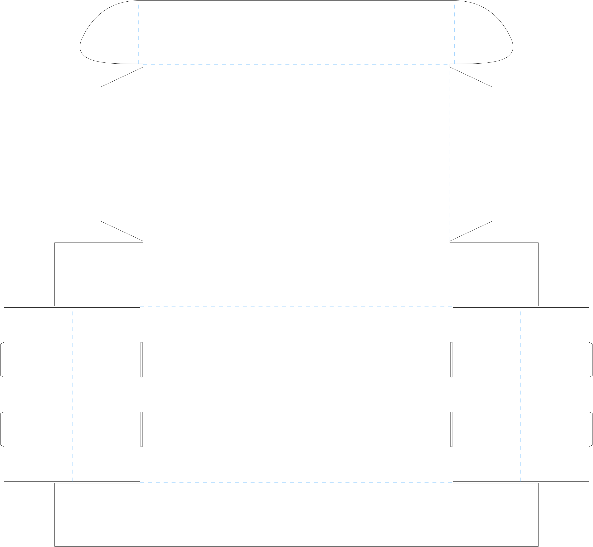
[picture p245: figure]
