sadr0b0t/metalrobot/manufacturing/партия12/коробка и ложемент - резка/ложемент-набор.pdf

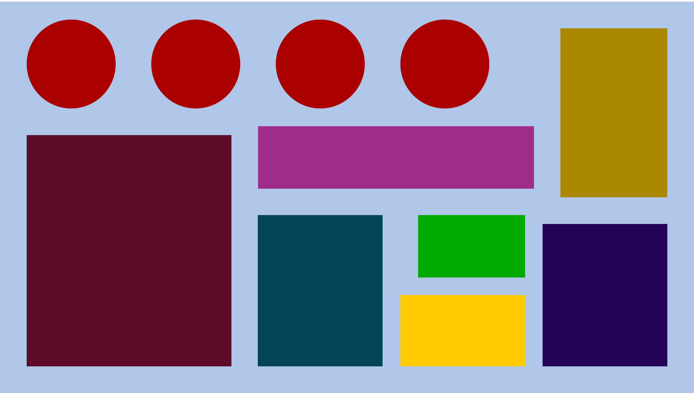
[picture p246: figure]
