sadr0b0t/metalrobot/gearbox4stepper/stepper-rack-prototype1/step_motor_nema_17_stepper_motor.jpg

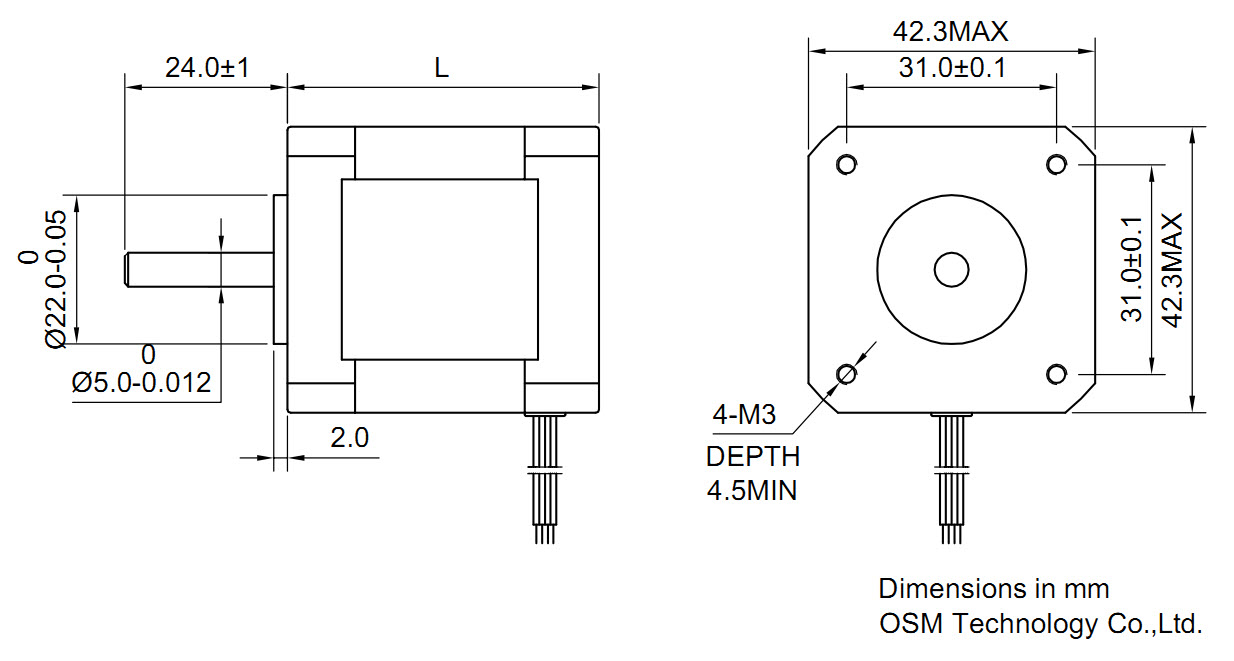
gearbox4stepper/stepper-rack-prototype1/step_motor_nema_17_stepper_motor.jpg
