sadr0b0t/metalrobot/doc/robotcar-model2-инструкция-компоненты/Screw render-test.pdf

Детали набора Робот Машинка

модель 2

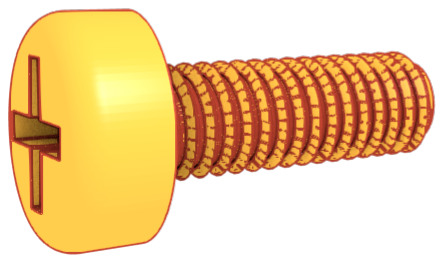
[picture p259: figure]

Винт M4x12 | 1 шт

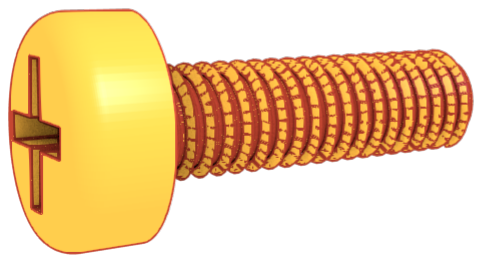
[picture p260: figure]

Винт M4x14 thr30 cq30 (default
ISOThread) | 1 шт

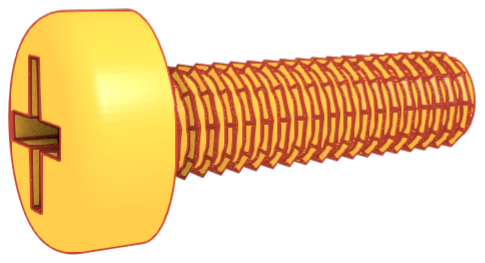
[picture p261: figure]

Винт M4x14 thr10 cq100 | 1 шт

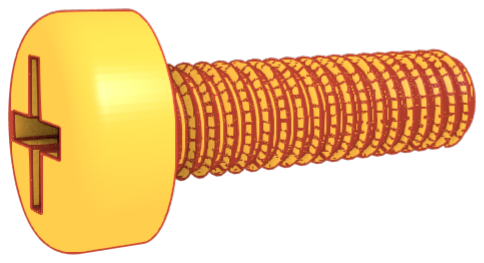
[picture p262: figure]

Винт M4x14 thr30 cq30 | 1 шт

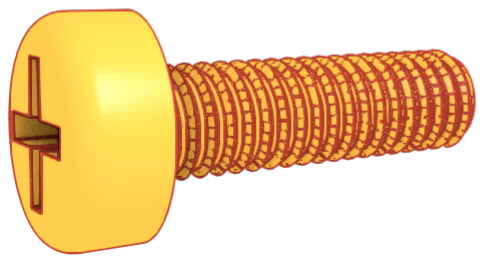
[picture p263: figure]

Винт M4x14 thr30 cq100 | 1 шт

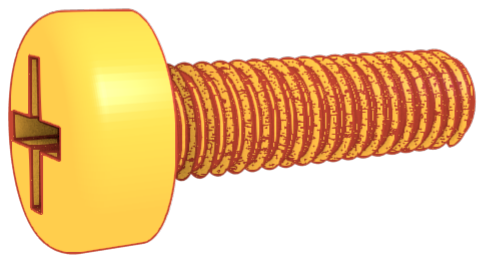
[picture p264: figure]

Винт M4x14 thr100 cq30 | 1 шт

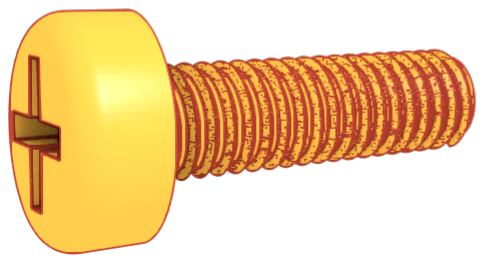
[picture p265: figure]

Винт M4x14 thr100 cq100 | 1 шт

1

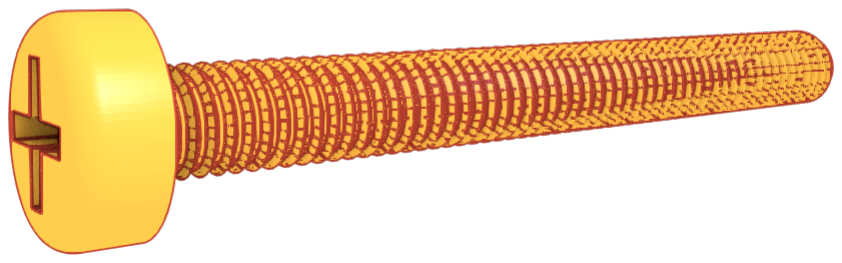
[picture p266: figure]

Винт M4x40 thr30 cq30 | 1 шт

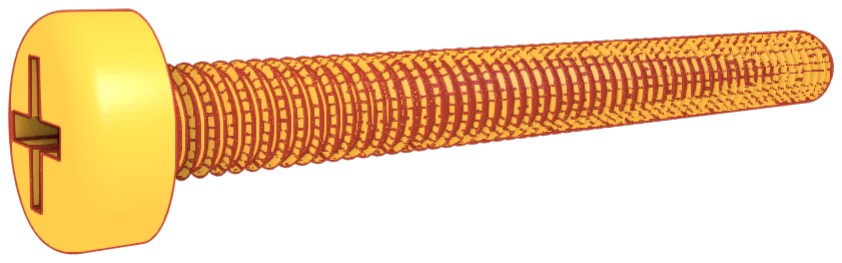
[picture p267: figure]

Винт M4x40 thr30 cq100 | 1 шт

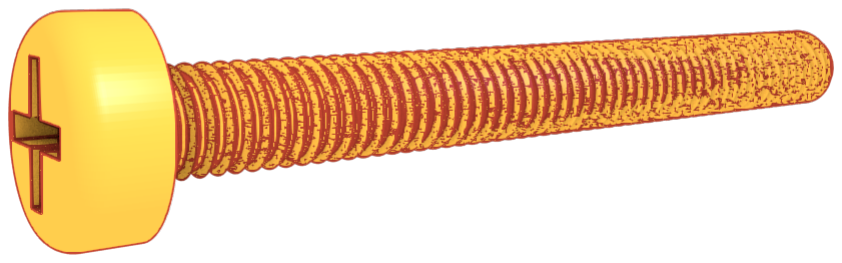
[picture p268: figure]

Винт M4x40 thr100 cq30 | 1 шт

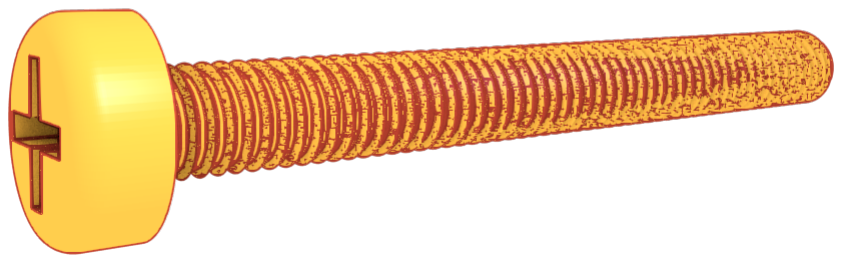
[picture p269: figure]

Винт M4x40 thr100 cq100 | 1 шт

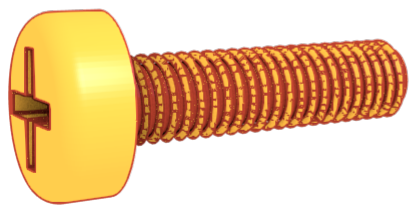
[picture p270: figure]

Винт M3x12 | 1 шт

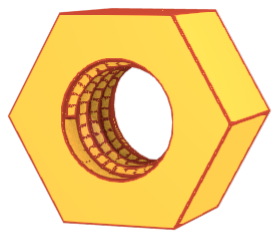
[picture p271: figure]

Гайка M4 | 1 шт

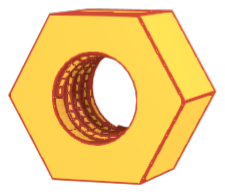
[picture p272: figure]

Гайка M3 | 1 шт

2
