sadr0b0t/metalrobot/doc/robotcar-model2-инструкция-компоненты/blender-render/render/motor-fix-view2-red.png

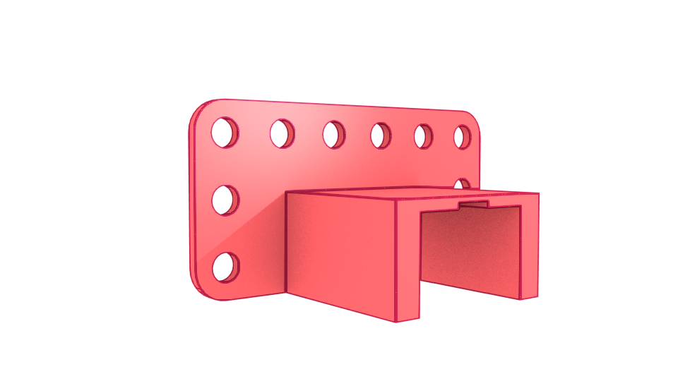
doc/robotcar-model2-инструкция-компоненты/blender-render/render/motor-fix-view2-red.png
