sadr0b0t/metalrobot/doc/robotcar-model2-инструкция-компоненты/fig/motor-fix.png

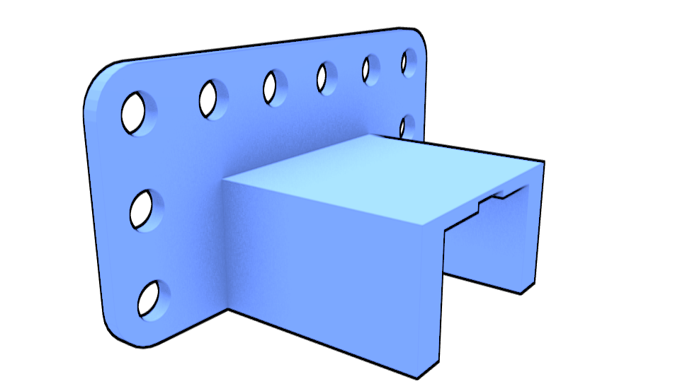
doc/robotcar-model2-инструкция-компоненты/fig/motor-fix.png
