sadr0b0t/metalrobot/(threads)

Thread 1 (2018-02-07):

Робот машинка: разные пины в разных инструкциях

sadr0b0t, 2018-02-07:
Во всех прошивках и в старой инструкции на слайдах для левого мотора стоят пины 8,9,11, для правого - 3,4,6. В красивой инструкции для брошюры все наоборот: левый мотор - 3,4,6, правый - 8,9,11. Для этого есть причина - на рисунке удобнее "проводить" провода без пересечений (плюс там есть определенное преимущество и логика при физическом протягивании проводов - пины 3,4,6 на плате стоят ближе к левому краю машинки).

Если начинать с чистого листа, то лучше второй вариант. Но т.к. уже есть большой багаж старого кода и инструкций, временами получается путаница.

В общем, во-первых, нужно отметить, что такая проблема имеет место быть. Во-вторых, принять окончательное решение - исправить новую инструкцию для совместимости или заморозить старый код и старые инструкции как легаси, а в новый репозиторий перенести прошивки с исправлениями под новую распиновку.

Оба варианта имеют преимущества и недостатки. Здесь будет финальное решение.
