sadr0b0t/metalrobot/manufacturing/партия11.1 - наклейки на коробку 10 наборов/design1-разворот-верх-310x440mm.pdf

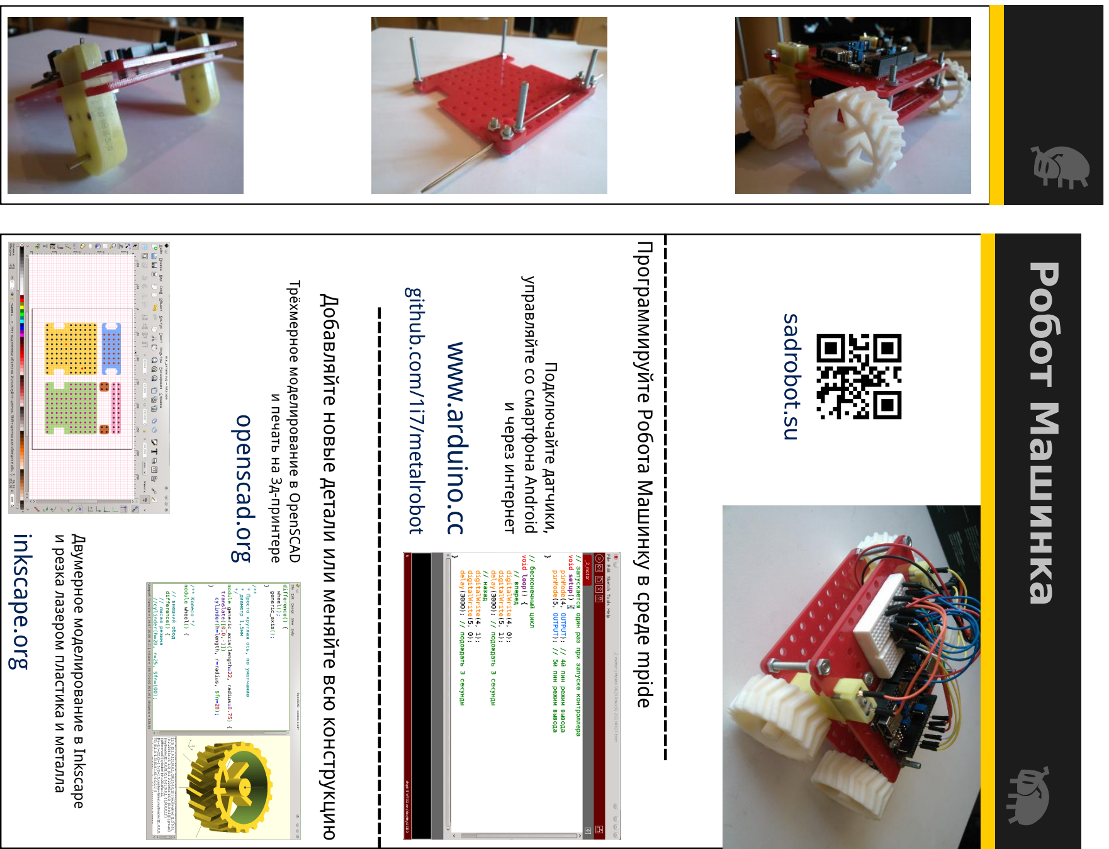
[picture p275: page 1]
