sadr0b0t/metalrobot/manufacturing/партия11.1 - наклейки на коробку 10 наборов/design1-разворот-стенки-310x440mm.pdf

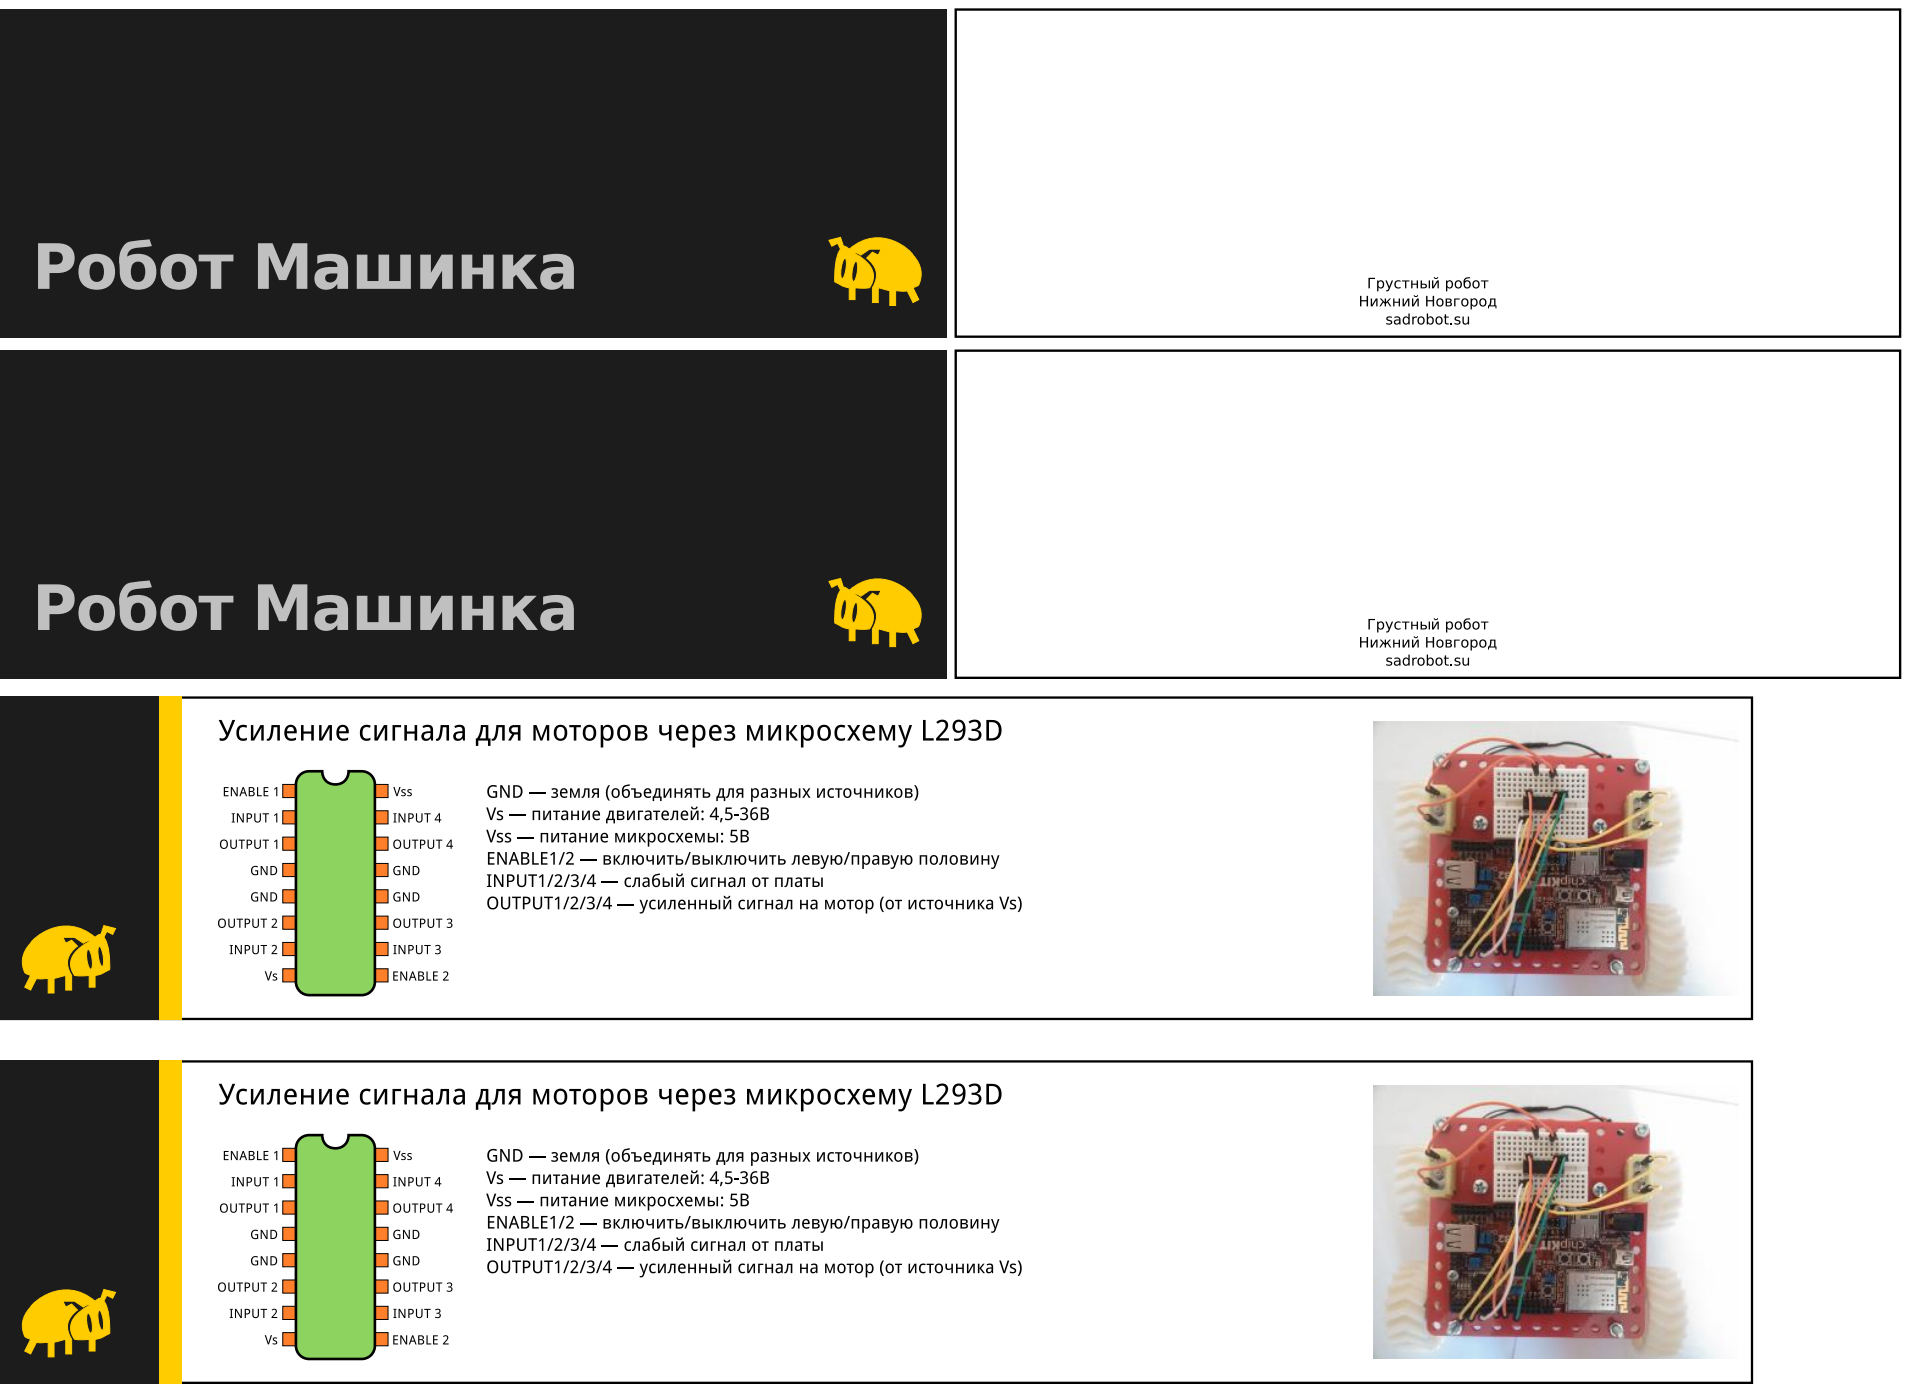
[picture p276: page 1]
