sadr0b0t/metalrobot/manufacturing/партия11 - коробка 10 наборов/ложемент-поролон-1000x2000mm.pdf

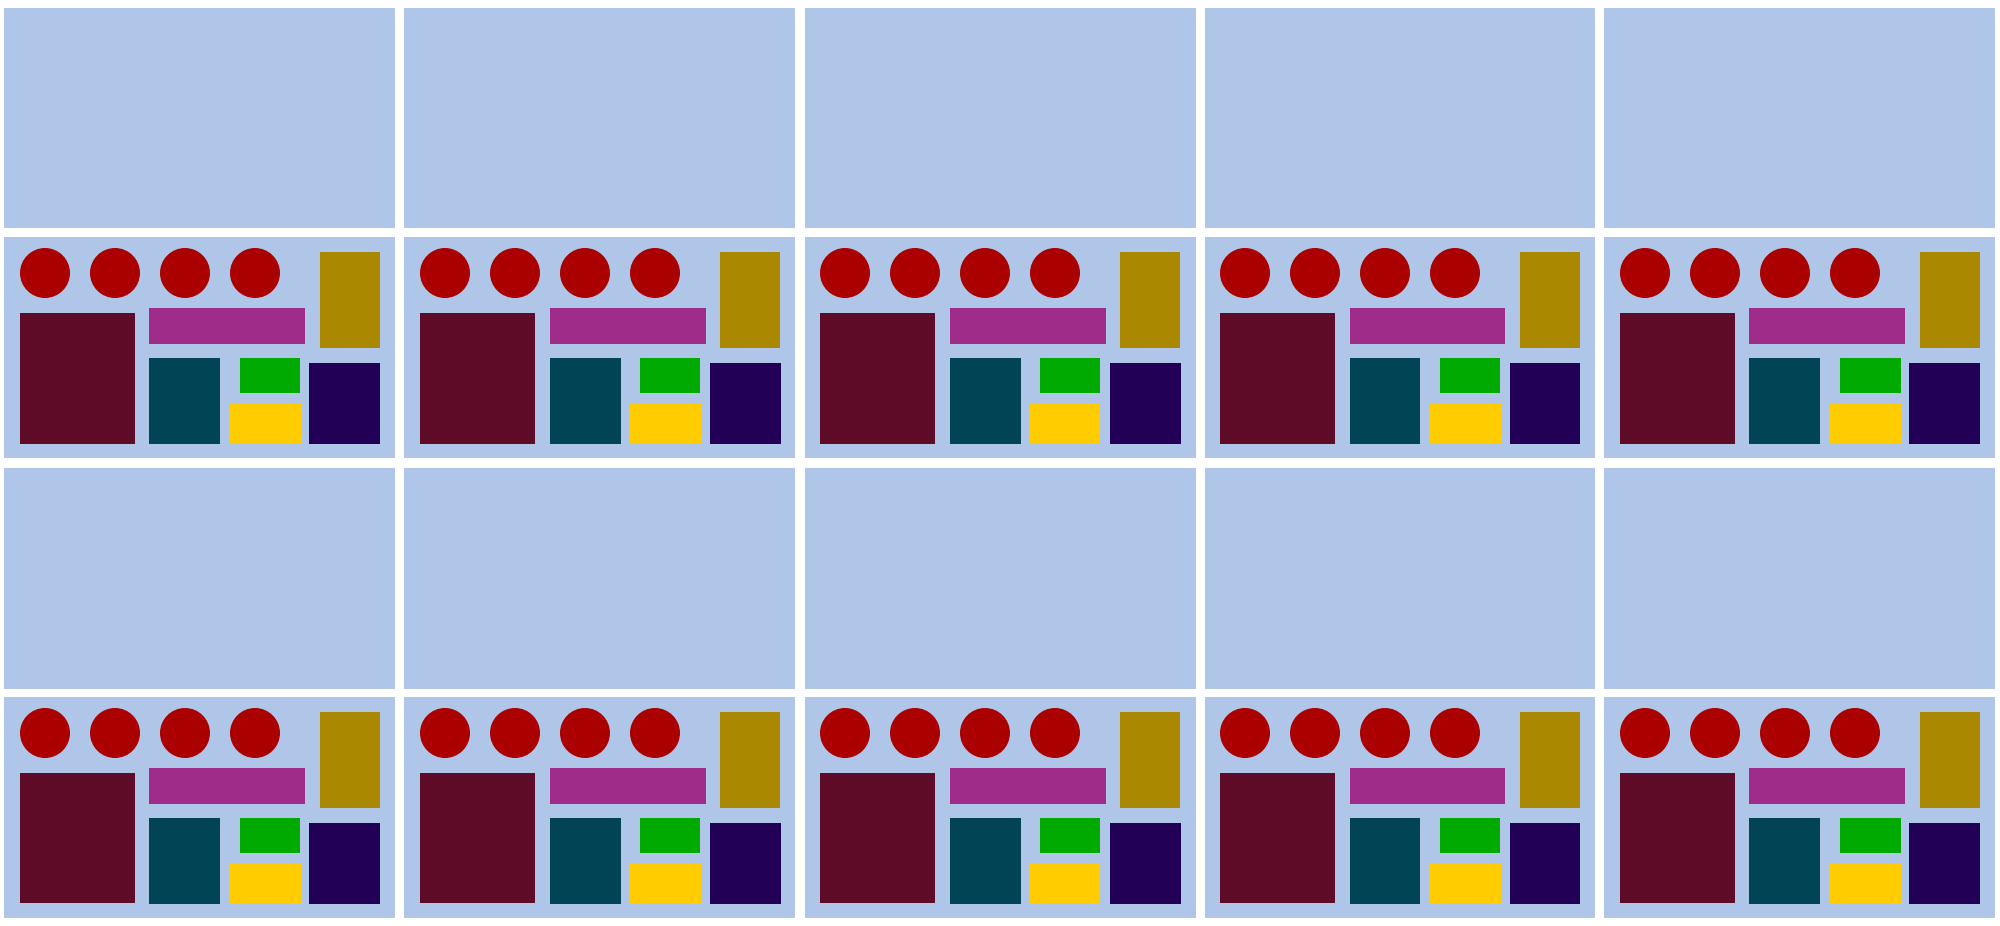
[picture p277: page 1]
