sadr0b0t/metalrobot/manufacturing/партия10 - контакты 50 отсеков Аватек/contacts-2print.pdf

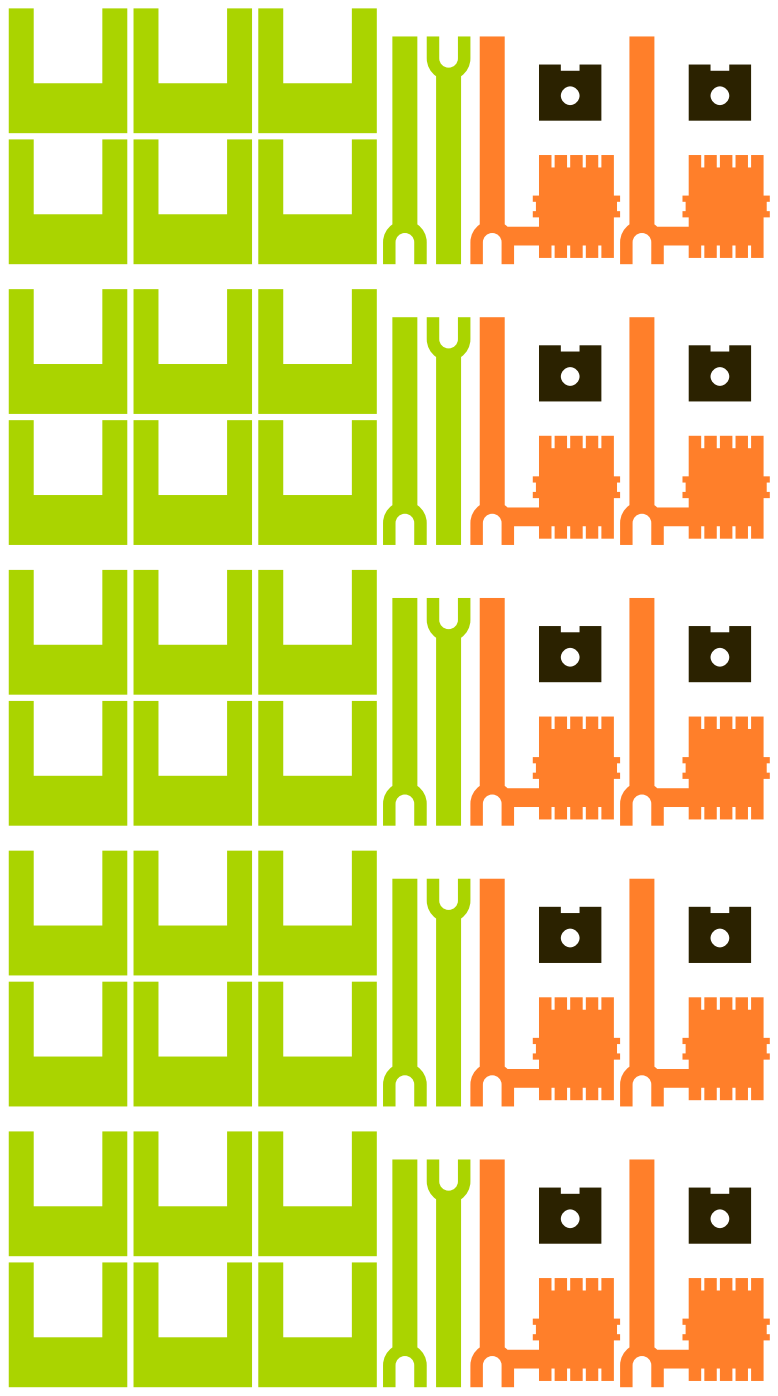
[picture p278: page 1]
