sadr0b0t/metalrobot/manufacturing/партия7 - редуктор2/gearboxes2.pdf

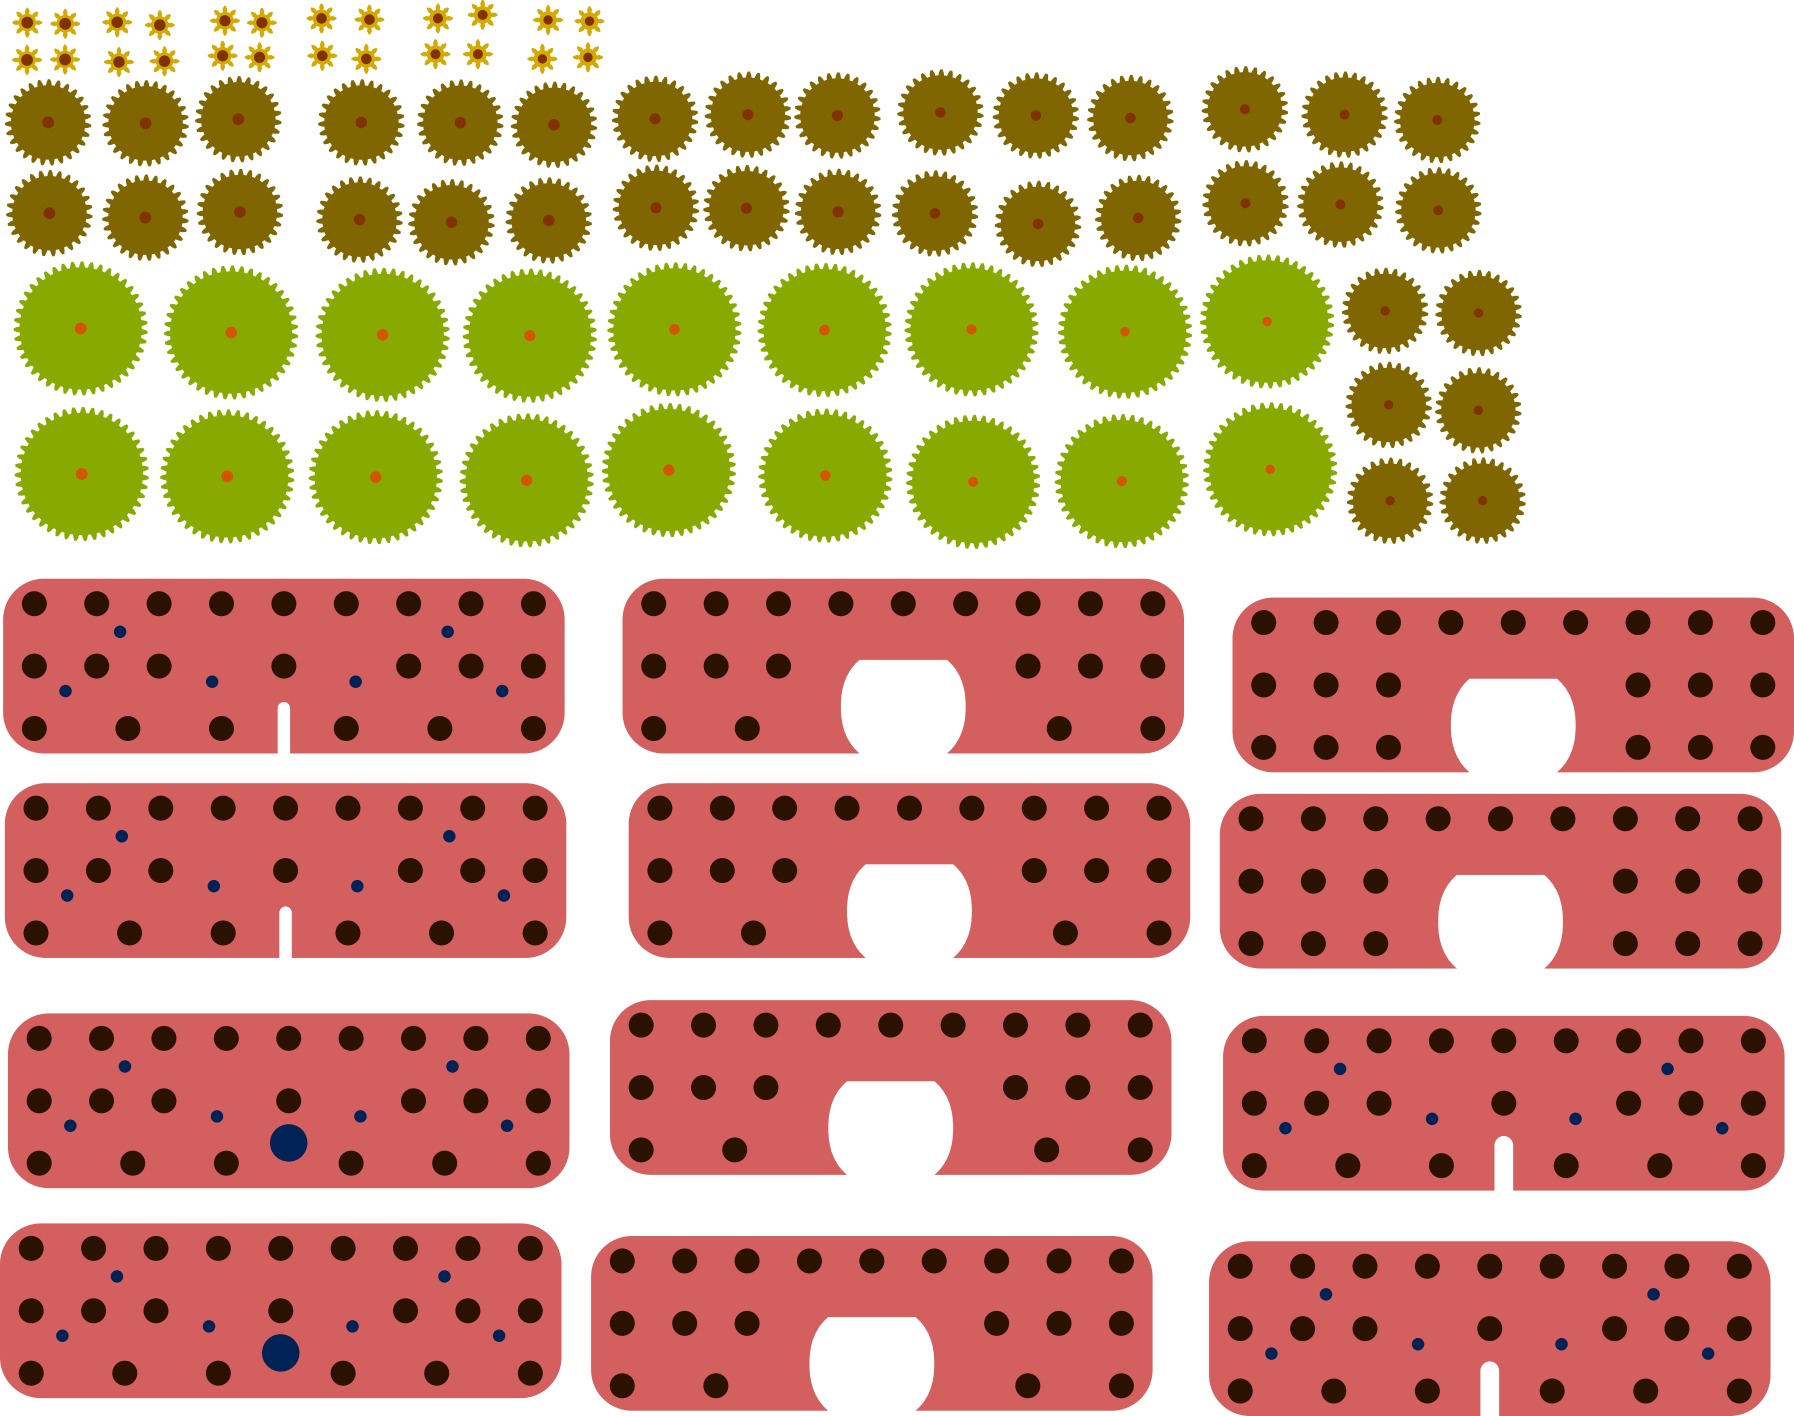
[picture p279: page 1]
