sadr0b0t/metalrobot/manufacturing/партия6 - редуктор/gearboxes-6.pdf

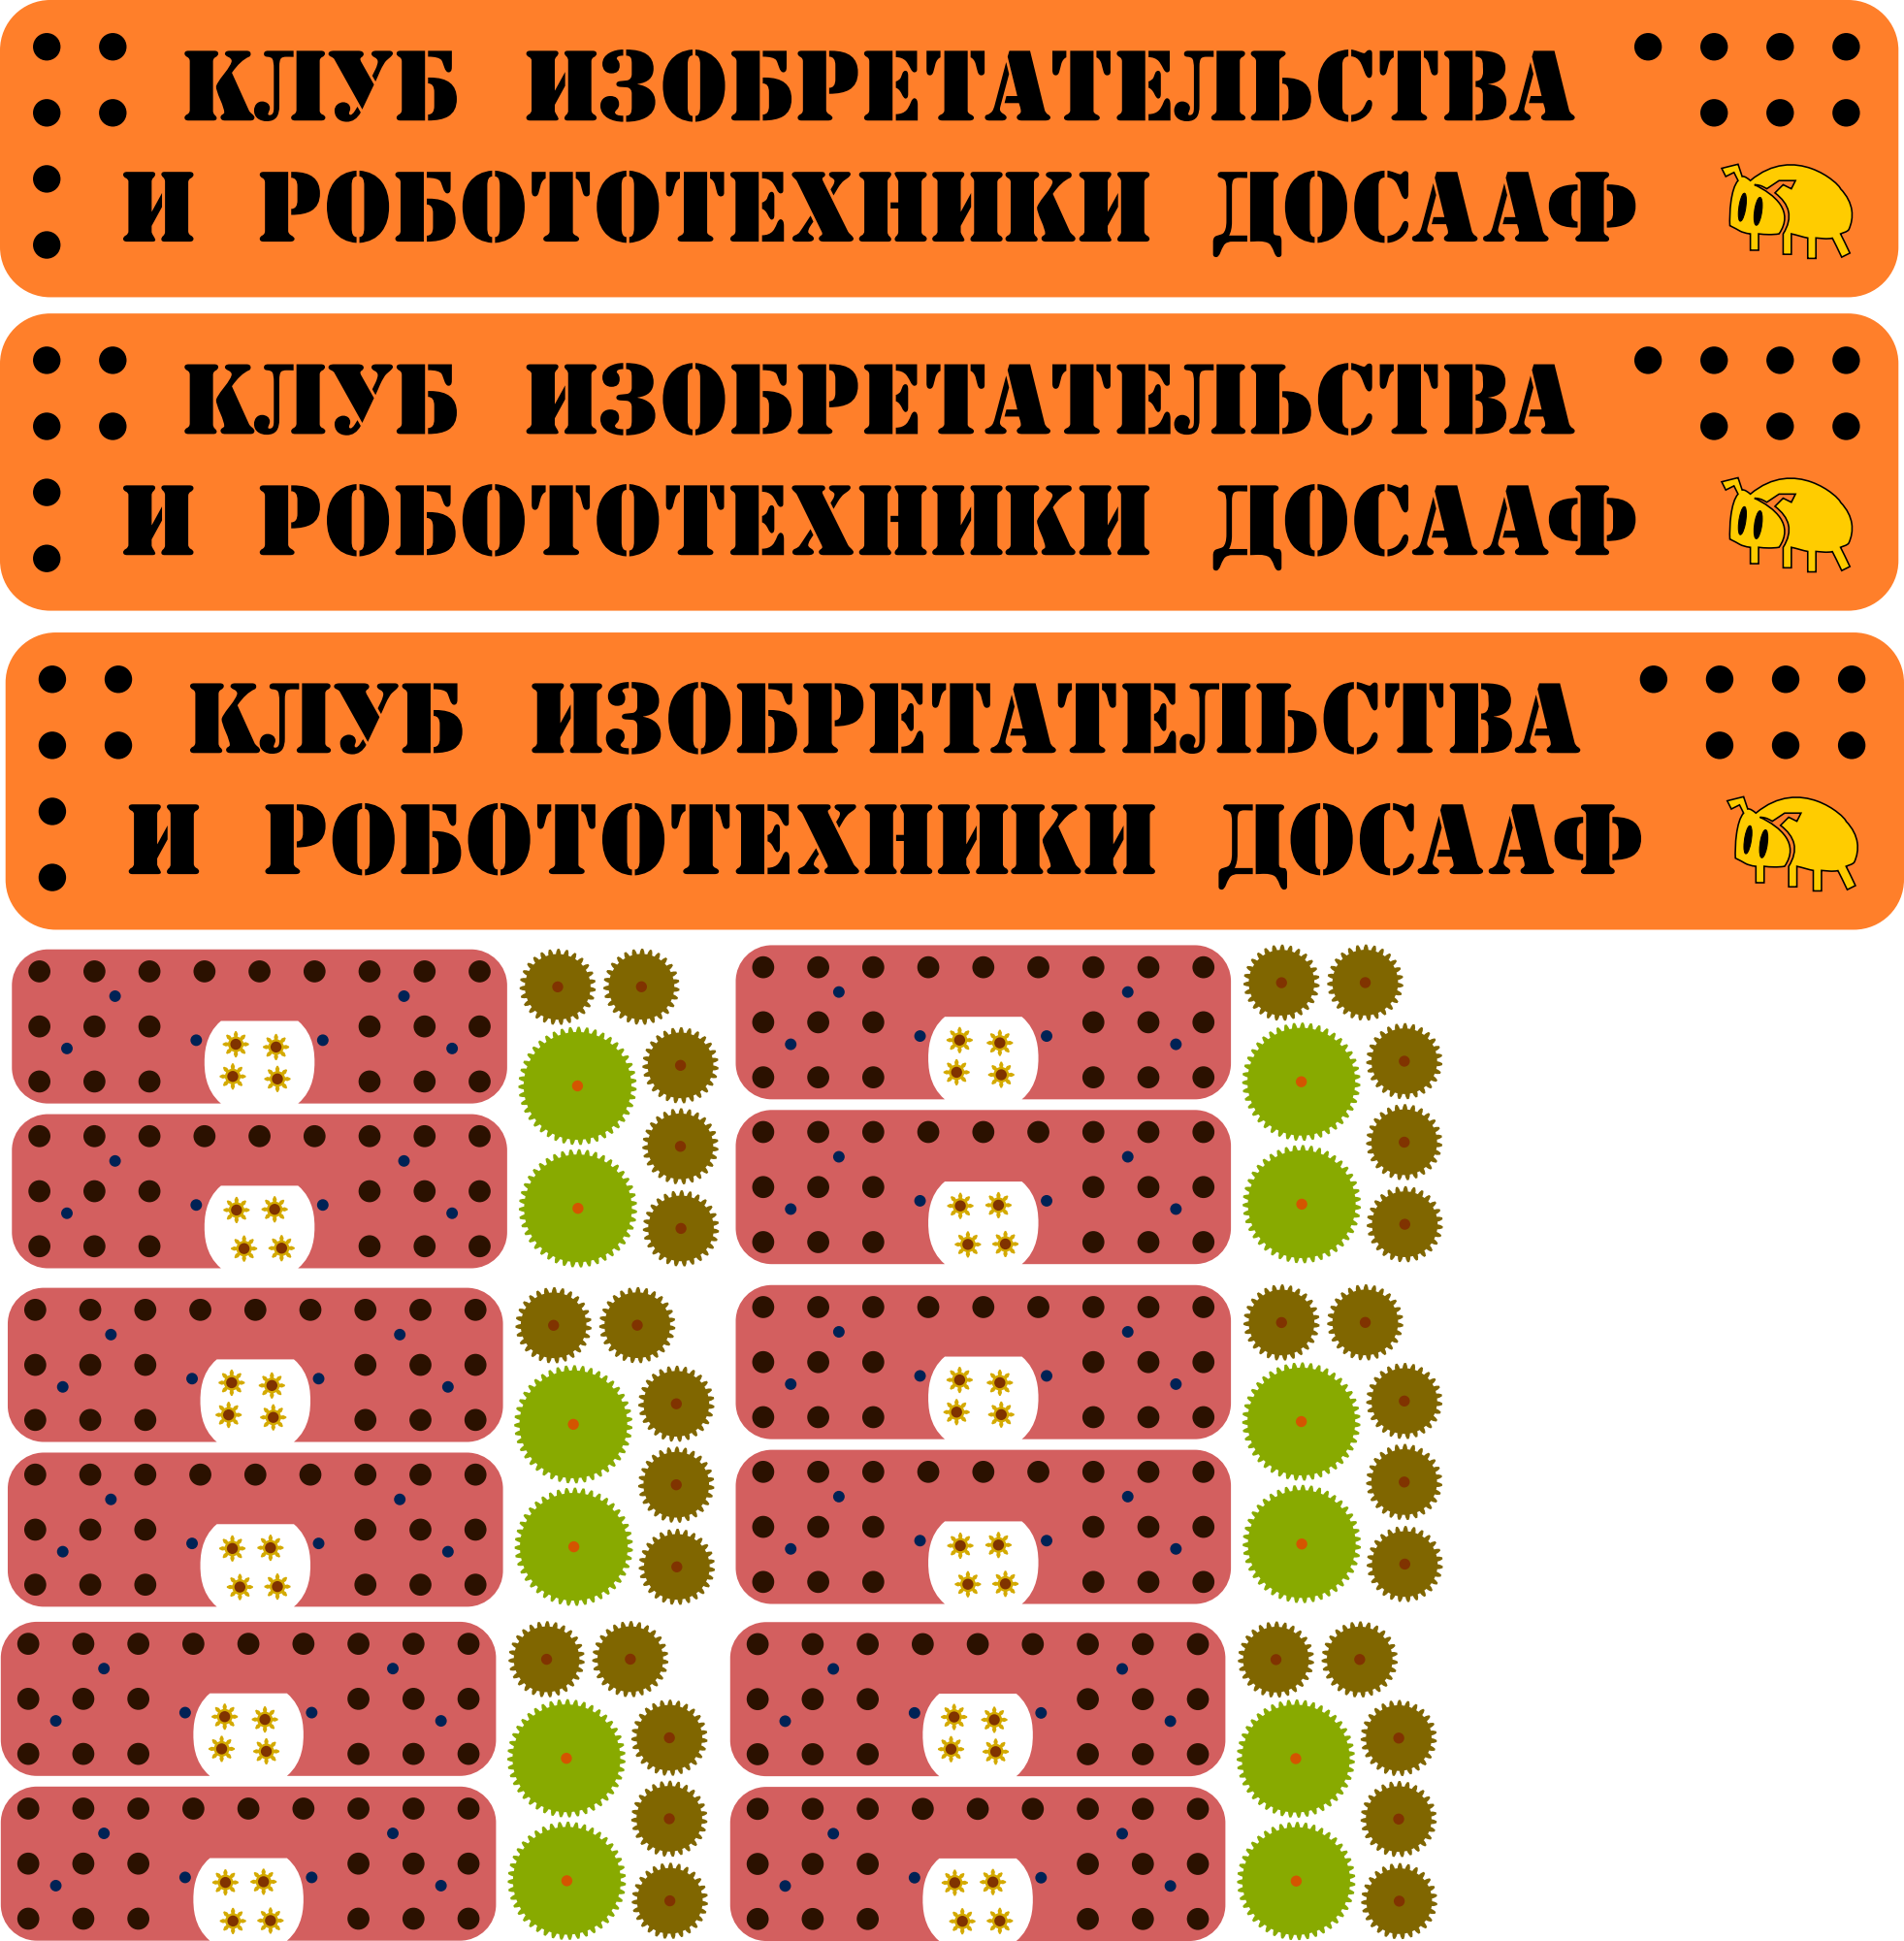
[picture p280: page 1]
