sadr0b0t/metalrobot/manufacturing/партия4 - лазер пластик - Робот Машинка и шестерёнки - 21 октября 2014/все детали.pdf

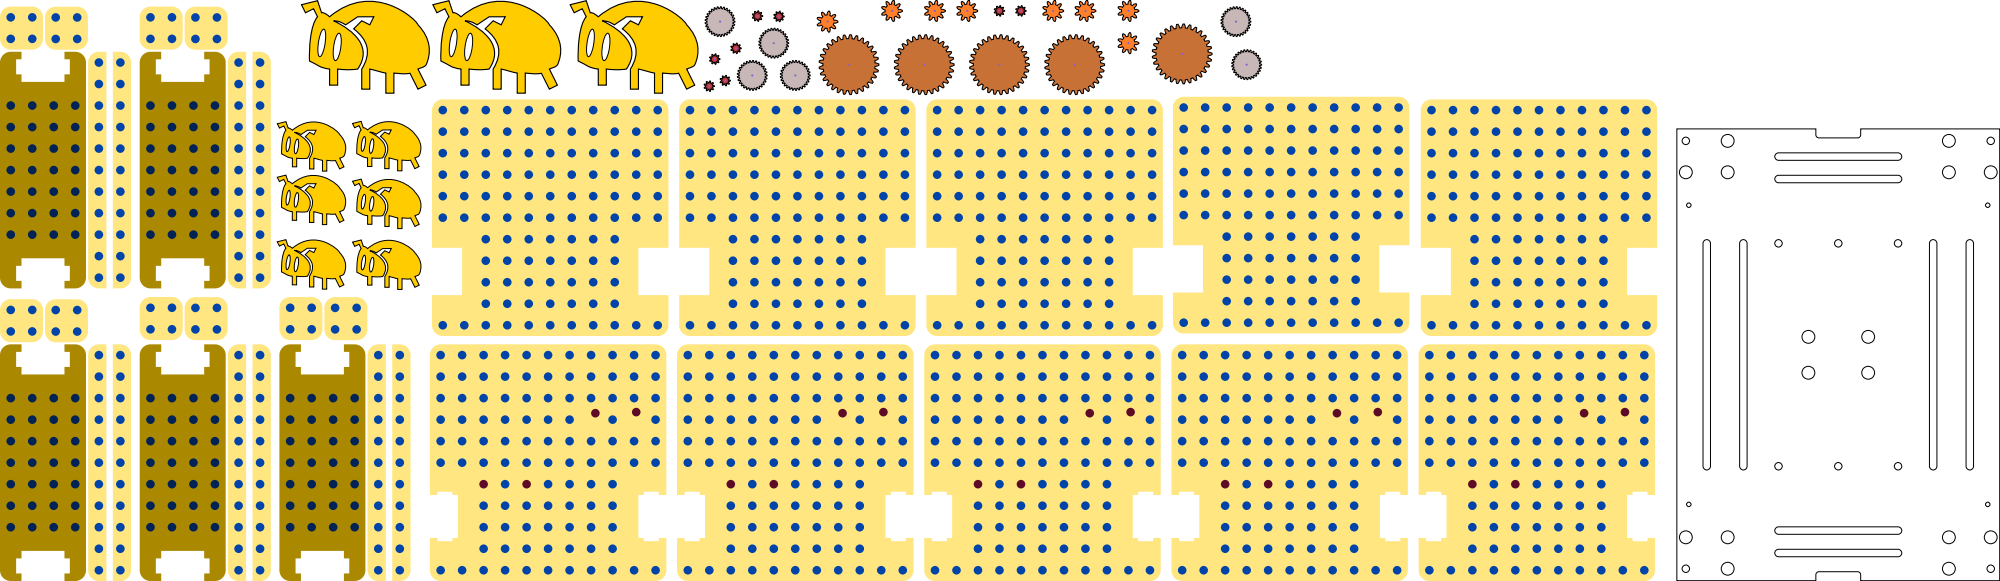
[picture p281: page 1]
