sadr0b0t/metalrobot/manufacturing/партия3 - лазер пластик - 7 сентября 2014/все детали.pdf

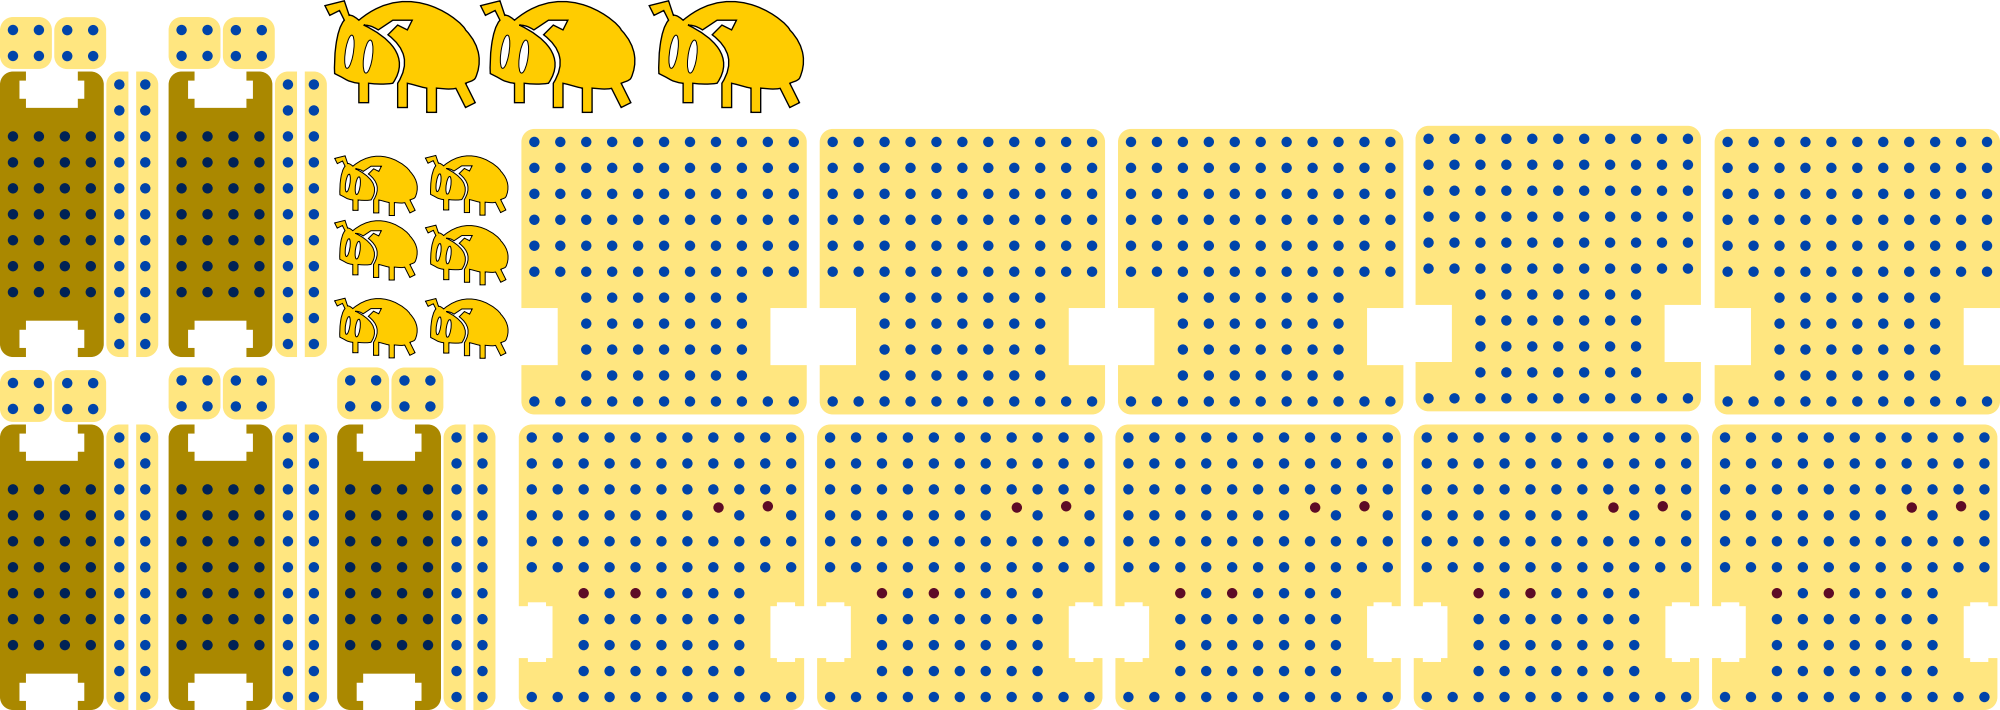
[picture p282: page 1]
