sadr0b0t/metalrobot/parts/export/all_details.pdf

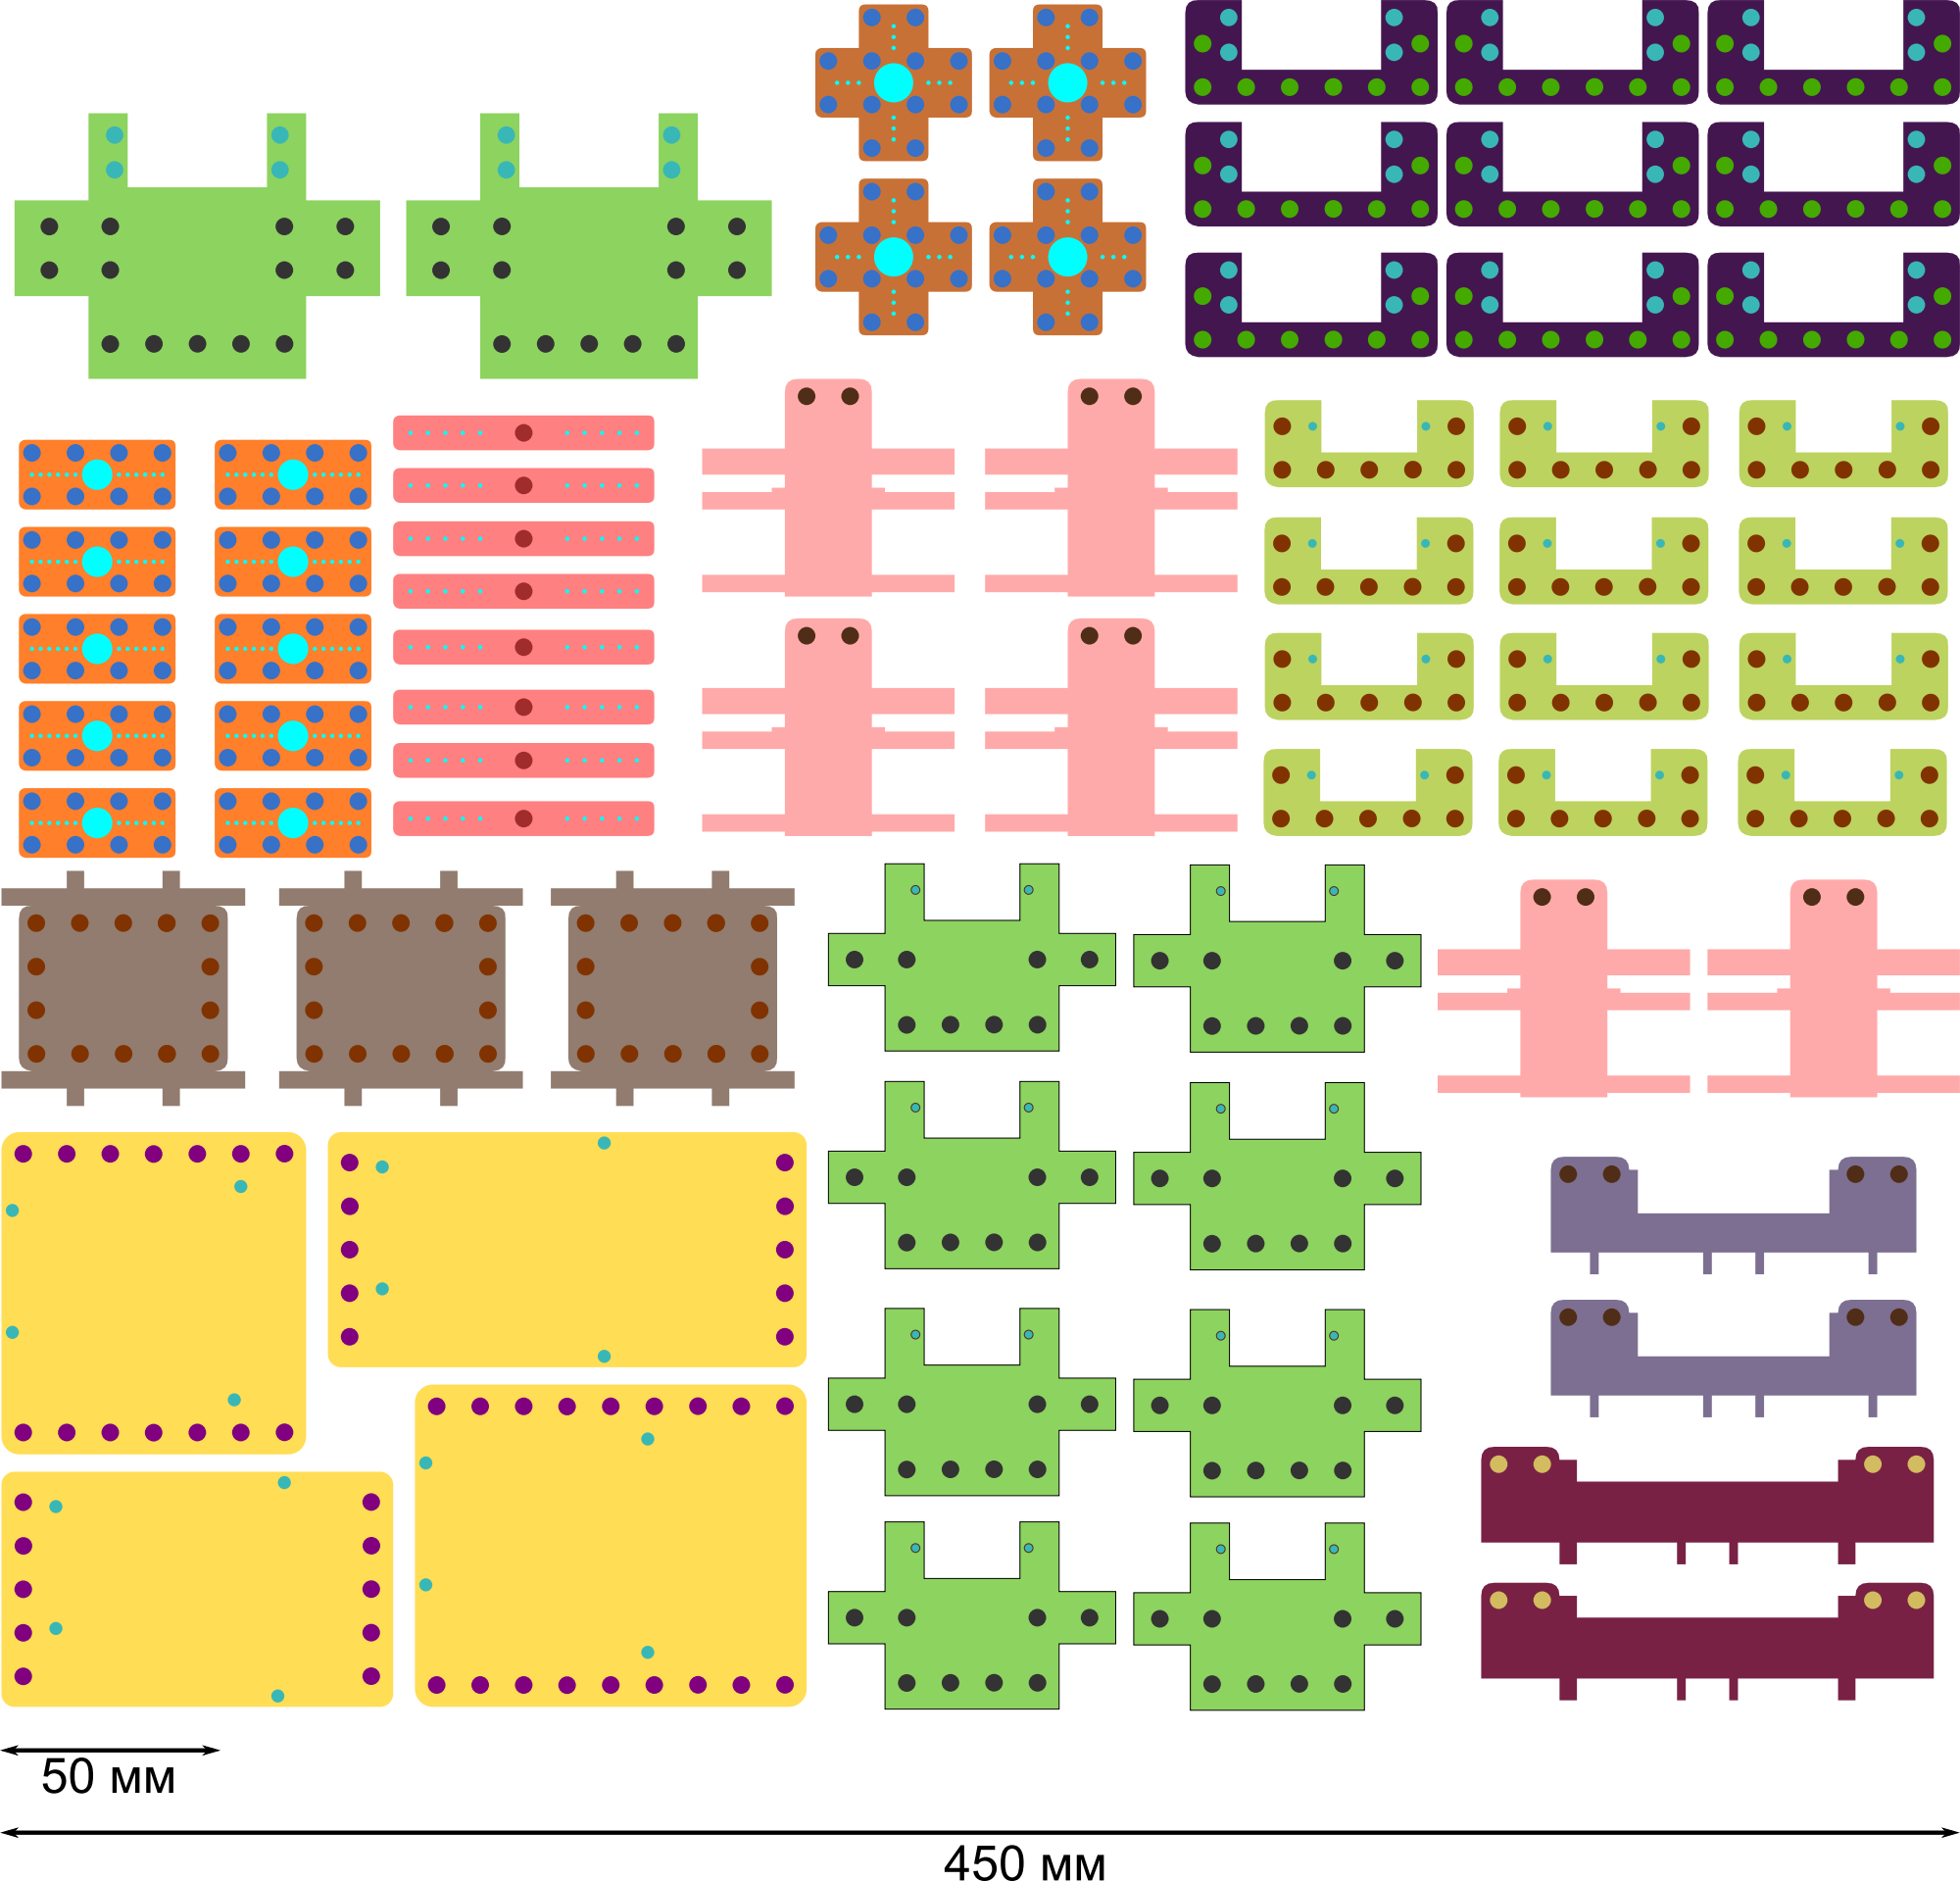
[picture p283: page 1]
