sadr0b0t/metalrobot/manufacturing/партия12/корпус-резка/машинка-корпус.pdf

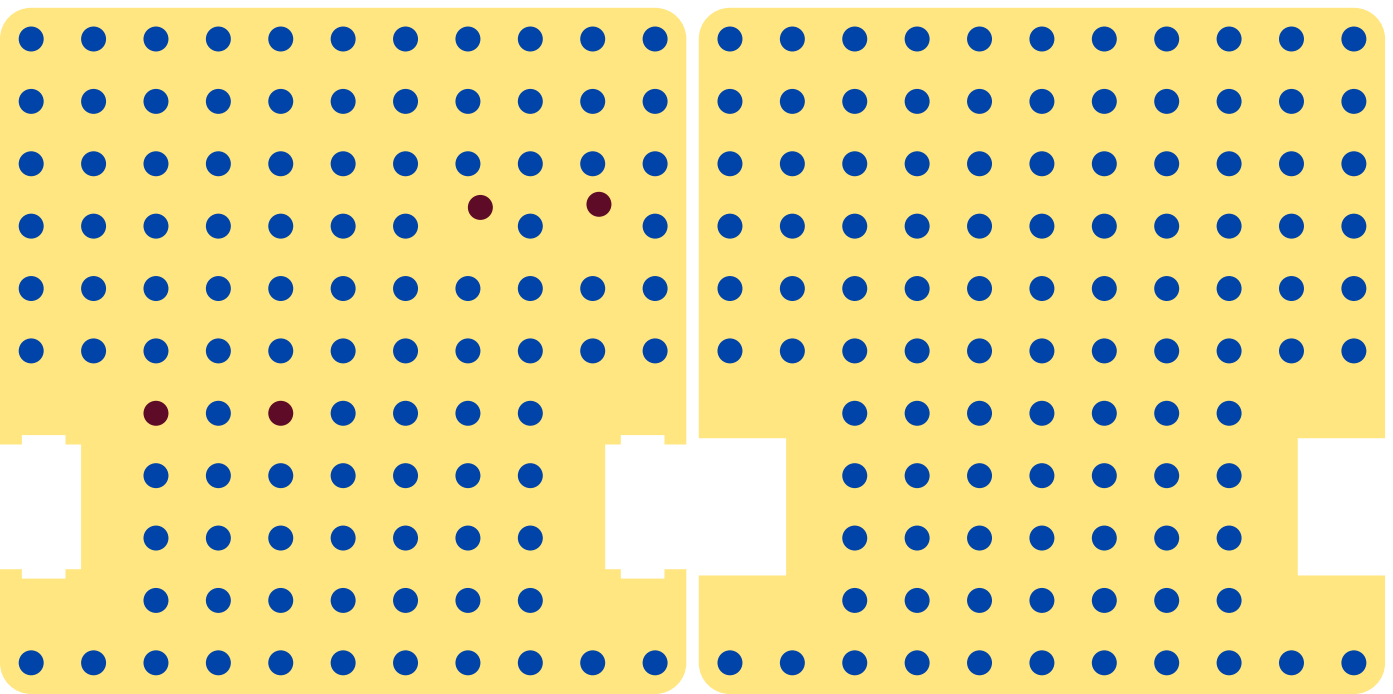
[picture p284: page 1]
