sadr0b0t/metalrobot/Robot Car/коробка/export/design1-разворот.pdf

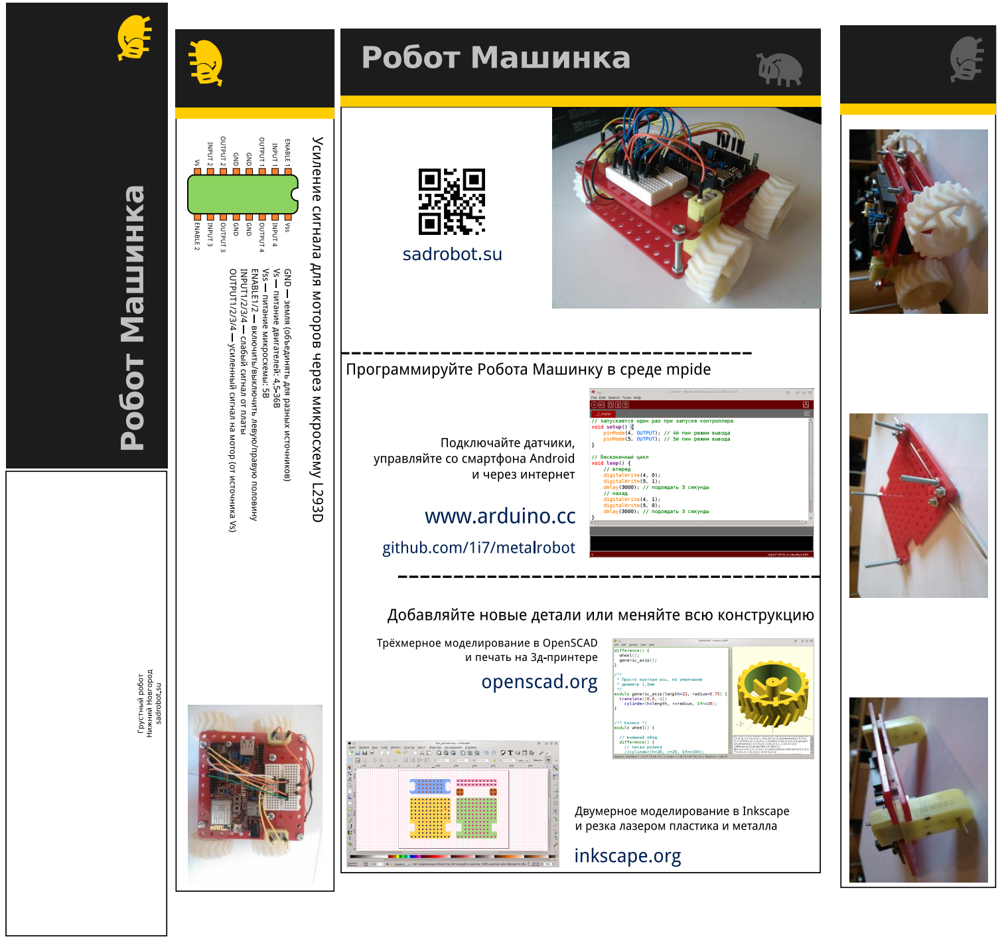
[picture p285: page 1]
