sadr0b0t/metalrobot/Robot Car/трассы/export/трасса-роботрафик.pdf

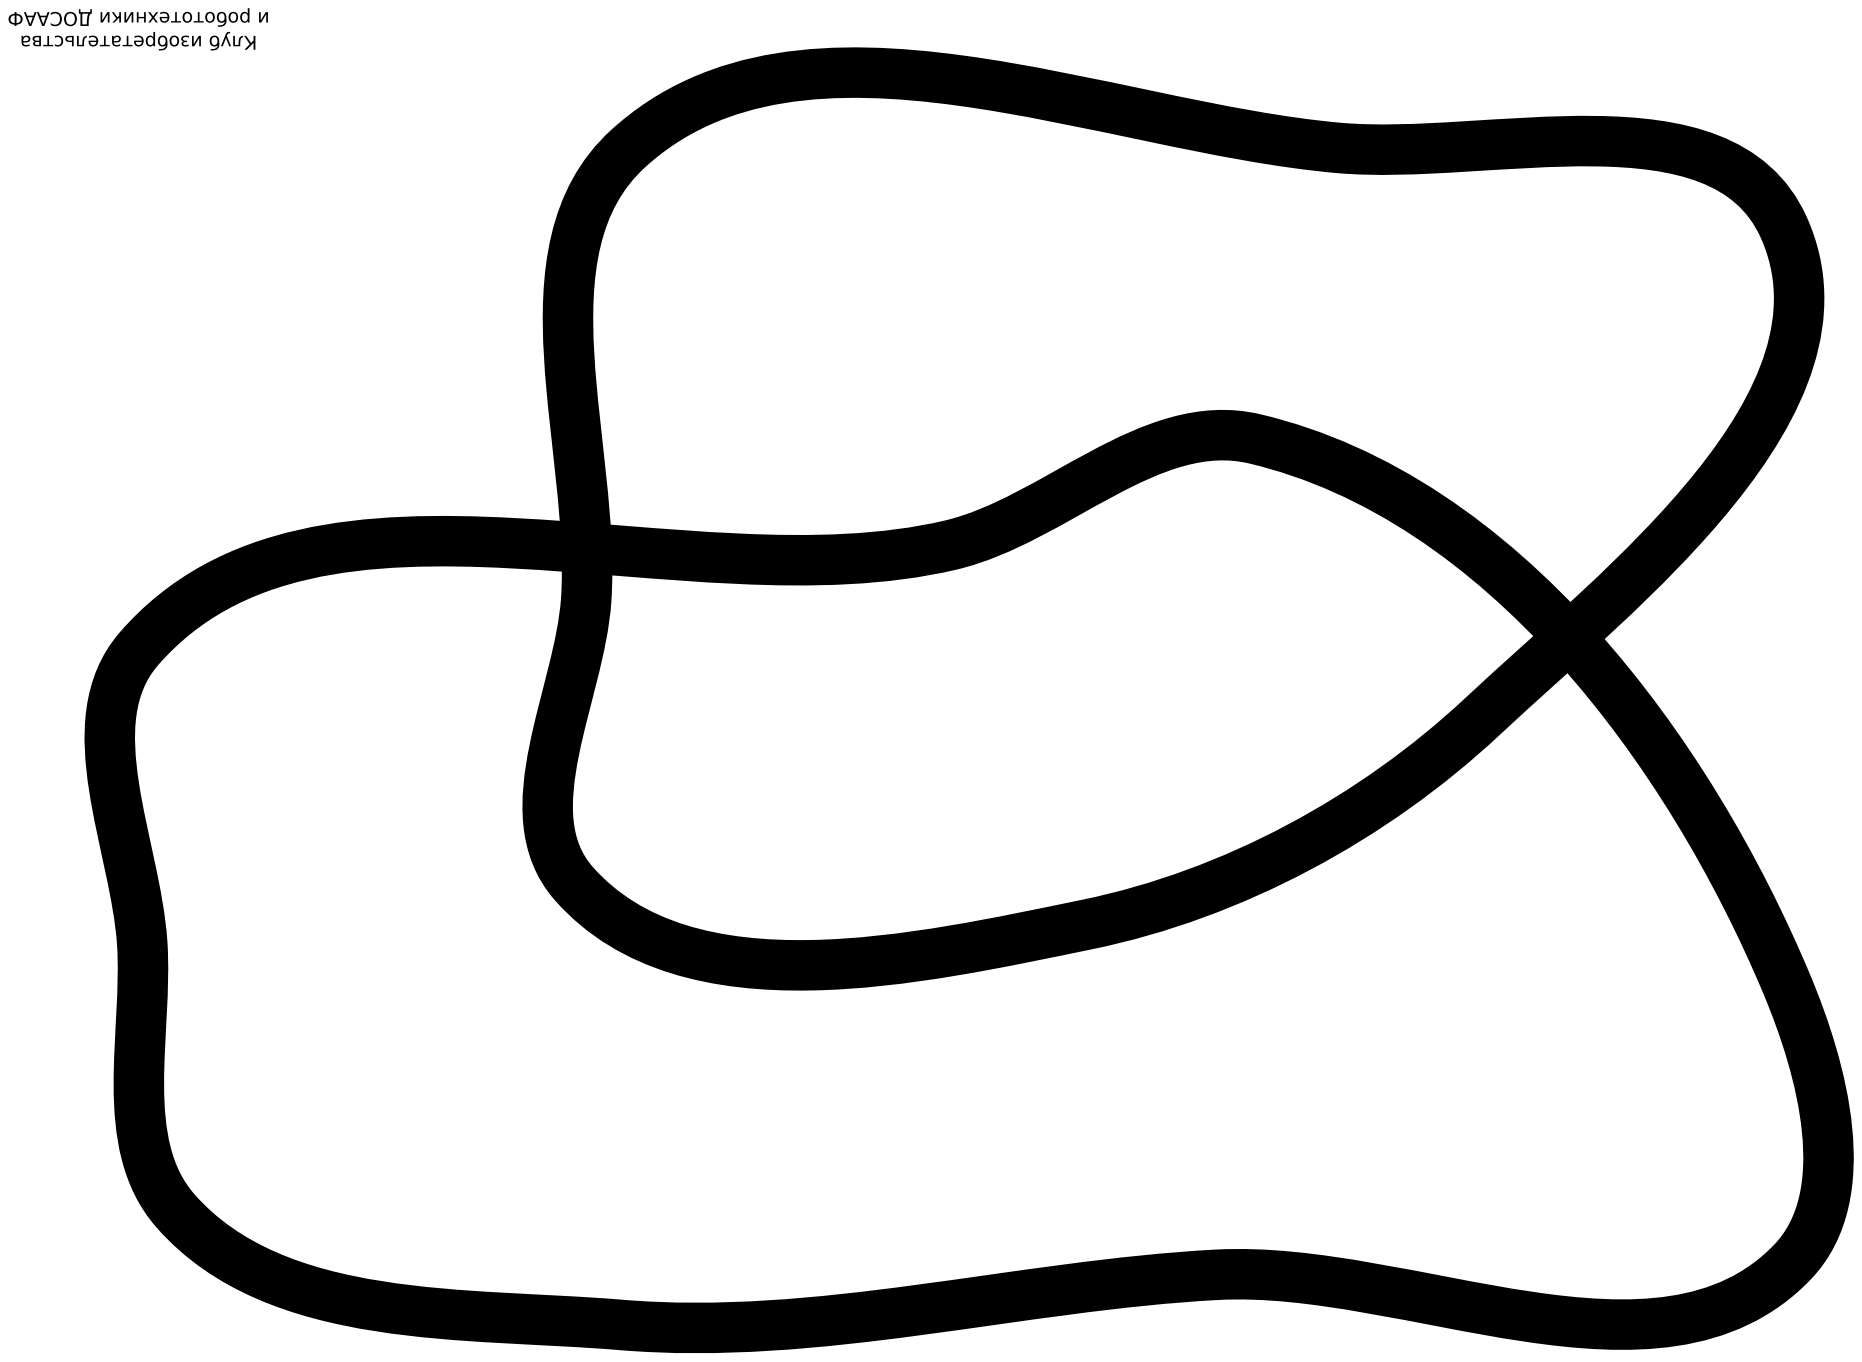
[picture p286: page 1]
