sadr0b0t/metalrobot/Robot Car/трассы/export/трасса-роботрафик2.pdf

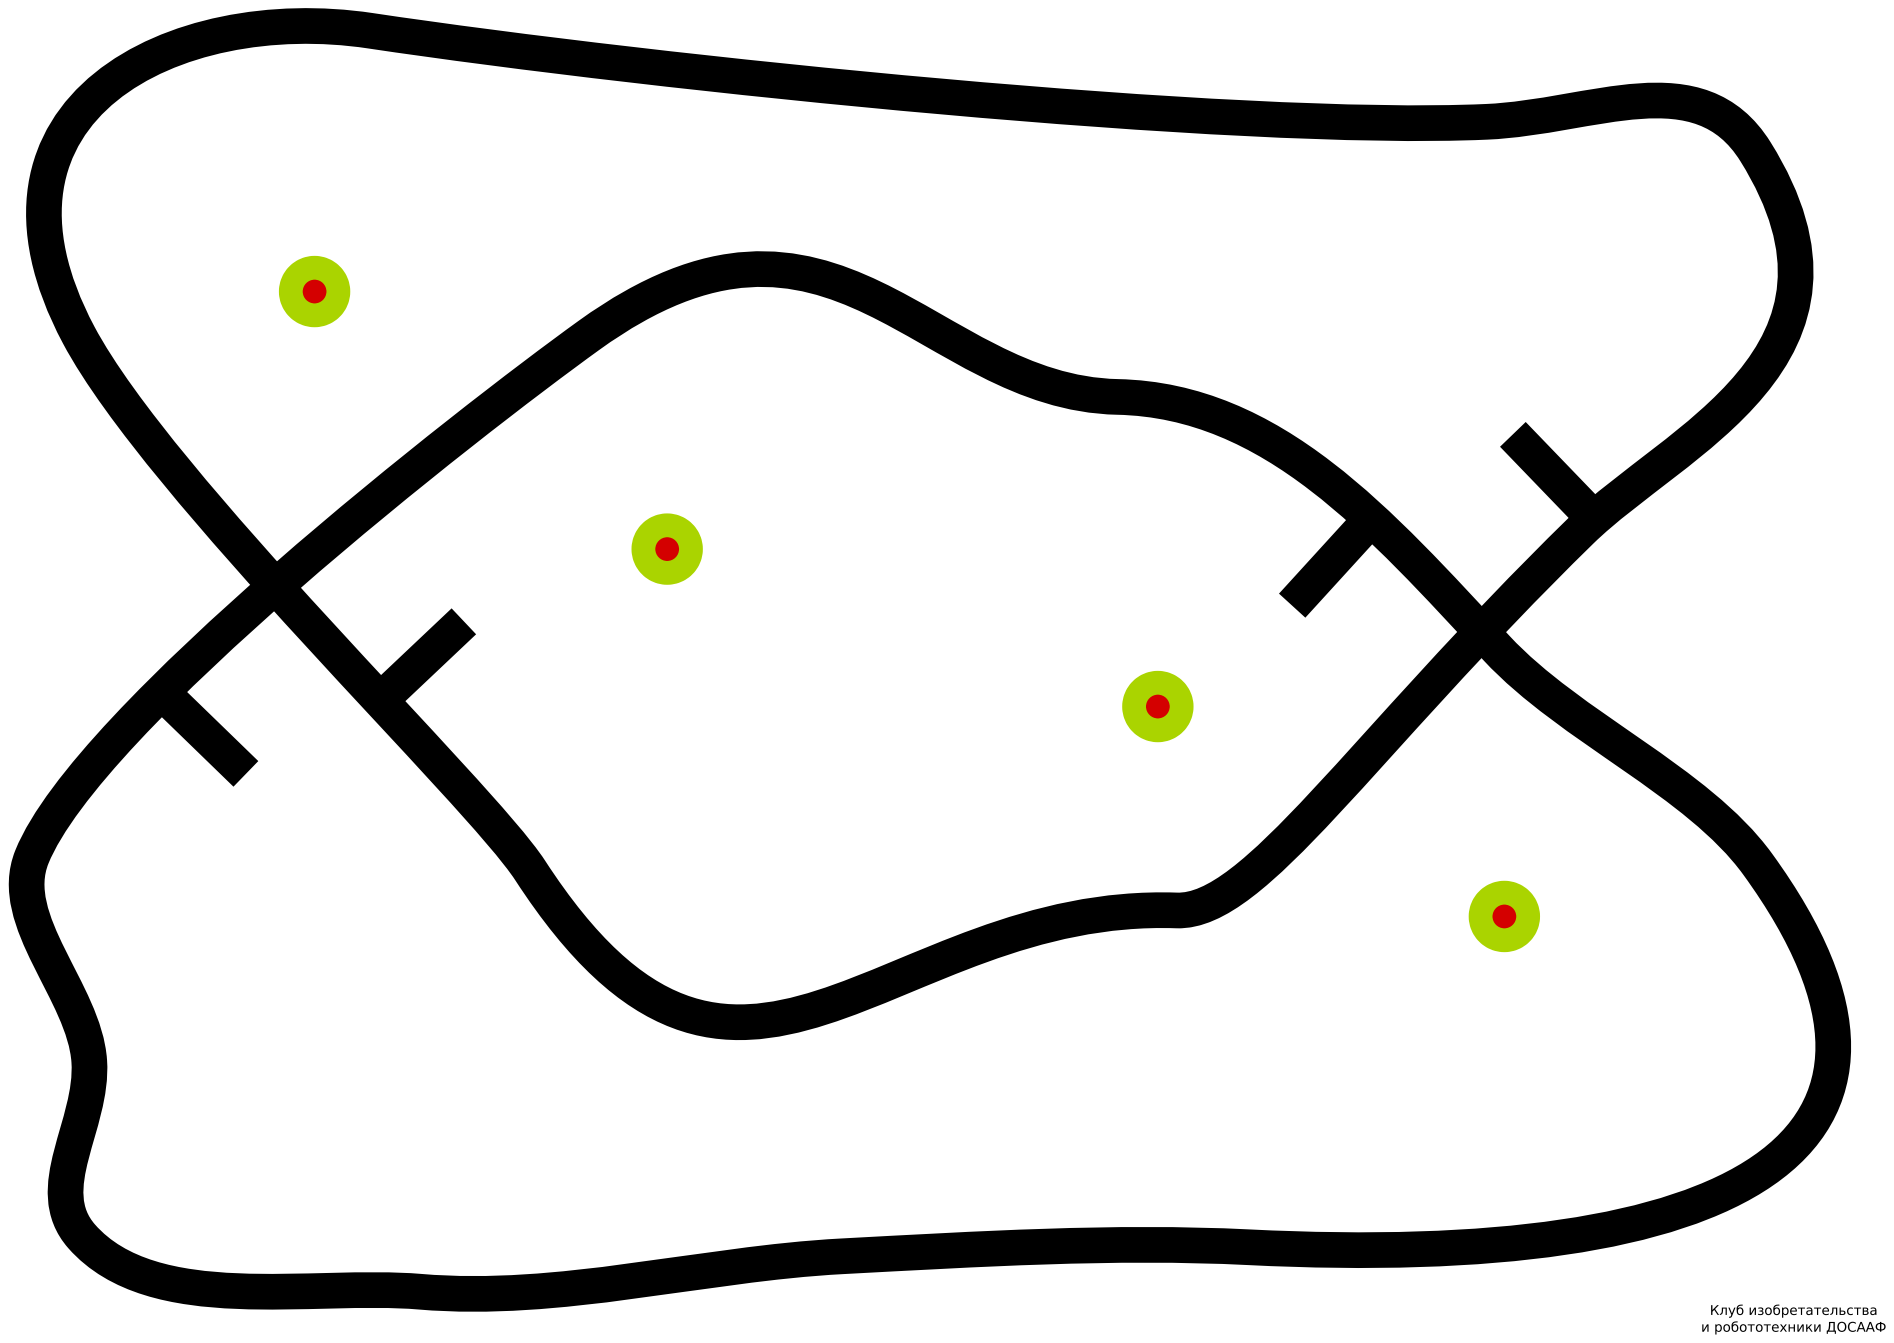
[picture p287: page 1]
