sadr0b0t/metalrobot/Robot Car/корпус/export/все_детали.pdf

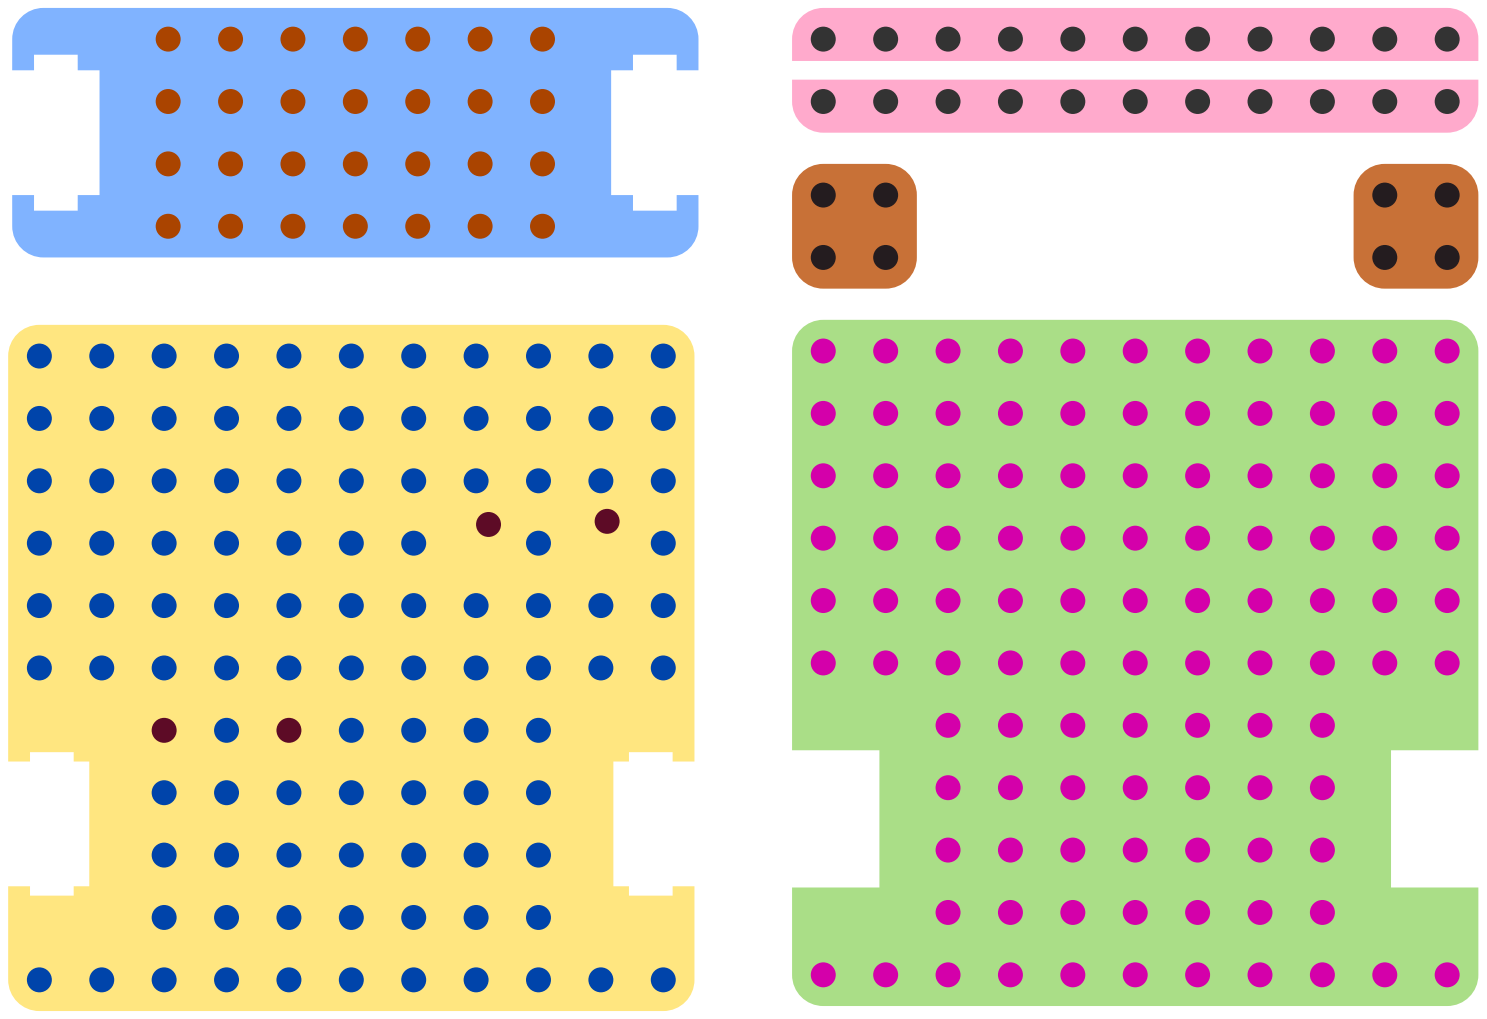
[picture p288: page 1]
