sadr0b0t/metalrobot/doc/robotcar-model2-инструкция-провода/instr-pages-portrait/export-pdf/00-info.pdf

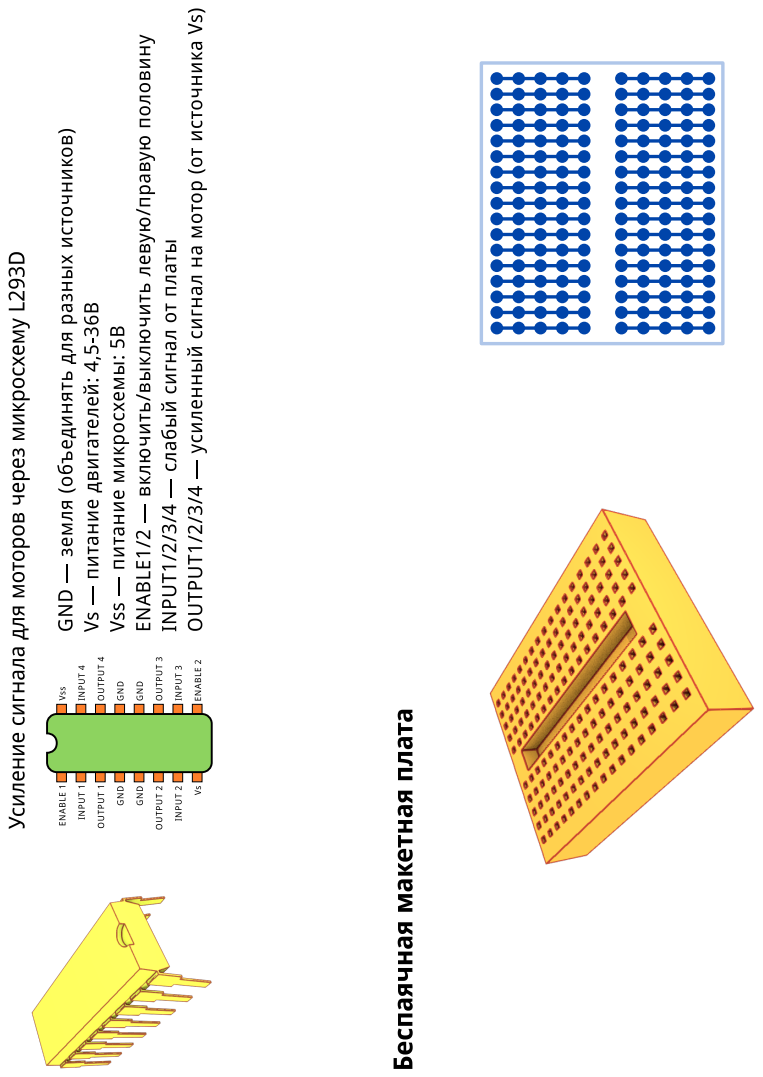
[picture p289: page 1]
