sadr0b0t/metalrobot/doc/robotcar-model2-инструкция-провода/instr-pages-portrait/export-pdf/01-connect-motors.pdf

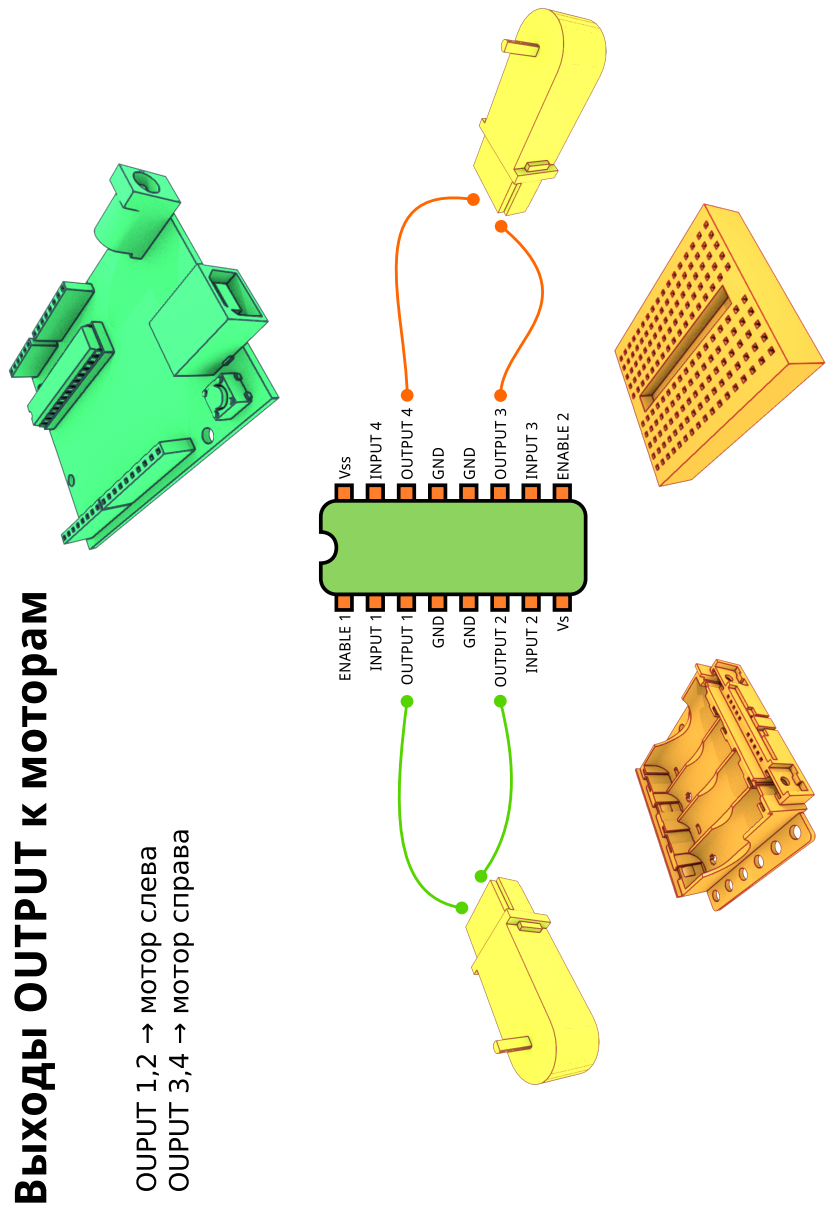
[picture p290: page 1]
