sadr0b0t/metalrobot/doc/robotcar-model2-инструкция-провода/instr-pages-portrait/export-pdf/02-connect-inputs.pdf

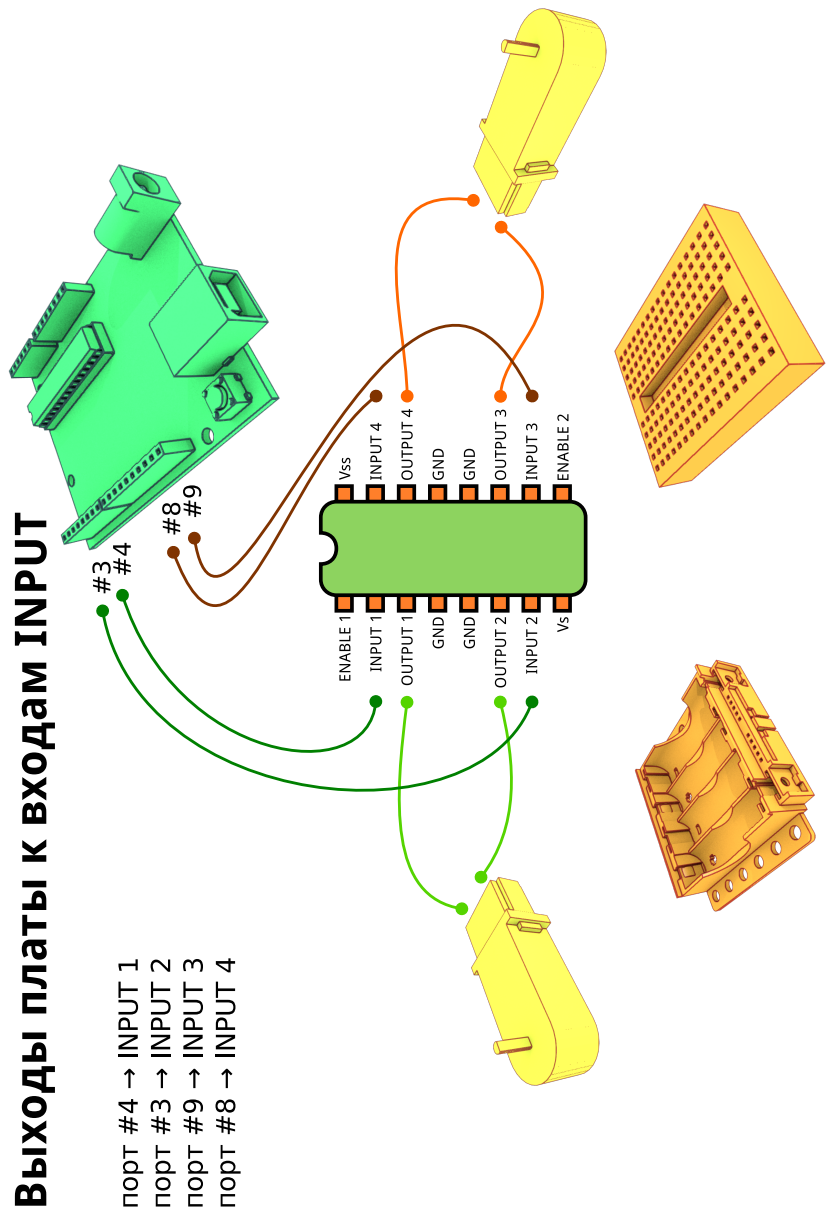
[picture p291: page 1]
