sadr0b0t/metalrobot/doc/robotcar-model2-инструкция-провода/instr-pages-portrait/export-pdf/03-connect-en.pdf

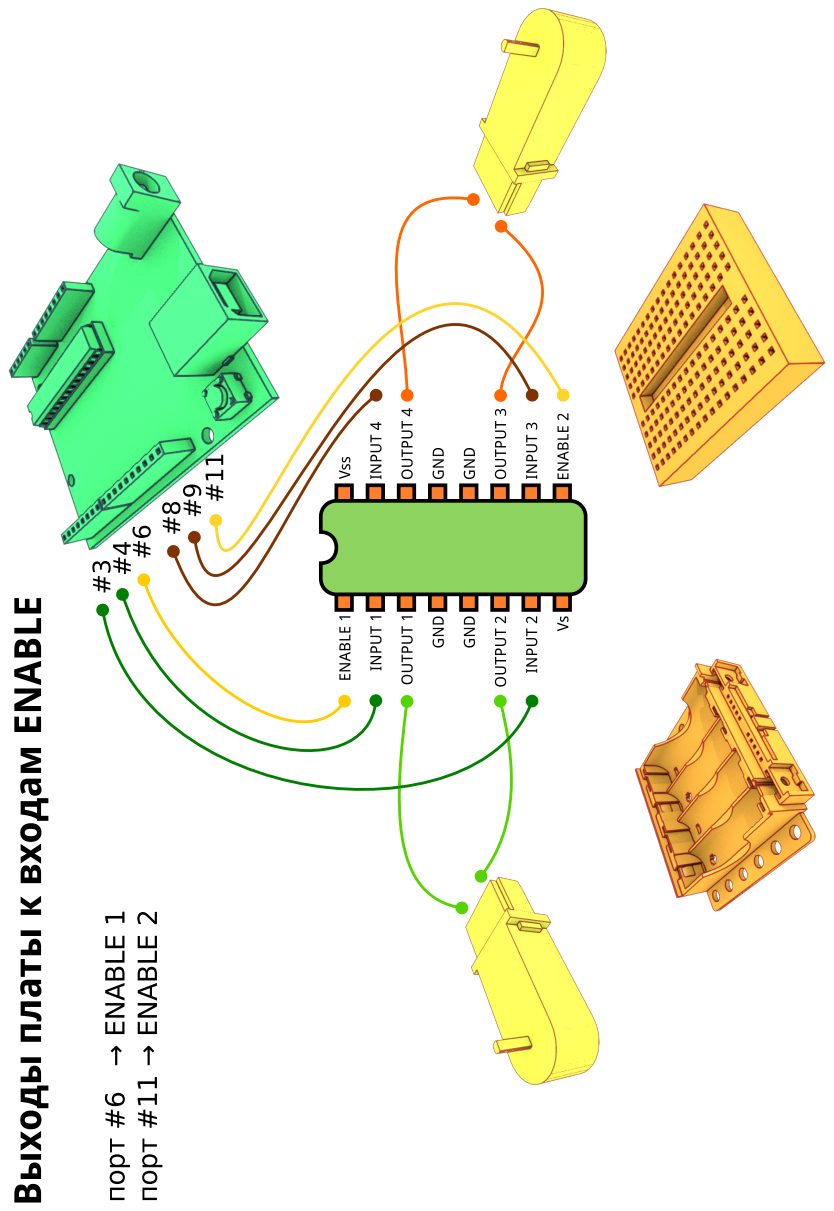
[picture p292: page 1]
