sadr0b0t/metalrobot/doc/robotcar-model2-инструкция-провода/instr-pages-portrait/export-pdf/04-combine-ext-GND.pdf

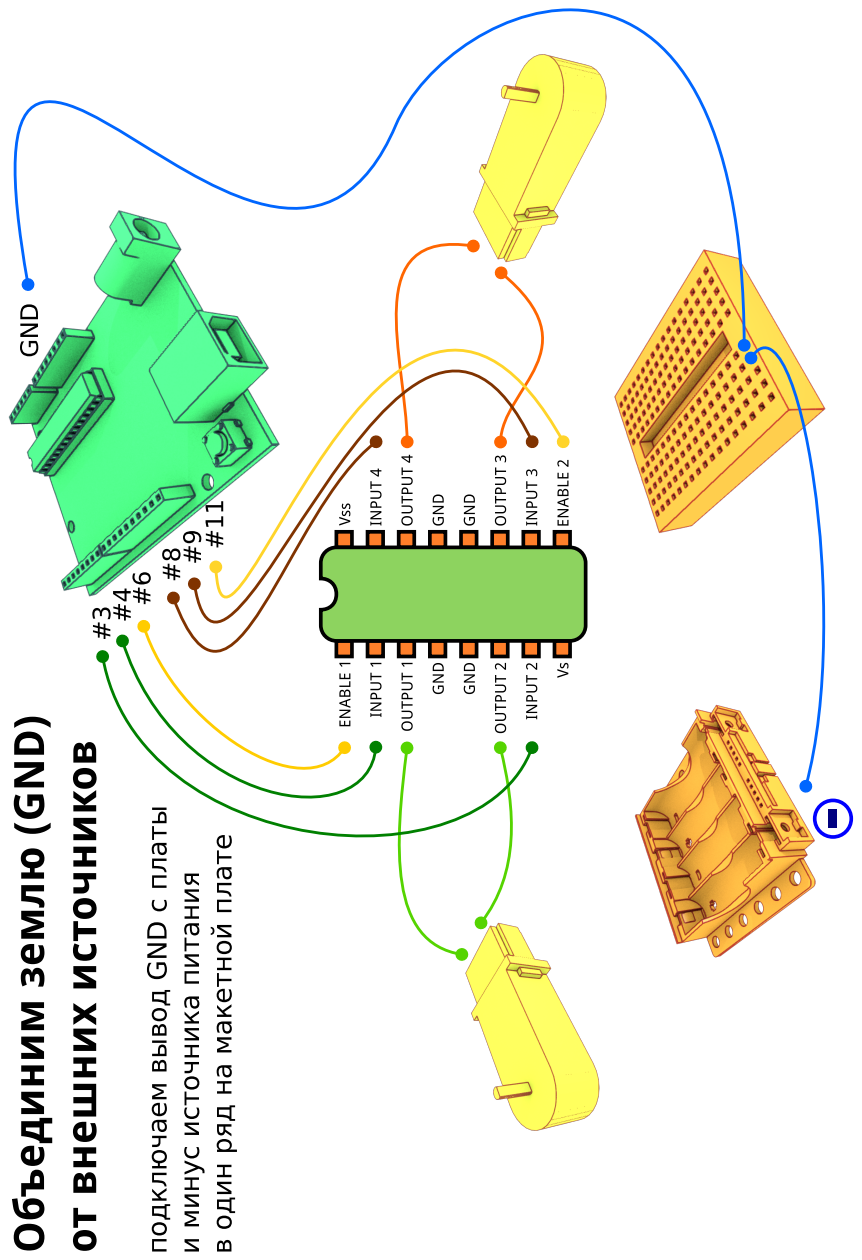
[picture p293: page 1]
