sadr0b0t/metalrobot/doc/robotcar-model2-инструкция-провода/instr-pages-portrait/export-pdf/05-conect-GND.pdf

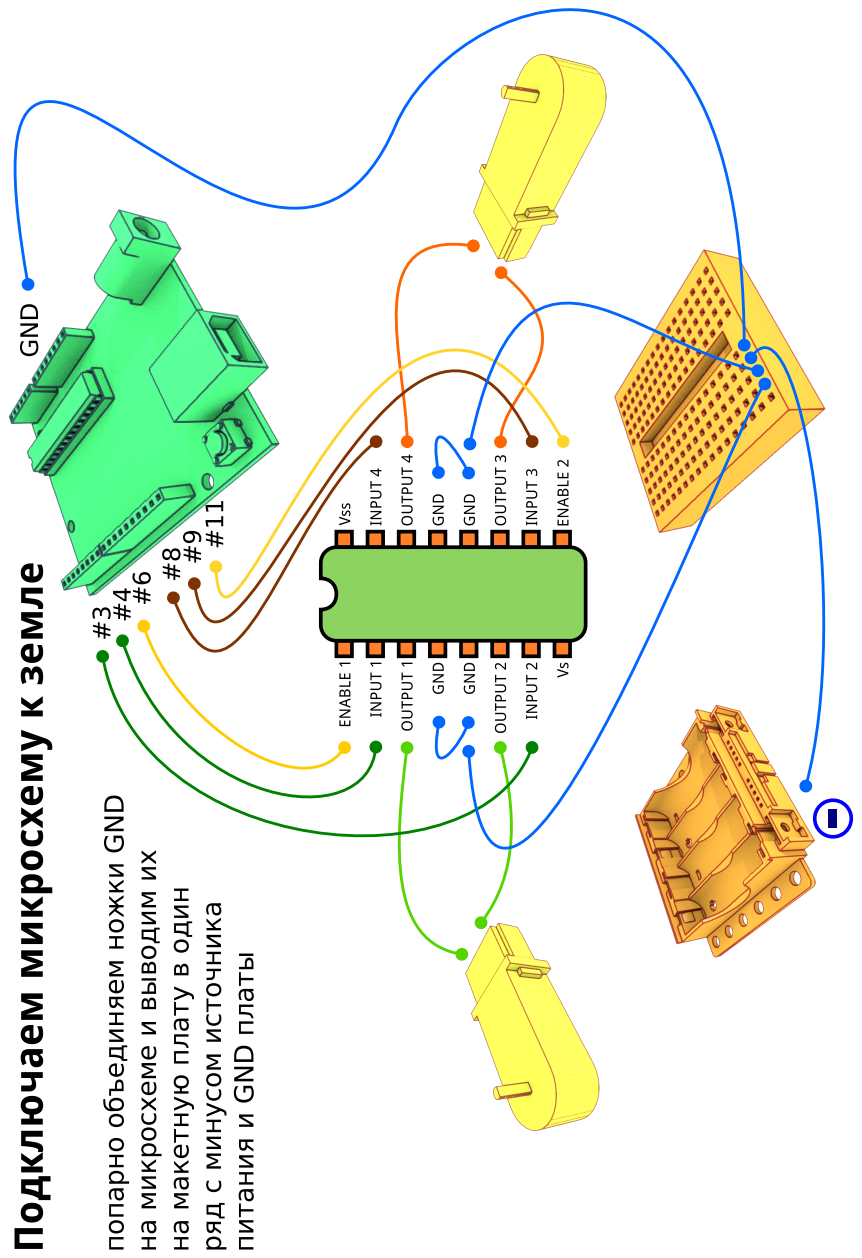
[picture p294: page 1]
