sadr0b0t/metalrobot/doc/robotcar-model2-инструкция-провода/instr-pages-portrait/export-pdf/06-connect-VSS.pdf

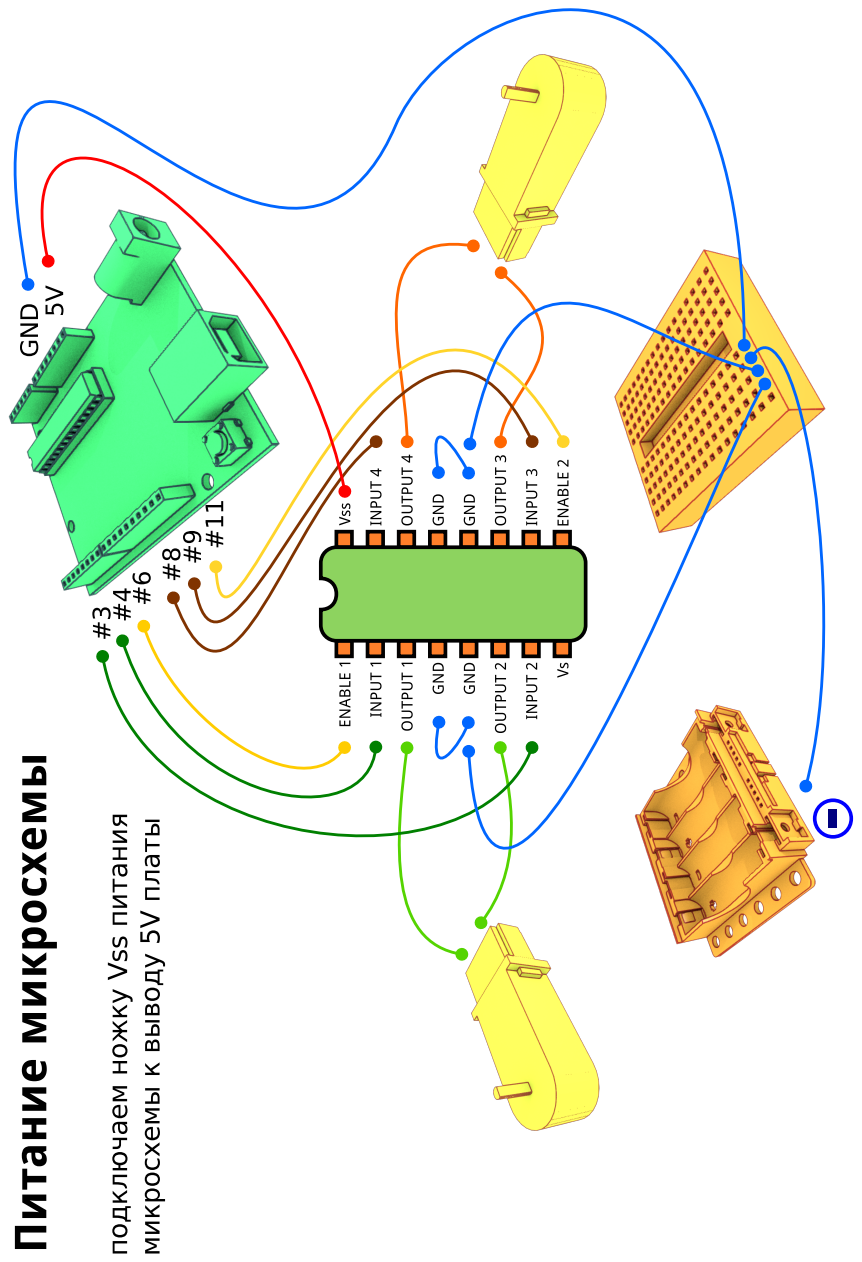
[picture p295: page 1]
