sadr0b0t/metalrobot/doc/robotcar-model2-инструкция-провода/instr-pages-portrait/export-pdf/07-connect-VS.pdf

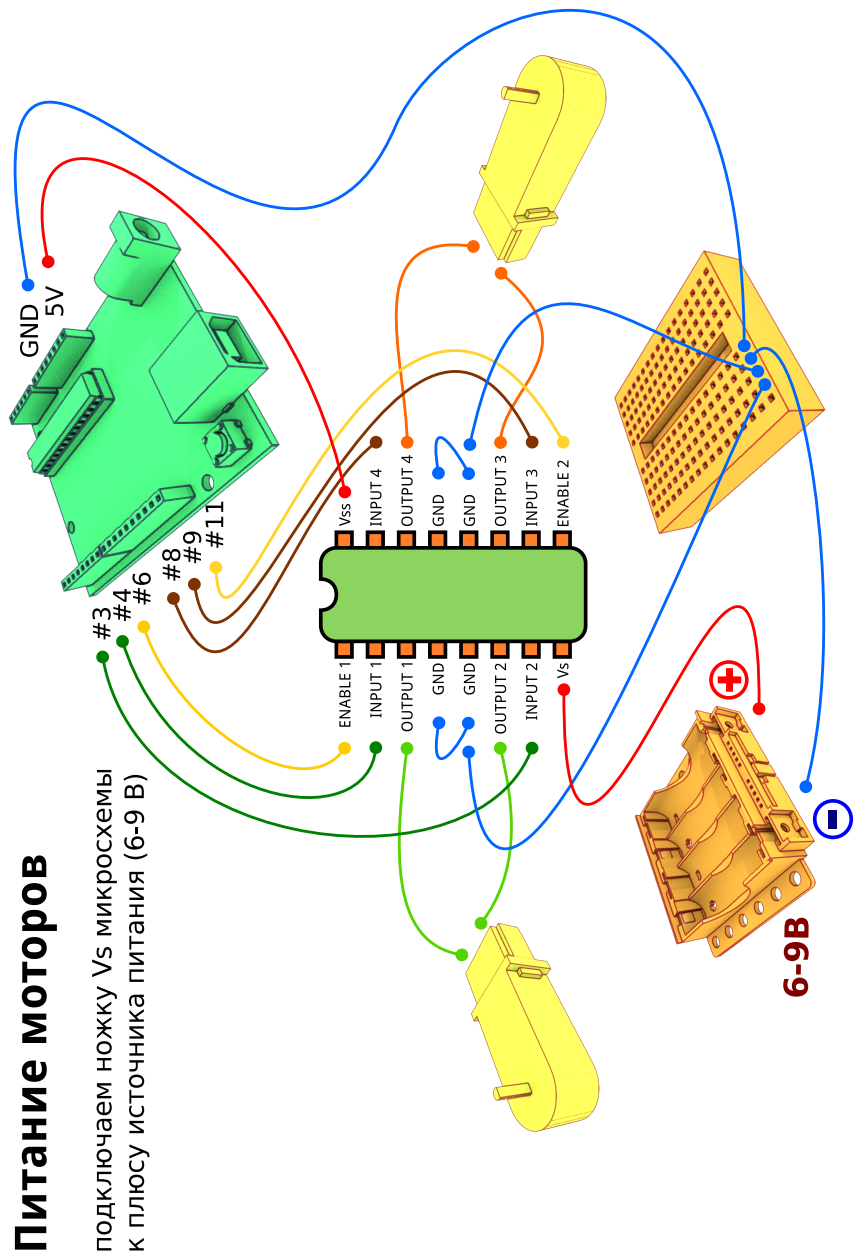
[picture p296: page 1]
