sadr0b0t/metalrobot/doc/robotcar-model2-инструкция-провода/instr-pages/export-pdf/00-info.pdf

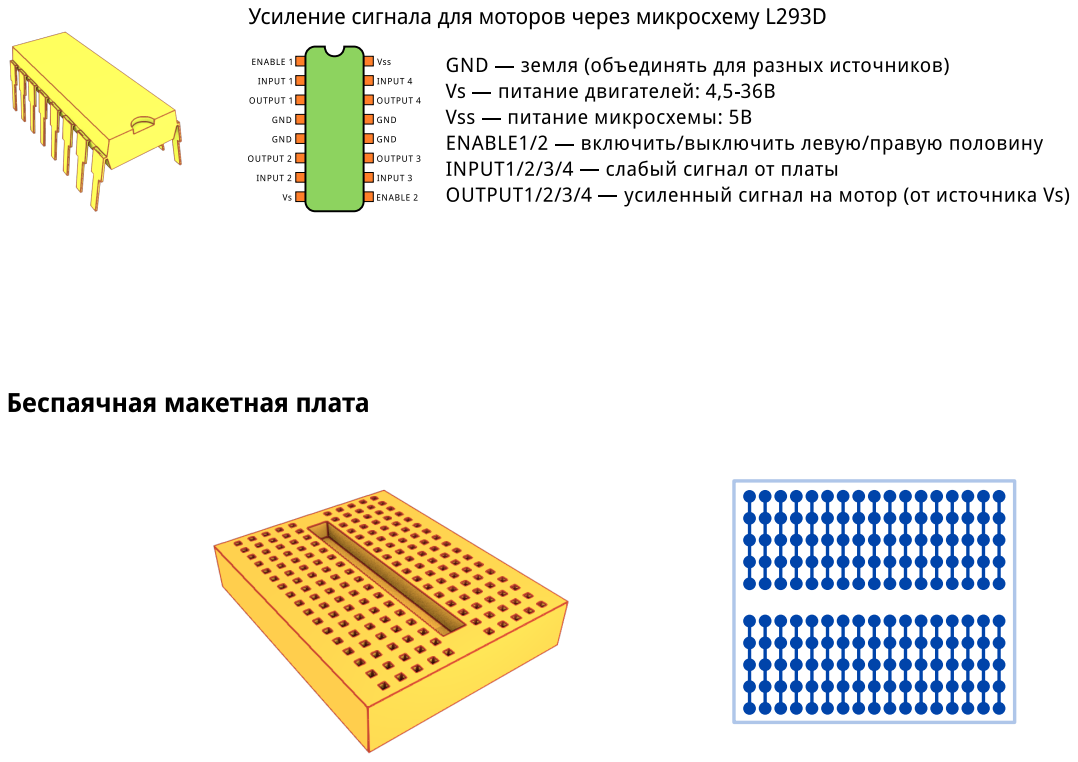
[picture p297: page 1]
