sadr0b0t/metalrobot/doc/robotcar-model2-инструкция-провода/instr-pages/export-pdf/01-connect-motors.pdf

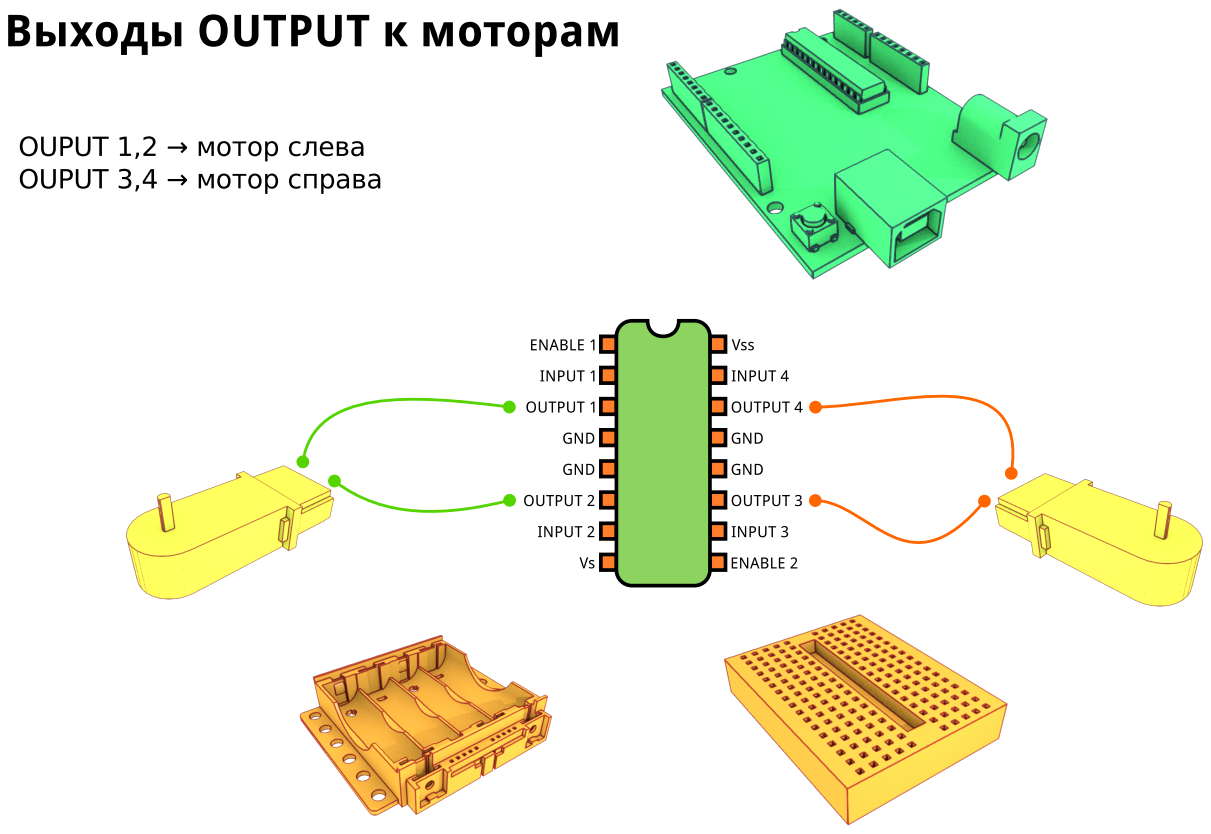
[picture p298: page 1]
