sadr0b0t/metalrobot/doc/robotcar-model2-инструкция-провода/instr-pages/export-pdf/02-connect-inputs.pdf

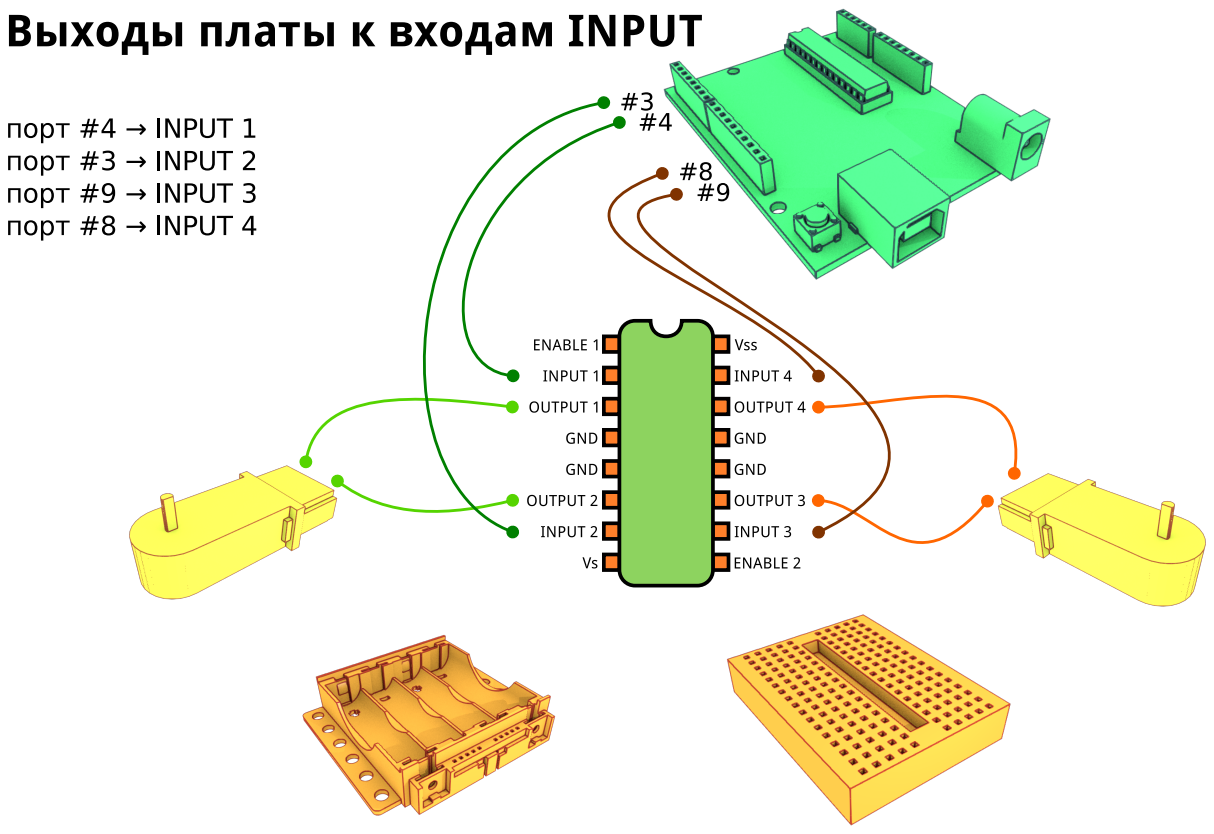
[picture p299: page 1]
