sadr0b0t/metalrobot/doc/robotcar-model2-инструкция-провода/instr-pages/export-pdf/03-connect-en.pdf

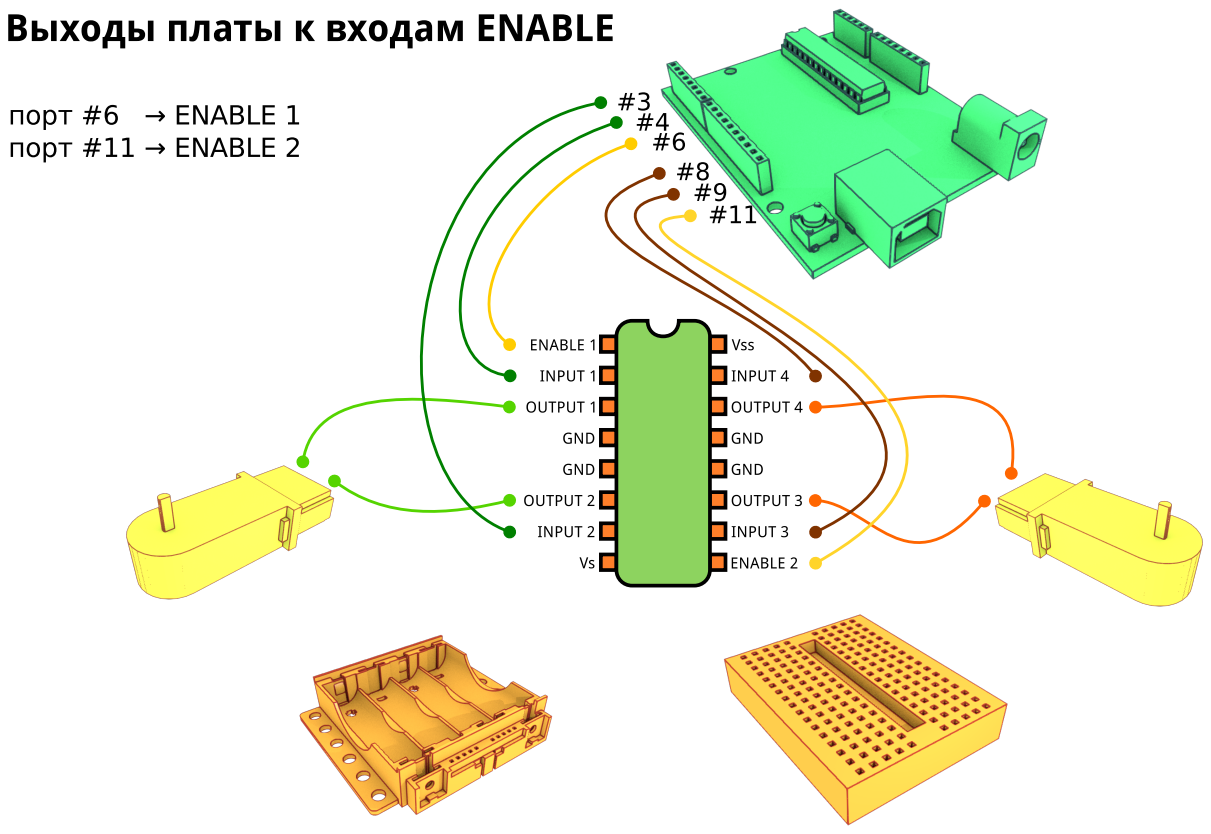
[picture p300: page 1]
