sadr0b0t/metalrobot/doc/robotcar-model2-инструкция-провода/instr-pages/export-pdf/04-combine-ext-GND.pdf

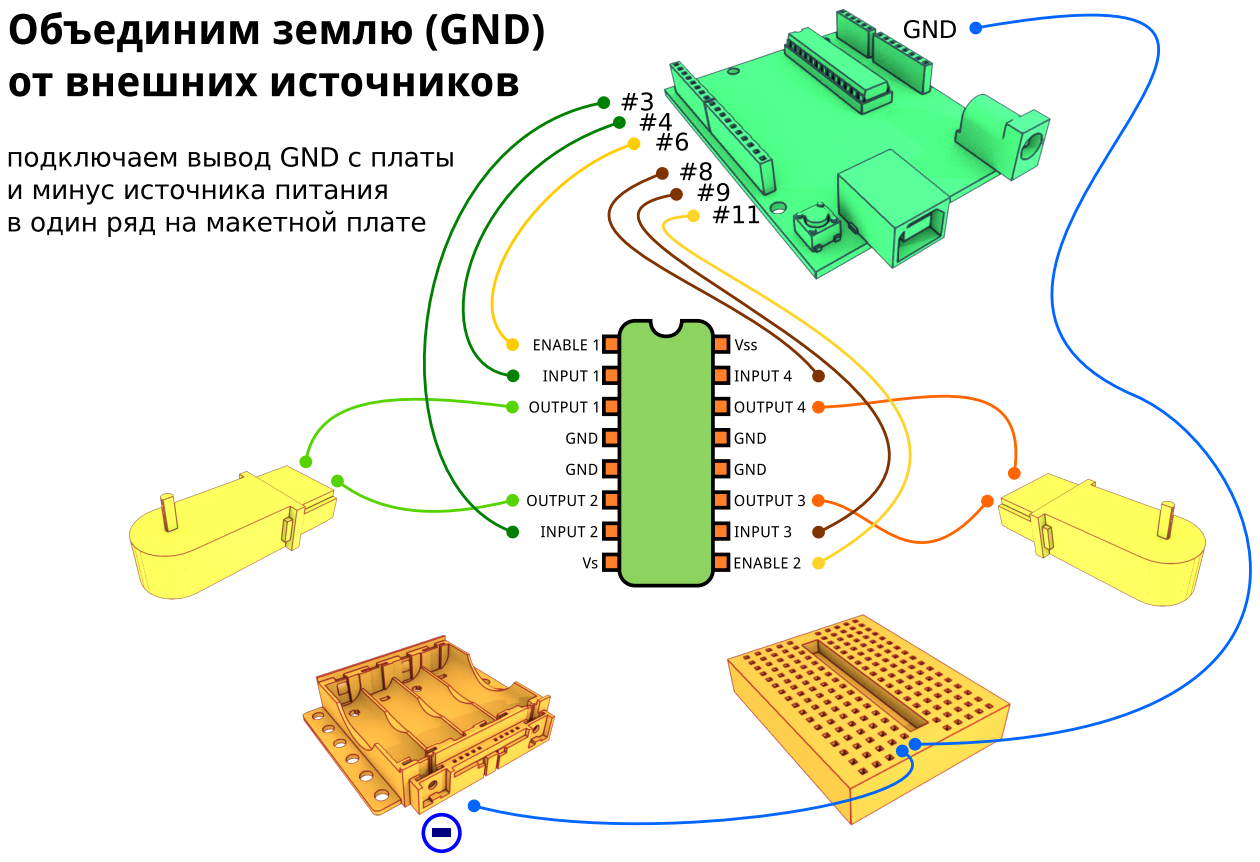
[picture p301: page 1]
