sadr0b0t/metalrobot/doc/robotcar-model2-инструкция-провода/instr-pages/export-pdf/05-conect-GND.pdf

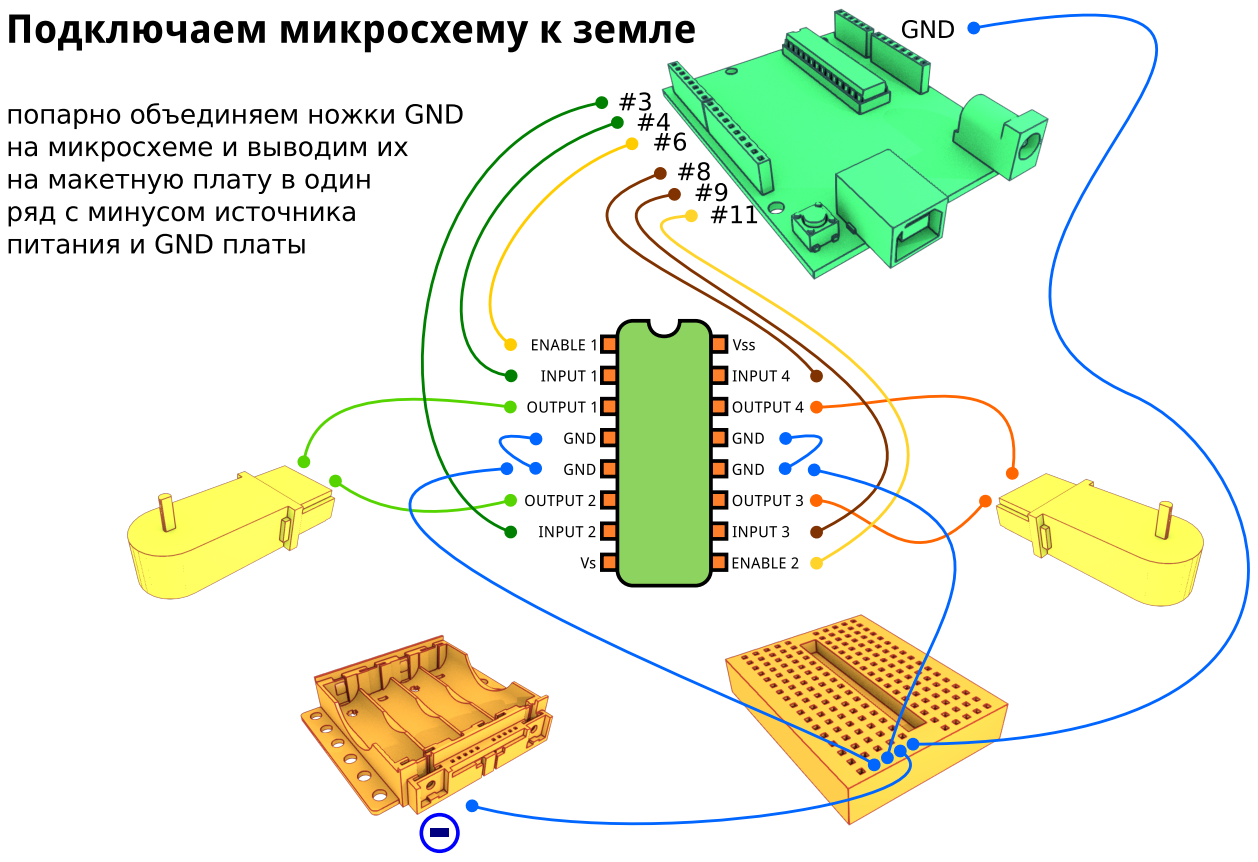
[picture p302: page 1]
