sadr0b0t/metalrobot/doc/robotcar-model2-инструкция-провода/instr-pages/export-pdf/06-connect-VSS.pdf

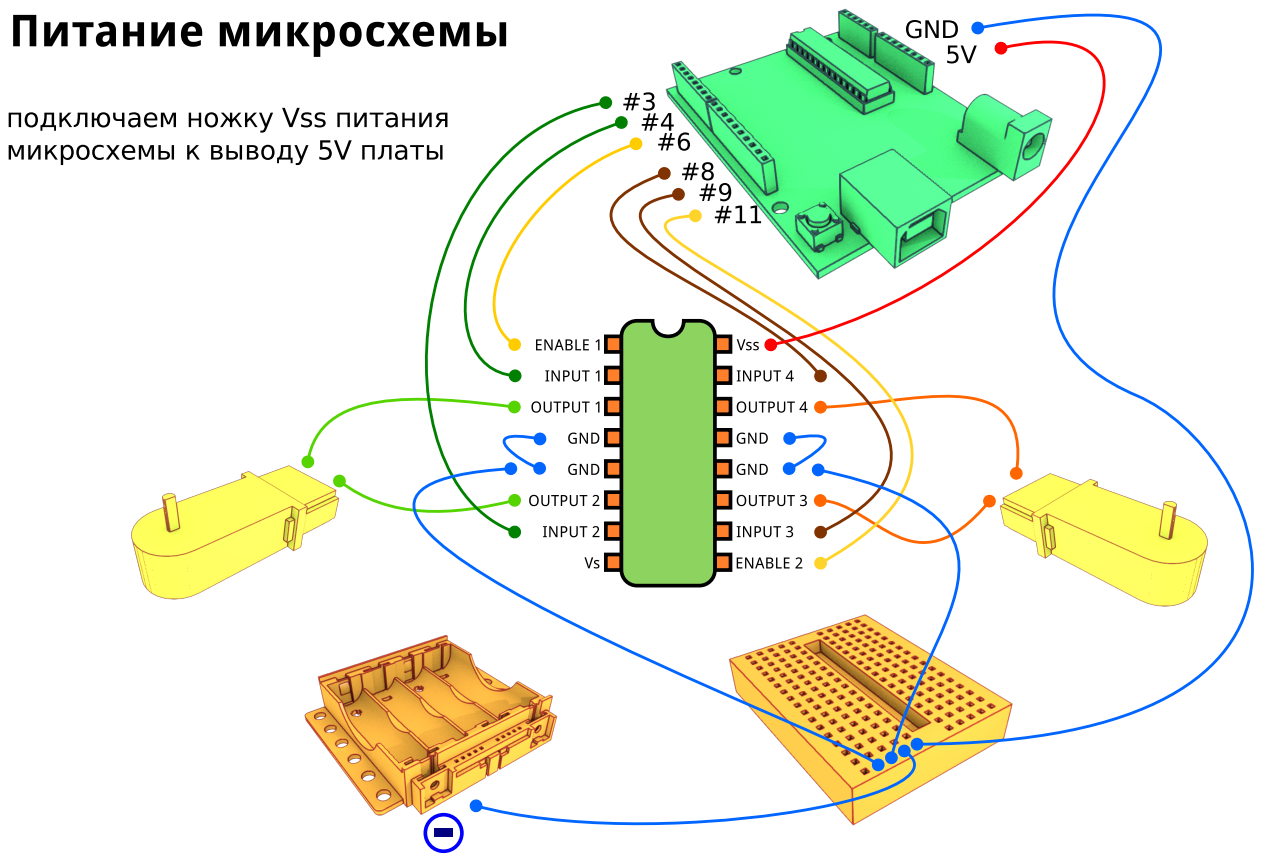
[picture p303: page 1]
