sadr0b0t/metalrobot/doc/robotcar-model2-инструкция-провода/instr-pages/export-pdf/07-connect-VS.pdf

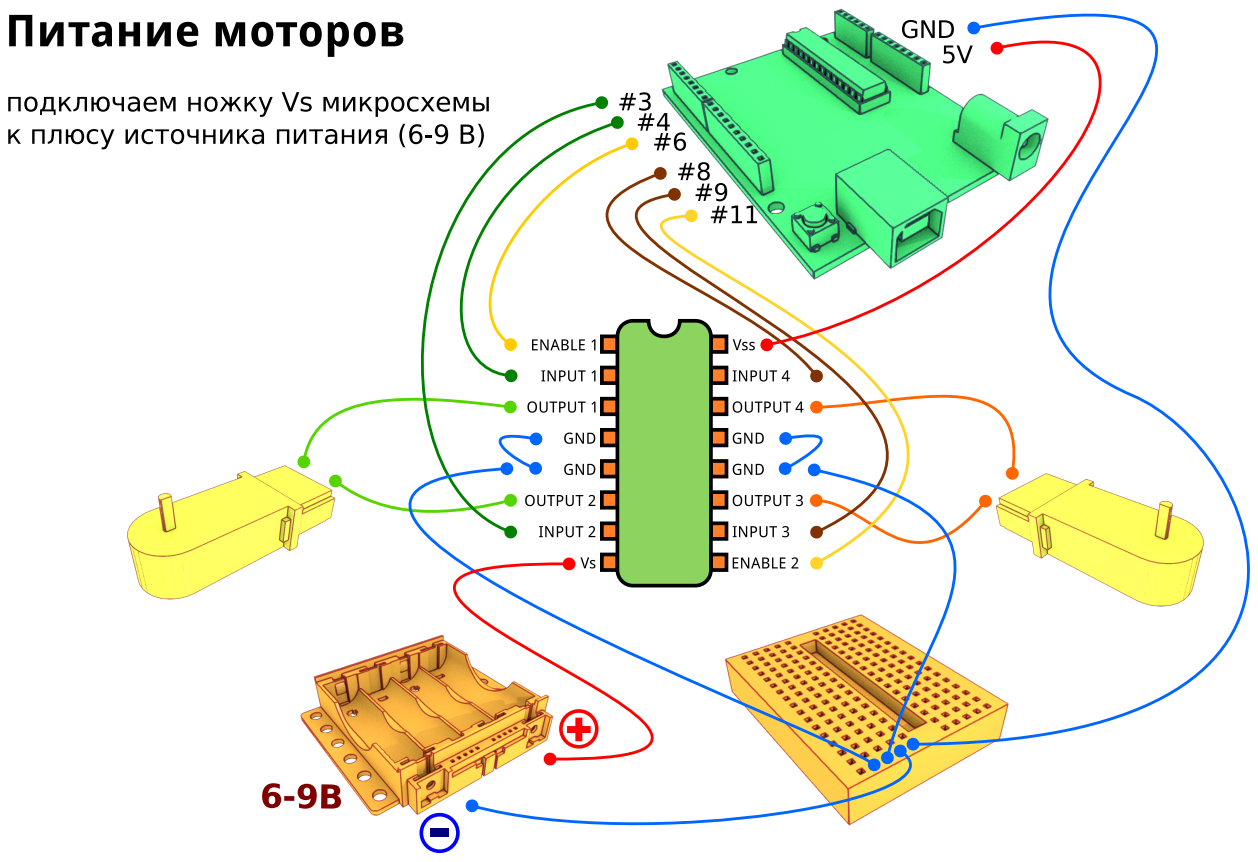
[picture p304: page 1]
