sadr0b0t/metalrobot/gearbox/gearbox-prototype1/export/gearbox.pdf

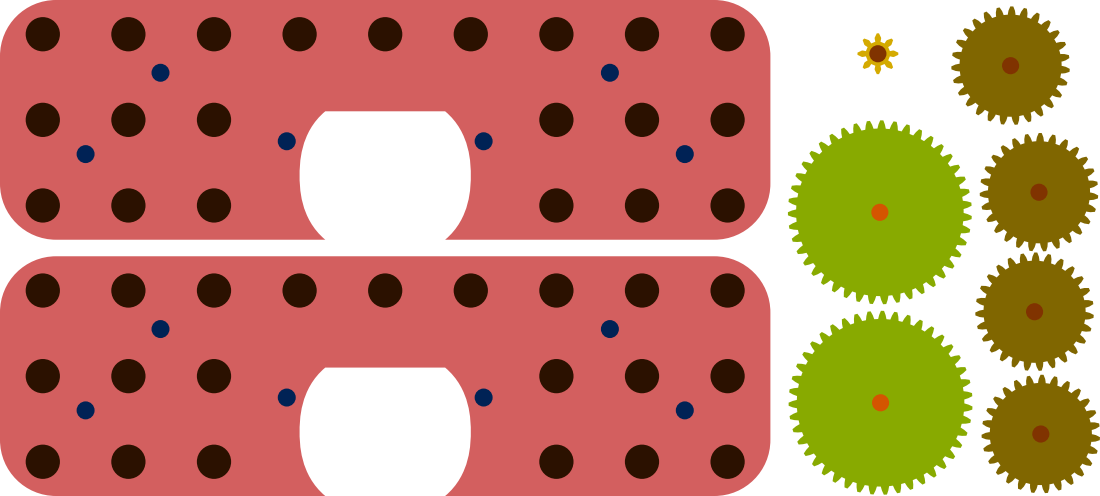
[picture p305: page 1]
