sadr0b0t/metalrobot/(commit log)

2013-12-26 Первый коммит первых деталей
    [all_details-05mm-alum.dxf, breadboard_holder-05mm-оцинк_сталь_3шт.dxf, chipKIT_Uno32_hor-05mm-оцинк_сталь_1шт.dxf, chipKIT_Uno32_vert-05mm-оцинк_сталь_1шт.dxf, chipKIT_WF32_hor-05mm-оцинк_сталь_1шт.dxf, chipKIT_WF32_vert-05mm-оцинк_сталь_1шт.dxf, motor1_holder-05mm-оцинк_сталь_2шт.dxf, motor2_holder-05mm-оцинк_сталь_2шт.dxf]
2014-02-14 Parts for the 1st production in Araks-nn; add dwg converted from DraftSight and AutoCad
    [all_details-05mm-alum.dxf, breadboard_holder-05mm-оцинк_сталь_3шт.dxf, breadboard_mount-1mm-оцинк_сталь_10шт.dxf, breadboard_mount-1mm-оцинк_сталь_15шт.dwg, breadboard_mount-1mm-оцинк_сталь_15шт.dxf, chipKIT_Uno32_hor-05mm-оцинк_сталь_1шт.dxf, chipKIT_Uno32_hor-1mm-оцинк_сталь_10шт.dwg, chipKIT_Uno32_hor-1mm-оцинк_сталь_10шт.dxf]
2014-03-04 Fix servo box and rib
    [servo_box-1mm-оцинк_сталь_60шт.dxf, servo_rib-1mm-оцинк_сталь_60шт.dxf]
2014-03-04 Увеличить отверстие для крепления мотора
2014-03-04 Увеличить размер выемки для корпуса мотора
2014-06-27 Архивировать экспорт для первой резки в Араксе
    [breadboard_mount-1mm-оцинк_сталь_10шт.dxf, breadboard_mount-1mm-оцинк_сталь_15шт.dwg, breadboard_mount-1mm-оцинк_сталь_15шт.dxf, chipKIT_Uno32_hor-1mm-оцинк_сталь_10шт.dwg, chipKIT_Uno32_hor-1mm-оцинк_сталь_10шт.dxf, chipKIT_Uno32_hor-1mm-оцинк_сталь_15шт.dwg, chipKIT_Uno32_hor-1mm-оцинк_сталь_15шт.dxf, chipKIT_Uno32_vert-1mm-оцинк_сталь_10шт.dwg]
2014-06-27 Убрать контуры отверстий
2014-06-27 Перенести трёхмерные детали в отдельное место
    [wheel.scad]
2014-08-31 Скопировать исходники Робота Машинки из репозитория lessons
    [wheel_generic_left.stl, wheel_generic_right.stl, wheel_motor1_left.stl, wheel_motor1_right.stl, wheel_motor2_left.stl, wheel_motor2_right.stl, все_детали.dxf, днище.dxf]
2014-08-31 Добавить модель покрышки для печати из эластичного полимера
    [tyre.stl, покрышка.dxf, покрышка.scad]
2014-08-31 Улучшить колеса - задвинуть вал вглубь, сделать ребра спиц скругленными
    [wheel_generic_left.stl, wheel_generic_right.stl, wheel_motor1_left.stl, wheel_motor1_right.stl, wheel_motor2_left.stl, wheel_motor2_right.stl, колесо.scad]
2014-09-07 Разные улучшения
    [wheel.scad]
2014-09-07 Добавить gitignore
2014-09-07 Сместить отверстия для Uno32
    [все_детали.dxf, корпус.dxf]
2014-10-01 Добавить прошивки для работы с сонаром и датчиком линии
2014-10-01 Увеличить диаметр отверстия для обычной оси до 3х мм
    [wheel_generic_left.stl, wheel_generic_right.stl, колесо.scad]
2014-10-01 Детали для производства - Робот Машинка
    [все детали.dxf]
2014-10-01 Переименовать measureDistance->measureDistanceCm
2014-10-01 Поправить комент, добавить мин задержку 50мс между двумя замерами
2014-10-02 Незначительные исправления
2014-10-02 Комент
2014-10-04 Навести порядок с модификаторами const/static для внутренних переменных
2014-10-09 Завершающий ноль лучше добавлять внутри handleInput
2014-10-10 Вернуть донуление строки read_buffer из handleInput в loop обратно взад, потому что там же делаем println(read_buffer) в следующей строке, и больше его в этих примерах не трогать
2014-11-03 Добавить пример с шестеренками
2014-11-12 Прошивка для Робота Птенца
2014-11-12 производство
    [все детали.dxf]
2014-11-12 Уменьшить выступ внутри отверстия для оси мотора2
    [wheel_motor2_left.stl, wheel_motor2_right.stl, колесо.scad]
2014-11-20 Добавить форму для литья покрышек, перенести модель покрышки в правильное место
    [tyre.stl, tyre_box_half1.stl, tyre_box_half2.stl, tyre_inner_surface.stl, покрышка-внешн.dxf, покрышка-внутр.dxf, покрышка-форма.scad, покрышка.dxf]
2014-12-18 Приседания
2015-01-09 Плагины для отрисовки зубчатого колеса и реечной передачи
2015-01-09 Добавить простой плагин для Инкскейпа - отрисовка прямоугольника
2015-01-09 Добавить опцию max для параметра количество зубцов
2015-01-10 Косметика
2015-02-13 Опечатка
2015-02-15 В 0.91 inkex.unittouu нужно заменить на self.unittouu
2015-02-17 Добавить скрипт для отрисовки коробки с ушками
2015-02-17 плюс комент
2015-02-23 Настраиваемая ширина обода для сцепки внутренней и внешней частей формы
    [tyre_box_half1.stl, tyre_box_half2.stl, tyre_inner_surface.stl, покрышка-форма.scad]
2015-02-25 Добавить тестовую коробку на листе a4
2015-02-26 Переработать конструкцию (всякие отступы) с учетом толщины картона
2015-02-26 Добавить отрисовку крепления боковых стенок
2015-02-27 Подогнать под поля для печати
2015-02-28 Добавить параметры штриховки линий сгиба
2015-02-28 Добавить раскрой коробки и ложемента
2015-03-01 Смещать начало штриховки
2015-03-01 Обновить, добавить
2015-03-01 Размер холста
2015-03-14 Пунктиры в контур
2015-03-18 Прошивка для следования по линии
2015-03-20 Добавить параметр bend line surface (поверхность сгиба), размерности коробки определяют внутреннее пространство, разные исправления
2015-03-20 Ехать по линии
2015-03-20 Использовать константы
2015-03-20 Вопрос
2015-03-20 Мини-реорганизация
2015-03-21 украшения
2015-03-29 Увеличить высоту фиксирующего обод, добавить фиксаторы вращения
    [tyre_box_half1.stl, tyre_box_half2.stl, tyre_inner_surface.stl, покрышка-форма.scad]
2015-03-29 Чуть углубить паз для обода
    [tyre_box_half1.stl, tyre_box_half2.stl, покрышка-форма.scad]
2015-03-29 Добавить трассы для заданий
2015-03-29 Добавить зажим для фиксации колеса на оси
    [axis_jam.stl, колесо.scad]
2015-03-31 Увеличить внешний диаметр покрышки
    [tyre_box_half1.stl, tyre_box_half2.stl, покрышка-внешн.dxf, покрышка-форма.scad]
2015-04-01 Поправить комент
    [покрышка-форма.scad]
2015-04-01 Зажим для оси колеса - ОК для робота
    [axis_jam.stl, колесо.scad]
2015-04-04 Перевернуть внутреннюю часть, чтобы при печати не возиться с поддержками рядом с фиксирующим ободом
    [tyre_inner_surface.stl, покрышка-форма.scad]
2015-04-04 коменты для ясности
    [колесо.scad]
2015-04-05 Добавить верхние стенки, чтобы не растекался силикон
    [tyre_box_half1.stl, tyre_box_half2.stl, tyre_inner_surface.stl, покрышка-форма.scad]
2015-04-05 Повернуть покрышку, чтобы технологическая линия проходила в более удобном месте рисунка протектора
    [tyre_box_half1.stl, tyre_box_half2.stl, tyre_inner_surface.stl, покрышка-форма.scad]
2015-04-08 Экспортированное правое колесо не перевернуто кверх ногами, срез оси для мотора2 0.4мм->0.3мм, отверстие для фиксирующего винта на ограничителе сделать шестигранным
    [wheel_generic_left.stl, wheel_generic_right.stl, wheel_motor1_left.stl, wheel_motor1_right.stl, wheel_motor2_left.stl, wheel_motor2_right.stl, колесо.scad]
2015-04-08 Добавить бортики наверху формы, разные исправления
    [tyre_box_half1.stl, tyre_box_half2.stl, tyre_inner_surface.stl, покрышка-форма.scad]
2015-05-02 Добавить уголок и отсек для батареек
    [angle1.scad, battery-aa-holder.scad, гайка-m3.dxf]
2015-05-02 Щель для связи отсека и внешних контактов
    [battery-aa-holder.scad]
2015-05-02 Рейка с дырками
    [battery-aa-holder.scad]
2015-05-02 марафет
    [battery-aa-holder.scad]
2015-05-16 Добавить ушки к зажимам для проводов
    [battery-aa-holder.scad]
2015-05-17 Перенести отсек для батареек в отдельный каталог
    [battery-aa-holder.scad, screw-nut-m3.dxf]
2015-05-17 Добавить stl для отсека
    [battery-aa-holder.stl]
2015-05-23 Задавать произвольное количество батареек (четное) параметрически
    [battery-aa-holder.scad]
2015-05-23 Добавить экспортированные отсеки на 2, 4 и 6 батареек
    [battery-aa-holder-4.stl, battery-aa-holder-6.stl]
2015-05-23 Разные варианты контактных площадок
2015-05-23 Сделать зажим для колеса полым, чтобы легче вкручивался винт
    [axis_jam.stl, колесо.scad]
2015-05-23 Вернуть рендер колеса по умолчанию
    [колесо.scad]
2015-05-23 Еще контактики
2015-05-23 Добавить пазы для защелок на контактных площадках
    [battery-aa-holder.scad]
2015-05-23 Нарисовать плюс и минус
    [battery-aa-holder.scad]
2015-05-23 Вернуть рендер отсека на 4 батарейки по умолчанию
    [battery-aa-holder.scad]
2015-05-23 Исправить прорези контактов для 2х батареек
    [battery-aa-holder.scad]
2015-05-23 Обновить рендеры
    [battery-aa-holder-2.stl, battery-aa-holder-4.stl, battery-aa-holder-6.stl]
2015-05-29 Добавить вариант отсека к креплениями паралльно батарейкам
    [battery-aa-holder-6-mod1.stl, battery-aa-holder-6-mod2.stl, battery-aa-holder.scad]
2015-05-29 Наброски для моторов
2015-05-29 Добавить экспортные файлы, уменьшить отверстие
    [motor1.dxf, motor2.dxf]
2015-05-29 Убрать контакты для макетки
2015-05-29 контакты для макетки
2015-05-29 Файлы для производства контактов из нержавейки
    [brbrd28-нерж сталь-0.5мм-5шт.dxf, brbrd5-нерж сталь-0.5мм-170шт.dxf, brbrd7-нерж сталь-0.5мм-20шт.dxf, buggy-нерж сталь-0.5мм-10шт.dxf, cont1-нерж сталь-0.5мм-20шт.dxf, cont2-нерж сталь-0.5мм-20шт.dxf, cont3-нерж сталь-0.5мм-20шт.dxf, cont4-нерж сталь-0.5мм-20шт.dxf]
2015-06-01 Добавить гаечный ключ и контуры гаек m3 m4
    [screw-nut-m3.dxf, screw-nut-m4.dxf, wrench-m3-m4.dxf]
2015-06-02 добавить деталек
    [buggy-нерж сталь-0.5мм-20шт.dxf, motorbox-нерж сталь-0.5мм-5шт.dxf, motorbox2-нерж сталь-0.5мм-5шт.dxf]
2015-06-02 добавить деталек для моторчиков
    [motorbox.dxf, motorbox2.dxf]
2015-06-03 Добавить редуктор
2015-06-16 Добавить коробку для редуктора
    [gearbox-column.scad, gearbox-column.stl, gearbox-shim.stl, motor_face.dxf, motor_fix.stl]
2015-06-16 Вторая версия редуктора в Лазерхолл
2015-06-17 подправить отверстия
    [gearbox-column.scad]
2015-06-18 Поворачивать 350 миллисекунд лучше, чем 400
2015-06-18 новая версия: переход от контактов к крайним батарейкам через отверстие для винта, а не через скобу
    [battery-aa-holder.scad]
2015-06-21 Убрать пока ушко, чтобы не было проблемы с экспортом stl
    [battery-aa-holder.scad]
2015-06-22 Корпус для макетки
    [breadboard.scad]
2015-06-22 Увеличить размер паза для контакта, чтобы учесть погрешность при печати
    [breadboard.scad]
2015-06-23 Сблизить зажимы и крайние контакты батареек
    [battery-aa-holder.scad]
2015-06-23 Добавить блоки макеток
    [battery-aa-holder-6-mod2-v2.stl]
2015-06-24 добавить ножки внизу макетки, может с ними будет чуть лучше при печати
    [breadboard.scad]
2015-06-24 Поулучшать область макетки и контактов
    [battery-aa-holder.scad]
2015-06-24 Убрать проблему со слайсером
    [battery-aa-holder-6-mod2-v2.stl, breadboard.scad]
2015-06-24 добавить полную макетку
    [breadboard.scad]
2015-07-01 Дырки для ушек контактов внизу отсека
    [battery-aa-holder-6-mod2-v2.stl, battery-aa-holder.scad]
2015-07-05 Доработки контактной площадки
    [battery-aa-holder-6-mod2-v2.stl, battery-aa-holder.scad, wire-plate1.dxf, wire-plate2.dxf]
2015-07-05 Убрать пока дырку для защелки вбок
    [battery-aa-holder.scad]
2015-07-05 Оставить одну линию контактов макетки
    [battery-aa-holder.scad]
2015-07-05 Соединить стенки, чтобы работал слайсер в 3д-принтере
    [breadboard.scad]
2015-07-05 Добавить ступеньки для контактных пластинок
    [breadboard.scad]
2015-07-05 Поправить контакты
    [battery-aa-holder-6-mod2-v2.stl, battery-aa-holder.scad]
2015-07-07 Подправить область макетки и внешних контактных площадок (3д); добавить сдвоенные контактные вкладки для макетки, исправить контактные площадки для батареек (2д)
    [battery-aa-holder-6-mod2-v2.stl, battery-aa-holder.scad, wire-plate1-43d.dxf, wire-plate1.dxf, wire-plate2.dxf]
2015-07-07 Добавить новые варианты контактных вкладок
2015-07-11 Обновить контактные площадки
    [2brbrd1.dxf, 2brbrd2.dxf, 2brbrd3.dxf, 2brbrd4.dxf, battery-aa-holder.scad, contact-minus-2brbrd.dxf, contact-minus-2brbrd2.dxf, contact-minus-2brbrd3.dxf]
2015-07-11 Конвертировать круглое отверстие в кривые
    [motorbox.dxf, motorbox2.dxf]
2015-07-11 Незначительные доработки
2015-07-13 Добавить настраиваемый учет погрешности при печати на 3д-принтере
    [wheel_motor2_left.stl, wheel_motor2_right.stl, колесо.scad]
2015-07-13 Радиус среза на motor2 0.9мм
    [wheel_motor2_left.stl, wheel_motor2_right.stl, колесо.scad]
2015-07-16 Новый редуктор gearbox-prototype2 полностью для печати 3дпринтере; немного разобрать файлы старых моделей
    [box-motor-inside-43d.dxf, box-motor-wall-43d.dxf, box-wheels-inside-43d.dxf, box-wheels-wall-43d.dxf, box.scad, gear-cp1.5-t27.dxf, gear-cp1.5-t43.dxf, gear-cp1.5-t63-support.dxf]
2015-07-16 Уменьшить погрешность для печати до 0.1мм, поправить коменты
    [wheel_motor2_left.stl, wheel_motor2_right.stl, колесо.scad]
2015-07-17 Подравнять всякие штуки в районе макетки и контактов
    [battery-aa-holder-6-mod2-v2.stl, battery-aa-holder.scad]
2015-07-18 Подрихтовать шестеренки, добавить чертежи для валов
    [gear-motor.stl, gear-transmission.stl, gear-wheel.stl, gears.scad]
2015-07-18 Печатать без обрисовки
2015-07-18 Добавить тестовые профили печати на Picaso 3D Desgner
2015-07-18 Добавить учет погрешности при печати, по умолчанию значение 0.2
    [battery-aa-holder-6-mod2-v2.stl, battery-aa-holder.scad]
2015-07-20 Много мелких исправление
    [box-motor-inside-43d.dxf, box-motor-wall-43d.dxf, box-wheels-inside-43d.dxf, box-wheels-wall-43d.dxf, box.scad, gearbox-half-motor.stl, gearbox-half-wheels.stl, gears.scad]
2015-07-22 Показывать шестеренки
2015-07-28 Незначительные помарки и коменты
    [box.scad, gearbox-column.scad, gears.scad]
2015-07-28 Прототип нового редуктора на 3 ступени
    [box-motor-inside-43d.dxf, box-motor-wall-43d.dxf, box-wheels-inside-43d.dxf, box-wheels-wall-43d.dxf, box.scad, gear-motor.stl, gear-pa20-cp1.5-t61.dxf, gear-pa20-cp1.5-t9.dxf]
2015-07-28 Упорядочить файл, корпус из пластика
    [moborbox1.scad, motor-box.stl, motor-lid.stl]
2015-07-28 Обновить stl-файлы
    [gear-transmission1.stl, gear-transmission2.stl]
2015-08-04 Черновик коллектора, блоки для квадратных магнитиков, исправить крышку, блоки для щеток и т.п.
    [moborbox1.scad, motor-box.stl, motor-collector.stl, motor-lid.stl]
2015-08-05 поправить высоту стоек по мелочи
    [box.scad]
2015-08-07 Добавить коменты, поправить стойки
    [box.scad]
2015-08-07 Красивый пульт для машинки
2015-08-09 Коменты
    [gears.scad]
2015-08-09 Двигаться только тогда, когда нажата кнопка
2015-08-09 Редуктор 4, 3 ступеньки, 6000оботоров -> 150 оборотов
    [box-motor-inside-43d.dxf, box-motor-wall-43d.dxf, box-wheels-inside-43d.dxf, box-wheels-wall-43d.dxf, box.scad, gear-motor.stl, gear-pa20-cp1.5-t13.dxf, gear-pa20-cp1.5-t41.dxf]
2015-08-11 чуть сблизить передачу2 и шестеренку на колесе
    [box-motor-inside-43d.dxf, box-wheels-inside-43d.dxf, box.scad, gearbox-half-motor.stl, gearbox-half-wheels.stl]
2015-08-13 Прототип редуктора5 - понижает 6000 оборотов в 60 оборотов
    [box-motor-inside-43d.dxf, box-motor-wall-43d.dxf, box-wheels-inside-43d.dxf, box-wheels-wall-43d.dxf, box.scad, gear-motor.stl, gear-pa20-cp1.5-t12.dxf, gear-pa20-cp1.5-t47.dxf]
2015-08-15 Вспомогательные элементы для крепления колеса
    [axis_jam-motor2.stl, box.scad, wheel_shim-motor2.stl]
2015-08-15 Чертежи стержней для 3хступенчатого редуктора
2015-08-16 Новые версии щеток для коллектора, доработать коллектор, две версии корпуса: motor1 для серий F130 и F280 и motor2 для своего якоря
    [moborbox1.scad, motor-lid.stl, motor1-box.stl, motor1-lid.stl, motor1.dxf, motor2-anchor.dxf, motor2-bottom_fix.stl, motor2-box.stl]
2015-08-16 Добавить учет погрешности при печати
    [angle1.scad, angle1_1.stl, angle1_2.stl, angle1_3.stl, angle1_4.stl]
2015-08-16 Файлы для 3д-печати на Picaso 3D Designer
2015-08-16 Увеличить толщину коллектора
    [moborbox1.scad, motor2-bottom_fix.stl, motor2-collector.stl, motor2-collector_fix.stl, motor2-collector_lid.stl]
2015-08-16 Удлиннить коллектор
    [moborbox1.scad, motor2-bottom_fix.stl, motor2-collector.stl, motor2-collector_contact1.dxf, motor2-collector_contact2.dxf]
2015-08-17 Файлы - контактные площадки для отсека и детали для моторчика для резки лазером из стали 0.2мм (не приняли в Крабере)
    [2brbrd1-нерж сталь-0.2мм-10шт.dxf, 2brbrd2-нерж сталь-0.2мм-10шт.dxf, 2brbrd3-нерж сталь-0.2мм-10шт.dxf, 2brbrd4-нерж сталь-0.2мм-10шт.dxf, contact-minus-2brbrd-нерж сталь-0.2мм-10шт.dxf, contact-minus-2brbrd2-нерж сталь-0.2мм-10шт.dxf, contact-minus-2brbrd3-нерж сталь-0.2мм-10шт.dxf, contact-minus-minus-нерж сталь-0.2мм-10шт.dxf]
2015-08-17 Колеса для Робота Машинки 2.0
2015-09-13 Сдвинуть дырки по вертикали так, чтобы крепежи половинок редуктора были на одной линии с отверстиями общего назначения наверху (совместимы с металлическим конструктором)
    [box-motor-inside-43d.dxf, box-motor-wall-43d.dxf, box-wheels-inside-43d.dxf, box-wheels-wall-43d.dxf, box.scad, gearbox-half-motor.stl, gearbox-half-wheels.stl, motor_face-f130-43d.dxf]
2015-09-16 Черновики корпусов
    [box-motor-inside-43d.dxf, box-motor-wall-43d.dxf, box-wheels-inside-43d.dxf, box-wheels-wall-43d.dxf, box.scad, motor_face-43d.dxf, rover-draft1-openscad.stl, rover-draft1.scad]
2015-09-19 До поры сохранить черновики для контактных площадок
    [2brbrd1.dxf, 2brbrd2.dxf, 2brbrd3.dxf, 2brbrd4.dxf, contact-minus-2brbrd.dxf, contact-minus-2brbrd2.dxf, contact-minus-2brbrd3.dxf, contact-minus-minus.dxf]
2015-09-19 Добавим лицензию
2015-09-19 Новая версия контактов для отсека для резки из стали 0.2мм
    [brbrd-2contact-нерж сталь-0.2мм-100шт.dxf, brbrd-2contact.dxf, contact-minus-нерж сталь-0.2мм-50шт.dxf, contact-minus.dxf, contact-plus-minus-нерж сталь-0.2мм-250шт.dxf, contact-plus-minus.dxf, contact-plus-нерж сталь-0.2мм-50шт.dxf, contact-plus.dxf]
2015-10-18 Скругленные углы на планках с отверстиями
    [battery-aa-holder.scad]
2015-10-19 Разные мелкие улучшения: добавить лого, уменьшить толщину макетки, вставлять парные контакты снизу, а не сверху, уменьшить выемку под пипку+, боковые выемки под пальцы
    [battery-aa-holder.scad]
2015-10-19 лого для гравировке нижней стенке
    [credits-43d.dxf]
2015-10-19 Новая версия отсека с разными мелкими улучшениями: добавить лого, уменьшить толщину макетки, вставлять парные контакты снизу, а не сверху, уменьшить выемку под пипку+, боковые выемки под пальцы
    [battery-aa-holder-6-mod2-v3.stl]
2015-10-19 Обновить лого
    [battery-aa-holder-6-mod2-v3.stl]
2015-11-03 переименовать партию
    [brbrd-2contact-нерж сталь-0.2мм-100шт.dxf, contact-minus-нерж сталь-0.2мм-50шт.dxf, contact-plus-minus-нерж сталь-0.2мм-250шт.dxf, contact-plus-нерж сталь-0.2мм-50шт.dxf, wire-plate1-нерж сталь-0.2мм-100шт.dxf]
2015-11-17 Переработать код, добавить коменты, добавить параметры для высоты и толщины боковых стенок макетки
    [breadboard.scad]
2015-11-17 Высота ступеньки для металлического контакта не зависит от высоты внешней стенки
    [breadboard.scad]
2015-11-17 Множественные улучшения в отсеке: вход для макетки снизу, общая площадка для макетки и контакта батарейки, чистка и улучшения кода
    [battery-aa-holder-4-mod2.stl, battery-aa-holder-6-mod2-v3.stl, battery-aa-holder-6-mod2-v4.stl, battery-aa-holder.scad, brbrd-2contact.dxf, contact-minus.dxf, contact-plus-minus.dxf, contact-plus.dxf]
2015-11-17 Добавить исходный файл с чертежами
2015-11-19 Увеличить места для батарейки в длину (отодвинуть пипку на минусе и углы выемки на плюсе), поправить нижние пазы на контактах (чтобы не мешал растекающийся по столику при печати пластик)
    [battery-aa-holder-4-mod2.stl, battery-aa-holder-6-mod2-v4.stl, battery-aa-holder.scad]
2015-11-19 немного удлиннить ножки контактов
    [brbrd-2contact.dxf, contact-minus.dxf, contact-plus-minus.dxf, contact-plus.dxf]
2015-12-11 Переработь код - сделать понятные переменные, задающие габариты батарейки
    [battery-aa-holder.scad]
2015-12-11 Переработь код: задавать ширину батарейки параметрически в переменных
    [battery-aa-holder.scad]
2015-12-14 передавать габариты элементов отсека через параметры
    [battery-aa-holder.scad]
2015-12-16 Добавить полочку, чтобы конакт макетки не вываливался вниз
    [battery-aa-holder-4-mod3.stl, battery-aa-holder.scad]
2015-12-16 Побольше надпись
    [credits-43d.dxf]
2015-12-16 Файлы для производства отсеков и контактных площадок
    [battery-aa-holder-6-mod2-v3.stl, battery-aa-holder-6-mod2-v4.stl, brbrd-2contact-нерж сталь-0.2мм-100шт.dxf, contact-minus-нерж сталь-0.2мм-10шт.dxf, contact-plus-minus-нерж сталь-0.2мм-250шт.dxf, wire-plate1-нерж сталь-0.2мм-100шт.dxf]
2015-12-16 Обновить отсеки
    [battery-aa-holder-4-mod2.stl, battery-aa-holder-6-mod2-v4.stl, holder-aa-2.stl]
2015-12-28 Добавить сгибалку для контактов макетки
    [brbrd-bender-plug-43d.dxf, brbrd-bender-plug.stl, brbrd-bender-socket-43d.dxf, brbrd-bender-socket.stl, brbrd-bender.scad]
2016-01-04 Сгибатель для конической пружинки для отсека АА, черновик 1
    [spring-bender-base.stl, spring-bender-top.stl, spring-bender.scad]
2016-01-06 Черновик3, поправить размеры, конструкция поустойчивее, косая щель для проволоки, в конусе дырка сверху вместо вала
    [spring-bender-base.stl, spring-bender-top.stl, spring-bender.scad]
2016-01-10 Черновик4: еще подогнать размеры, поворотный ключ снизу, а не сверху
    [spring-bender-base.stl, spring-bender-top.stl, spring-bender.scad, spring-helix_key.stl]
2016-01-10 Черновик5: изменить направление намотки снизу вверх, фиксатор проволоки снизу
    [spring-bender-base.stl, spring-bender-top.stl, spring-bender.scad]
2016-01-19 Добавить шестинога из 2012 года
    [2legs_for_printing.stl, 4holders_1_for_printing.stl, 4holders_for_printing.stl, body.stl, body1.stl, spider.scad]
2016-01-20 Добави технологический паз снизу вокруг оси, чтобы пластик с первого слоя не забивал отверстие под ось при печати
    [wheel_generic_left.stl, wheel_generic_right.stl, wheel_motor1_left.stl, wheel_motor1_right.stl, wheel_motor2_left.stl, wheel_motor2_right.stl, колесо.scad]
2016-01-21 переместить экспортированные файлы в отдельное место
2016-01-21 Поправить ячейки ложемента: объединить моторы, новый размер отсека 70x80, больше места для проводов, расширить ячейку для коробки Iskra Neo 60мм
2016-01-21 преобразовывать пунктир в сегменты перед экспортом для производства
2016-01-21 Коробки + ложемента на 10 наборов: микрогофрокартон листы 1000x700мм + поролон лист 1000x2000мм
2016-01-21 Опечатка в названии проекта: Netling > NeStling
2016-01-21 Увеличить размер коробки до 390x220x80мм с 380x205x80мм, чтобы было чуть просторнее
2016-01-21 Поправить коменты к параметрам плагина генерации разворота
2016-01-21 Обновить разворот квадратной коробки для собранного ровера
2016-01-22 Добавить файлы полиграфии - наклейки на коробку
2016-01-22 Обновить qr-код на sadrobot.su
2016-01-22 Добавить трассы роботрафик
2016-01-22 Еще один черновик корпуса в блендере (не очень удачный) - уменьшить количество узлов сетки сплайна по максимуму
2016-01-24 Уточнить имена
2016-01-24 Добавить разворот для квадратной коробки для ровера на листе 1000x700мм
2016-01-24 Добавить параметр print_error - погрешность при печати, уменьшить зазоры между фиксирующим обручем внутреннего элемента и круглой канавки внешних элементов
    [tyre_box_half1.stl, tyre_box_half2.stl, tyre_inner_surface.stl, покрышка-форма.scad]
2016-01-24 Сделать фиксаторы вращения в форме домика (чтобы можно было печатать в перевернутом виде без поддержки)
    [tyre_inner_surface.stl, покрышка-форма.scad]
2016-01-24 Увеличить толщину кольца формы, чтобы нижний фиксирующий обод не выступал за его границы и для его печати не требовались поддержки
    [tyre_inner_surface.stl, покрышка-форма.scad]
2016-01-24 Поправить коменты
    [angle1.scad]
2016-01-24 Вариант контакта с макеткой под фрезерерование фрезой 2мм
2016-01-24 Добавить варианты остальных контактов для фрезы 2мм
    [wire-plate1.dxf]
2016-01-25 Свойства документы - размер страницы в мм
2016-01-25 Файлы наклеек на печать на 310x440
2016-01-25 print_error=0.1 вместо 0.2
    [tyre_box_half1.stl, tyre_box_half2.stl, tyre_inner_surface.stl, покрышка-форма.scad]
2016-01-26 компенсация для фрезы с диаметром 1.1мм
2016-01-29 Добавить задания для 3д-печати деталей
2016-01-30 Добавить компенсацию диаметра фрезы 1.08мм и 1мм, исправить компенсацию для 2мм, 1.1мм
2016-01-30 Задания для производства контактов на фрезере
2016-01-31 Поправить часть с креплением пружинки, расчистить место внутри макеточной части, чтобы контакт нормально влезал наискосок новым способом, и добавить полочку внизу, чтобы контакт не выпадал вниз при в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
    [battery-aa-holder-4-mod3.stl, battery-aa-holder.scad]
2016-02-01 Контакты для фрезы 2мм
2016-02-02 Новый способ фиксировать контакты внутри макеточной части - отгибающимся ушком справа
    [battery-aa-holder-4-mod3.stl, battery-aa-holder.scad]
2016-02-03 Убрать логотип (все равно не пропечатывается)
    [battery-aa-holder-4-mod3.stl, battery-aa-holder.scad]
2016-02-05 Сделать сгибалку повыше, чтобы уместился новый заусенец, торчащий снизу из макеточной части
    [brbrd-bender-plug.stl, brbrd-bender-socket.stl, brbrd-bender.scad]
2016-02-05 Экспортировать модель с разными варианты погрешности при печати для разных пластиков
    [brbrd-bender-plug-pe0.1.stl, brbrd-bender-plug-pe0.2.stl, brbrd-bender-socket-pe0.1.stl, brbrd-bender-socket-pe0.2.stl, brbrd-bender.scad]
2016-02-05 Больше заданий для печати
2016-02-06 Добавить вариант сгибалки макетки для печати с погрешностью 0.3мм
    [brbrd-bender-plug-pe0.3.stl, brbrd-bender-socket-pe0.3.stl]
2016-02-13 Обновить лицензию, добавить дополнительне условие про отсек для батареек
2016-02-13 Вышибание кеглей из круга: поворот, определять кеглю датчиком расстояния, не выезжать за пределы круга
2016-02-16 Задание для печати уголков
2016-02-22 Эволюционные улучшения конструкции первой модели Робота Машинки
    [motor_fix-pe0.2.stl, корпус-43d.dxf, крепление-редуктора.scad]
2016-02-24 Реорганизовать файлы, добавить винтовые крепления к креплению мотора, добавить крепления для задней оси
    [motor_fix-pe0.2.stl, rod_fix-pe0.2.stl, корпус.scad, крепление-мотор-43d.dxf, крепление-ось-43d.dxf, крепление-редуктора.scad]
2016-02-25 Крепление мотора: увеличить в высоту до 28мм до середины вала, добавить канавку на внетренней стенке для мелких выпуклостей на задней стенке редуктора
    [motor_fix-pe0.2.stl, корпус.scad]
2016-02-25 Вертикальная рама: двойные уголки для вертикального крепления верхней и нижней частей корпуса
    [frame_fix-pe0.2.stl, корпус.scad]
2016-03-02 Фиксатор проволокидополнительной скобой в нижней части спирали (как рабочий вариант так себе, но лучше чем было, пусть будет для истории)
    [spring-bender.scad, spring-helix_fix.stl]
2016-03-04 Прижать рейки с отверстиями к задней стенке отсека, сдвинуть рейки с отверстиями вправо так, чтобы расстояние между отверстием и стенкой отсека было одинаковым для обеих реек
    [battery-aa-holder-4-mod3.stl, battery-aa-holder.scad]
2016-03-04 Новая версия сгибателя, очень хорошо рабочая по сравнению с прошлыми версиями: конец проволоки фиксируется снизу винтом, шайбой и гайкой в основании спирали; главный рабочий элемент пока спираль, ост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
    [spring-bender.scad, spring-helix_fix.stl]
2016-03-04 Убрать небольшой рудиментик
    [battery-aa-holder-4-mod3.stl, battery-aa-holder.scad]
2016-03-06 Еще черновой вариант сглаженного корпуса в openscad с hull
    [rover-draft4.scad]
2016-03-22 Добавить отступ между внутренними боковыми стенками коробками и ложементом, чтобы сверху влезали уши от крышки
2016-03-22 Файлы для производства партии12 (2я серийная партия наборов с Машинкой)
2016-03-24 Задания для 3д-печати - Билдер, пластик FdPlast
2016-03-24 Задание для печати стопорных втулок 30 штук
2016-03-24 Указывать значение print error в имени файла
2016-03-24 Переименовать rod_fix -> axis_fix для единообразия с axis_jam
    [axis_fix-pe0.2.stl, корпус.scad]
2016-03-24 Задание для печати 16 уголков 1x4
2016-03-24 Переименовать получше
2016-04-05 Обновить задания для 3д-печати, больше информации в именах файлов
2016-04-05 Сделать технологические пазы под щелями контактов в виде арок, чтобы пластик не осыпался сверху при печати
    [battery-aa-holder.scad]
2016-04-05 Добавить к длине пружинки миллиметр
    [battery-aa-holder.scad]
2016-04-05 Уменьшить толщину передней и задней стенок на 0.5мм
    [battery-aa-holder-4-mod4.stl, battery-aa-holder.scad]
2016-04-19 Греть стол не до 115, а до 110 градосов на первом слое (до 115 долго греет слишком и незачем)
2016-04-19 Новый слайс для боковых стенок, 4 стенки печатаются столько же, сколько перед этим 2 (в районе часа)
2016-04-19 Компенсация фрезы 0.6мм, добавить комент с инструкцией, как компенсировать диаметр
2016-04-20 Температура первый слоя 110, а не 115
2016-04-20 60мм/сек слишком быстро - лажает, 45мм/сек ок
2016-04-25 Файл для вырезания контактов Рраптор+медь 0.2мм (макеточная часть+квадраты), 2 февраля 2016
2016-05-06 Резка контактов для отсеков из остатков меди
2016-05-22 Инструкция по сборке - черновик1
    [Pololu-d-shaft.stl, angle1_4.stl, axis_fix-pe0.2.stl, axis_jam.stl, battery-aa-holder-4.stl, breadboard-17x10.stl, frame_fix-pe0.2.stl, motor_fix-pe0.2.stl]
2016-05-22 Модель макетки 17x10
    [breadboard-17x10.stl]
2016-05-22 Слайс отсека после небольших прямых правок Михаила файла stl (убрал мелкие выступы, погнал стенки до 1.2мм, в оригинальной модели этих изменений нет)
2016-05-25 3д-модели для сторонних компонентов (для сборки 3д-моделей и визуализации): микрочипы в корпусе DIP, мотор Pololu, разные провода
    [Pololu-dshaft.stl, axis-d2mm-l150mm.stl, bls-03.stl, cable_usb-a-b.stl, chip-dip-2x8.stl, head_pin.stl, microchips.scad, motors.scad]
2016-05-25 Добавить рендер новых компонент: микросхема L293D, провода, задняя ось
    [Pololu-d-shaft.stl, Pololu-dshaft.stl, axis-d2mm-l150mm.stl, cable_usb-a-b.stl, chip-dip-2x8.stl, wire1-1core-pin-pin.stl]
2016-05-25 Перенесем 3д-сборку модели в отдельное место
    [днище.dxf, колесо.dxf, корпус.dxf, крепление-оси.dxf, машинка.scad, рама-моторы.dxf, рама-ось.dxf]
2016-05-25 3д-версии плоских деталей (для печати на 3д-принтере или для сборки виртуальной модели, визуализации и т.п.)
    [frame-bottom.stl, frame-top.stl, детали-3d.scad, днище-43d.dxf, корпус-43d.dxf]
2016-05-25 Добавить рендер деталей корпуса - верх и днище
    [frame-bottom.stl, frame-top.stl]
2016-05-26 Добавить винтов и гаек - генератор в OpenSCAD и экспортированные STL для M3 и M4
    [ISOThread.scad, crosshead_screw-M3x10.stl, crosshead_screw-M3x12.stl, crosshead_screw-M3x14.stl, crosshead_screw-M3x16.stl, crosshead_screw-M3x18.stl, crosshead_screw-M3x20.stl, crosshead_screw-M3x22.stl]
2016-05-26 Рендер винтов и гаек M3 и M4 для набора
    [crosshead_screw-M3x10.stl, crosshead_screw-M3x12.stl, crosshead_screw-M3x14.stl, crosshead_screw-M3x26.stl, crosshead_screw-M3x6.stl, crosshead_screw-M4x10.stl, crosshead_screw-M4x12.stl, crosshead_screw-M4x14.stl]
2016-05-28 Убрать щель между резьбой и сердечником, добавить возможность задавать качество отрисовки для сердечника и резьбы отдельно, экспортировать все модели винтов пачкой внешними скриптами
    [ISOThread-mod1.scad, crosshead_screw-M3x10.stl, crosshead_screw-M3x12.stl, crosshead_screw-M3x14.stl, crosshead_screw-M3x16.stl, crosshead_screw-M3x4.stl, crosshead_screw-M3x6.stl, crosshead_screw-M3x8.stl]
2016-05-28 Обновить рендер для винтов, добавить винты и гайки в инструкцию
    [crosshead_screw-M3x10.stl, crosshead_screw-M3x12.stl, crosshead_screw-M3x14.stl, crosshead_screw-M3x6.stl, crosshead_screw-M4x10.stl, crosshead_screw-M4x12.stl, crosshead_screw-M4x14-thr10-cq100.stl, crosshead_screw-M4x14-thr30-cq30.stl]
2016-05-28 Игнорировать бэкапы блендера
2016-05-28 Отрисовка пружинных шайб
    [screws.scad, spring_washer-M3.stl, spring_washer-M4.stl]
2016-05-28 Игнорировать свап-файлы tex
2016-05-28 Рендер пружинных шайб и прижинные шайбы в инструкции
    [spring_washer-M3.stl, spring_washer-M4.stl]
2016-05-28 Комент про то, что виток спирали шайбы идет в противоположном направлении с резьбой
    [screws.scad]
2016-05-29 Черновики для моделей платы Arduino, сонара и инфракрасного датчика линии
    [Arduino.scad, Arduino.stl, ir_line_sensor.stl, sensors.scad, sonar.stl]
2016-05-29 Добавить рендер черновиков Ардуино, сонара и инфракрасного датчика линии
    [Arduino.stl, ir_line_sensor.stl, sonar.stl]
2016-05-30 Добавить рендер стопорной втулки с вставленным винтом
2016-05-30 Граф действий для светлой обводки - вынести параметры на вершину группы
2016-05-30 Исправить угол наклона винта в стопорной втулке
2016-06-01 отдельные файлы для ячеек и подложки
2016-06-02 Обновить модели и рендер для платы Arduino, добавить модель и рендер платы ChipKIT Uno32
    [Arduino.scad, Arduino.stl, arduino_uno.stl, chipkit_uno32.stl]
2016-06-02 Пусть провод USB пока будет вишневым
2016-06-02 Переименоваро модель и рендер Arduino Uno в Arduino Uno China, чтобы отличать ее от модели классической Ардуины с чипом в корпусе DIP
    [Arduino.scad, arduino_uno-china.stl]
2016-06-02 Перенести код рисования чипа SMD в файл microchips.scad. Добавить модель и рендер классической ардуины с чипом в корпусе DIP
    [Arduino.scad, arduino_uno.stl, microchips.scad]
2016-06-02 Пусть в инструкции будет классическая ардуина с чипом в корпусе DIP
2016-06-05 Поправить немного граф в режиме композитинга
2016-06-06 Обновить модель инфракрасного датчика линии
    [ir_line_sensor.stl, sensors.scad]
2016-06-06 Пробные рендеры собранной модели
2016-06-06 Новый рендер датчика линии, новая картинка собранной модели в шапке
    [ir_line_sensor.stl]
2016-06-06 Обновить модель сонара
    [sensors.scad, sonar.stl]
2016-06-06 Обновить рендер сонара
    [sonar.stl]
2016-06-07 Последовательная сборка машинки модель2 - инструкция
    [Pololu-dshaft.stl, angle1_4.stl, arduino_uno-china.stl, arduino_uno.stl, axis-d2mm-l150mm.stl, axis_fix-pe0.2.stl, axis_jam.stl, battery-aa-holder-4.stl]
2016-06-07 Вычистить неиспользуемую группу Group1
2016-06-07 Рендер последовательной сборки корпуса машинки
2016-06-07 Шаг с приделыванием макетки
2016-06-07 Сохранять именованные цветные материалы даже, если они не используются (кнопка F справа от имени материала)
2016-06-07 Первый черновик инструкции по сборке корпуса
2016-06-08 Переименовать angle1_4 -> angle_1x4 и другие размеры тоже
    [angle1.scad, angle_1x1.stl, angle_1x2.stl, angle_1x3.stl, angle_1x4.stl]
2016-06-08 Рендер действий для установки уголков и инфракрасных датчиков линии
    [ir_line_sensor.stl, sonar.stl]
2016-06-08 Другой ракурс на креплении датчика линии
2016-06-14 Сделать технологический паз под осью в виде полусферы, чтобы пластик не обвисал при печати
2016-06-16 Больше вариантов цветов для платы Arduino и микросхемы L293D (8 ножек, DIP)
2016-06-16 Первая версия инструкции по подключению проводов
2016-06-16 Перенесем подключение проводов в отдельный каталог на верхнем уровне
2016-06-16 Глобальный gitignore для всех документов
2016-06-16 Переименовать -инструкция > -инструкция-корпус для большей ясности
    [Pololu-dshaft.stl, angle_1x4.stl, arduino_uno-china.stl, arduino_uno.stl, axis-d2mm-l150mm.stl, axis_fix-pe0.2.stl, axis_jam.stl, battery-aa-holder-4.stl]
2016-08-18 Экспортировать страницы со списком деталей в png
2016-08-24 Игнорировать временные файлы *~ везде
2016-08-24 Форматировать поприятнее
2016-08-24 Сменить заглавную картинку - сборка с датчиками линии
2016-08-24 Добавить картинку с собранной машинкой в конец
2016-08-24 Больше разноцветных рендеров
2016-08-24 Сборка и рендер машинки с датчиками линии
2016-08-24 Инструкция по подключению моторов через L293D
2016-08-24 Разные рендеры машинки в сборке
2016-08-24 Сшить брошюру для печати на А4
2017-08-18 Скетчи *.pde->*.ino
2018-05-07 Насадка с рейкой для шаговика (Inkscape+OpenSCAD)
    [box.scad, gear-pa20-cp1.5-t18.dxf, gear-pa20-cp1.5-t36.dxf, gears.scad, motor_face.dxf, rack-pa20-cp1.5-l160.dxf, smg-gear_motor-ds-pe0.1.stl, smg-gear_motor-ds-pe0.2.stl]
2018-06-02 Игнорировать node_modules и scad_modules для проектов NodeJS и OpenSCAD
2018-06-02 Исправить коменты
    [Arduino.scad]
